JamahaW/VART-Project/Изображения/Меню_Подготовки.jpg

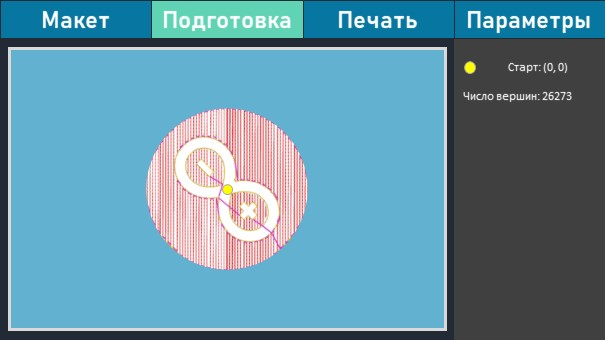
Изображения/Меню_Подготовки.jpg
