JamahaW/VART-Project/Изображения/РисунокПлоттера.jpg

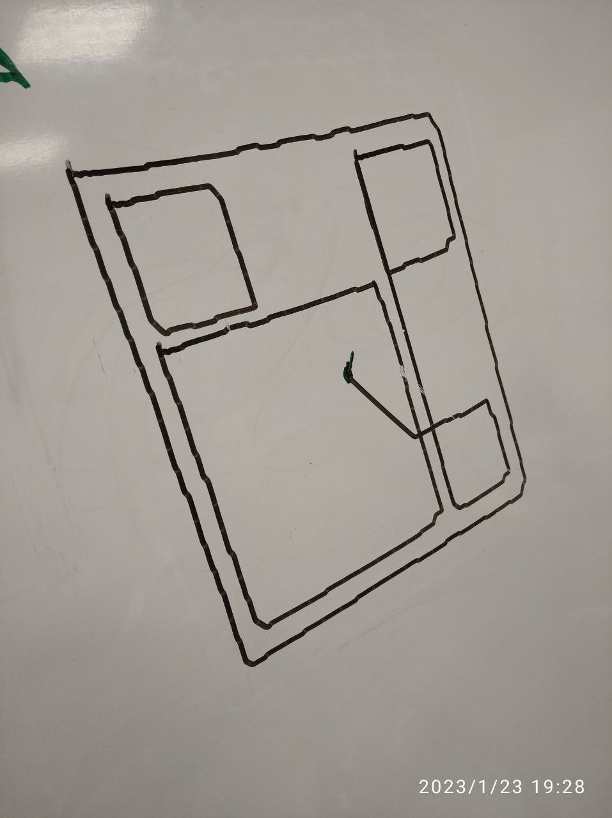
Изображения/РисунокПлоттера.jpg
