JamahaW/VART-Project/Документация/Презентации/Презентация3.pptx

Подготовка изображения для печати

1. Загрузка
изображения
2. Применение
фильтров
3. Расчёт
маршрута

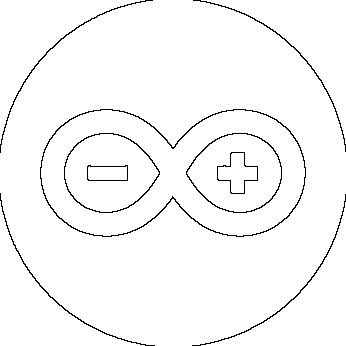
[picture p3: figure]

Алгоритм программы

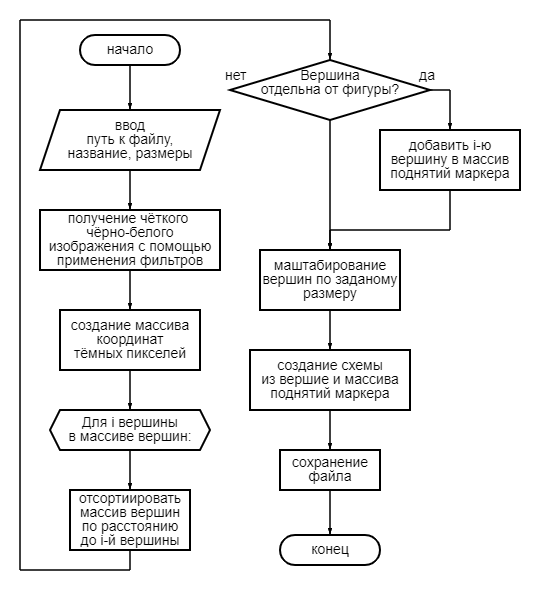
[picture p4: figure]
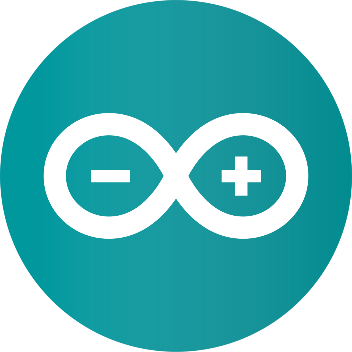
[picture p5: figure]
Arduino Logo PNG Transparent (1) – Brands Logos
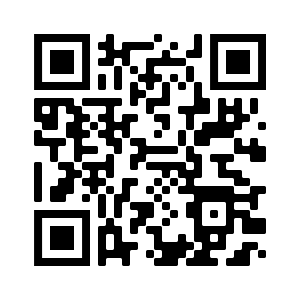
[picture p6: figure]
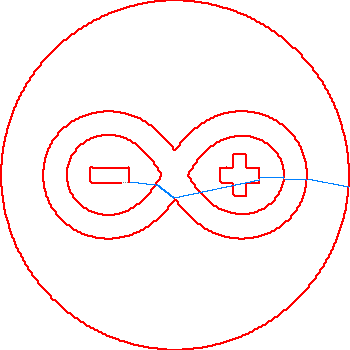
[picture p7: figure]

Исходный код конвертера изображений

Ссылка: https://github.com/JustPret/png2schem
