JamahaW/VART-Project/Документация/Презентации/Презентацияплоттер(2).pptx

## Вертикальный Маркерный плоттер

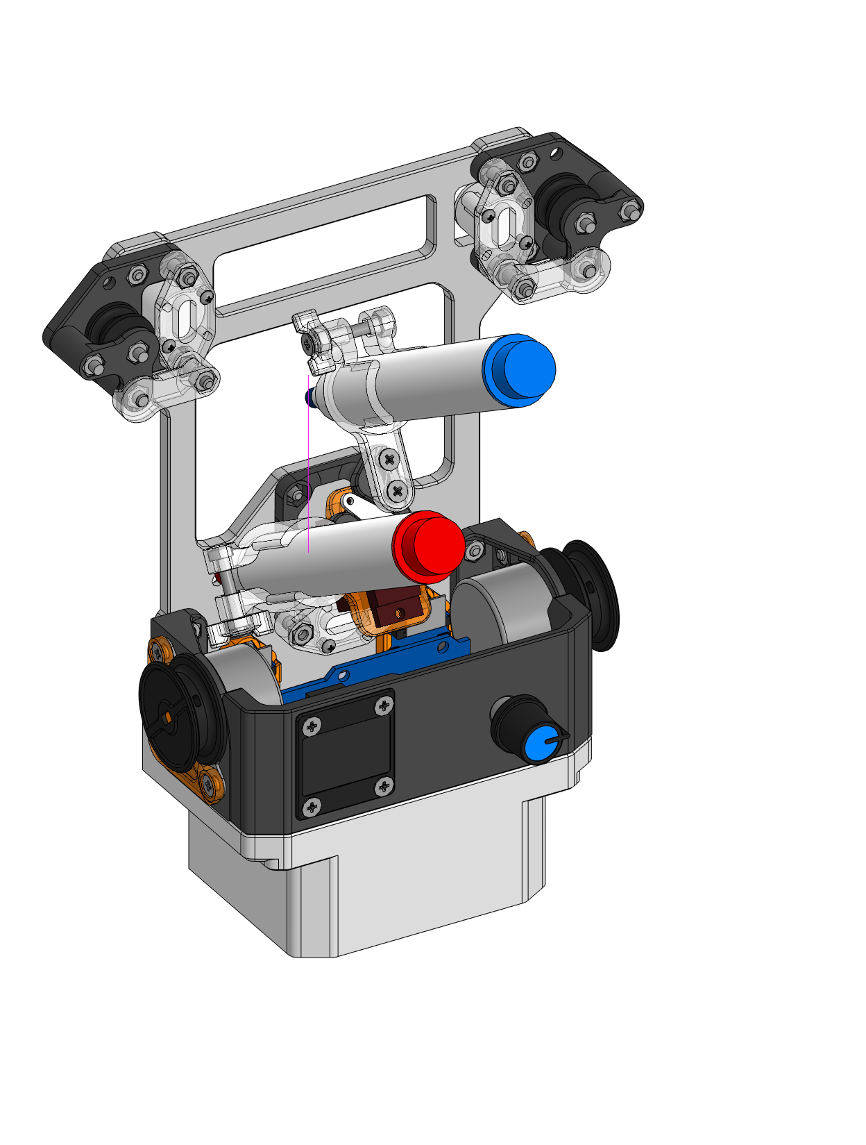
[picture p8: figure]

Выполнил: Наумов Максим Геннадьевич
Ученик ГАОУ школы №548

## Проблема и актуальность

- Для улучшения запоминания материала учителя могут рисовать памятки по теме, этот процесс занимает некоторое время, его можно автоматизировать, таким образом повысить качество материала и производительность рисования.
- Графическое оформление стен помещений широко применяется в дизайне.

## Пример оформления класса информатики к новому году

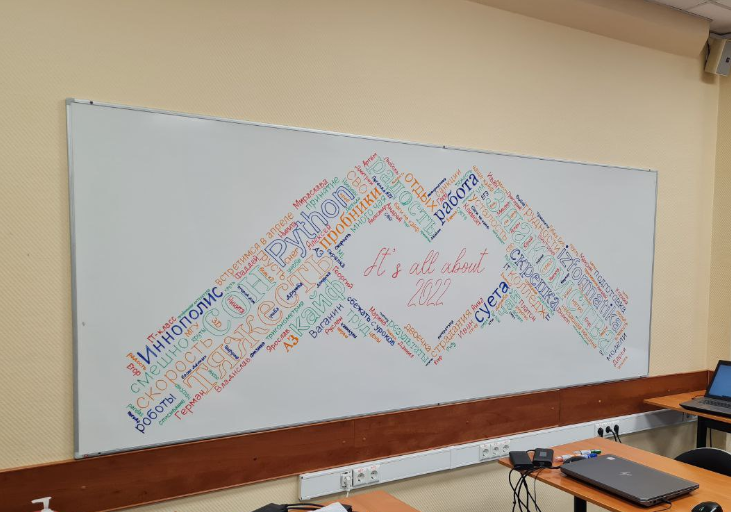
[picture p9: figure]

## Цель проекта

Создать устройство, автоматизирующее процесс рисования на маркерных досках

## Задачи проекта

- Изучить затраты времени на подготовку графических материалов по теме урока.
- Рассмотреть способы автоматизации рисования
- Разработка и сборка прототипа устройства
- Тестирование
- Анализ недостатков и улучшение изделия

## Slide 6

Ход разработки

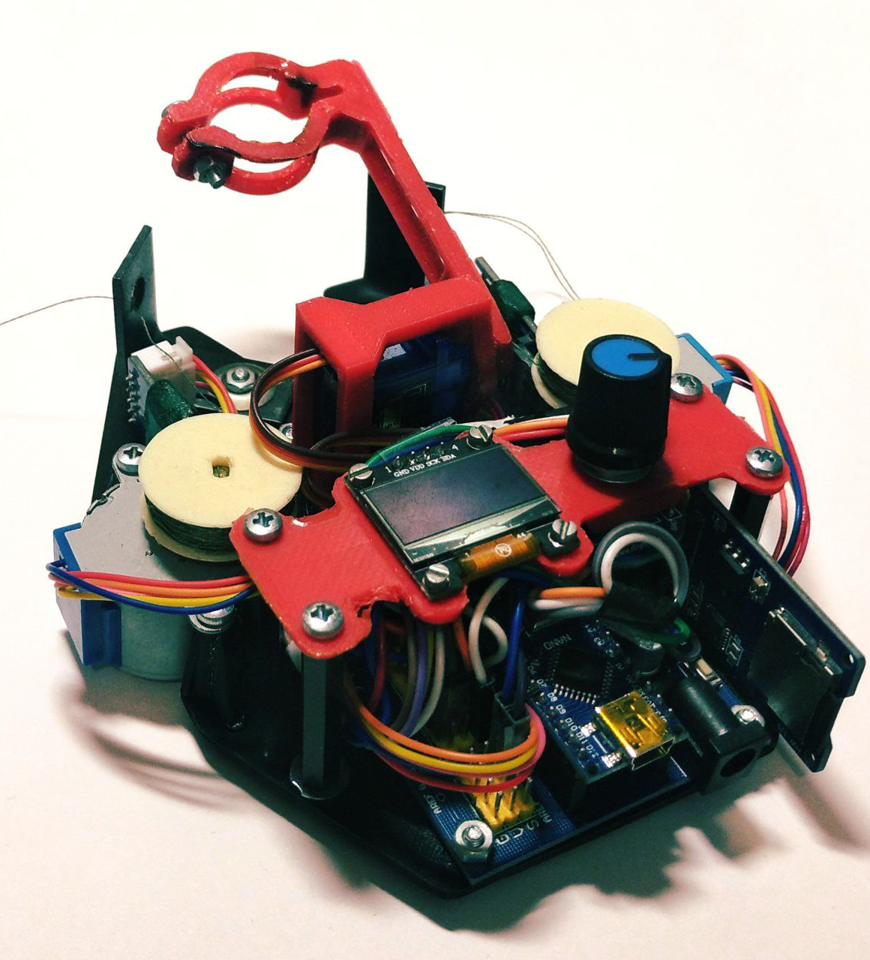
[picture p10: figure]

Прототип

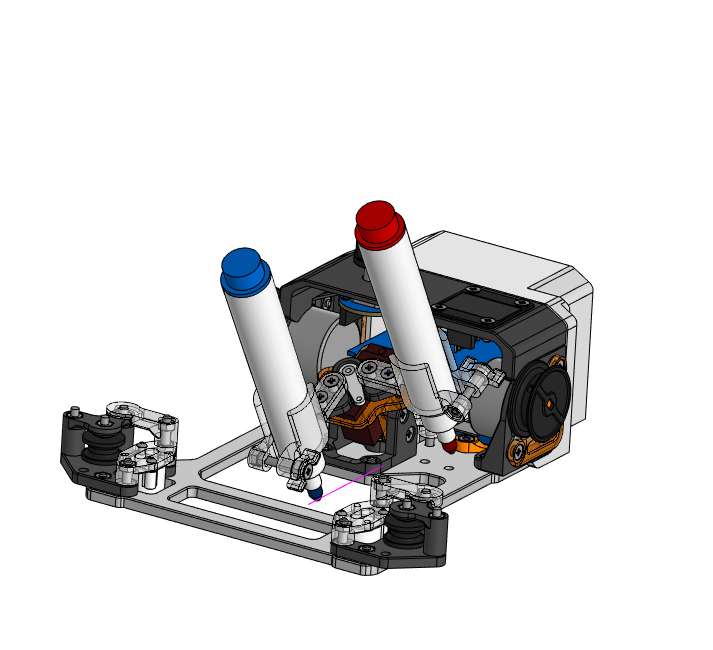
[picture p11: figure]

Текущая Модель изделия

## Работа плоттера

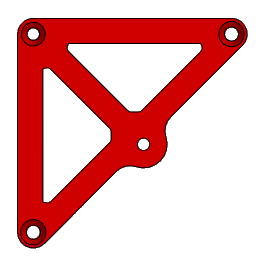
[picture p12: figure]
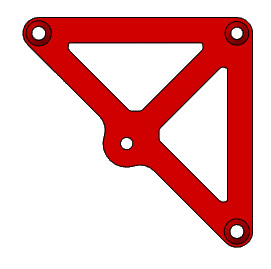
[picture p13: figure]
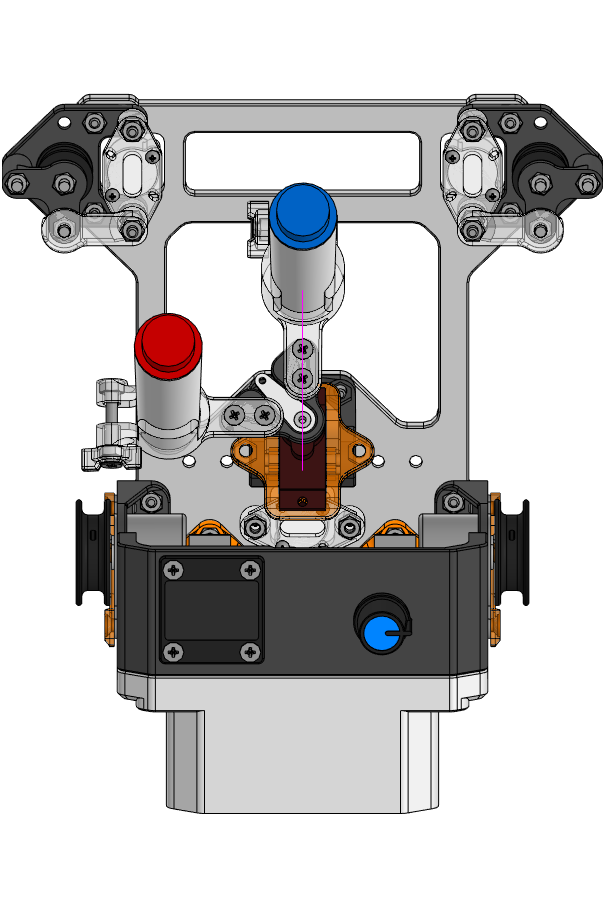
[picture p14: figure]

## Уголок-крепёж

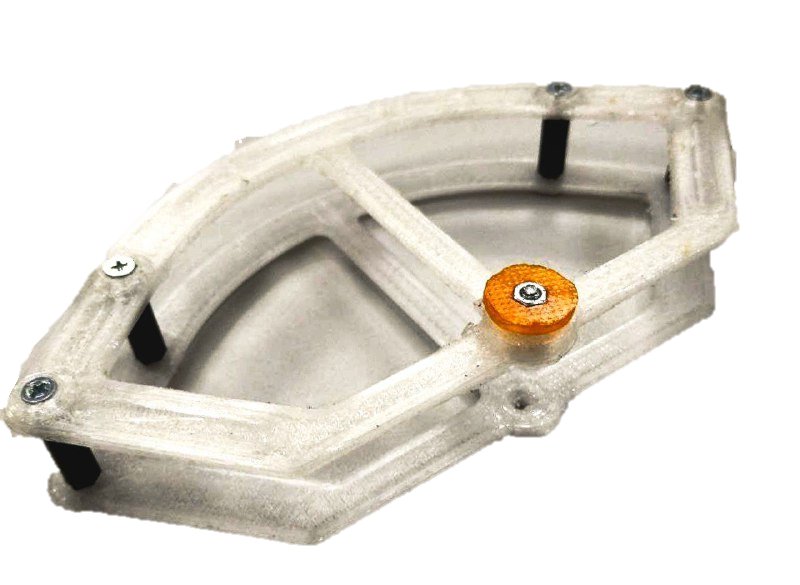
[picture p15: figure]

- Опора на маркерную доску

- Место крепления троса

## Привод намотки

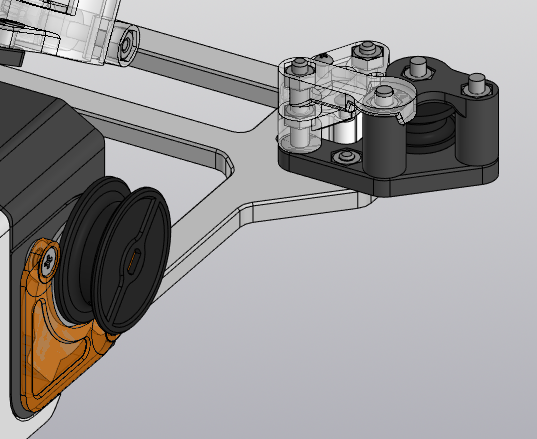
[picture p16: figure]

- Перенаправляющий ролик

- Шкив намотки

## Механизм смены цвета

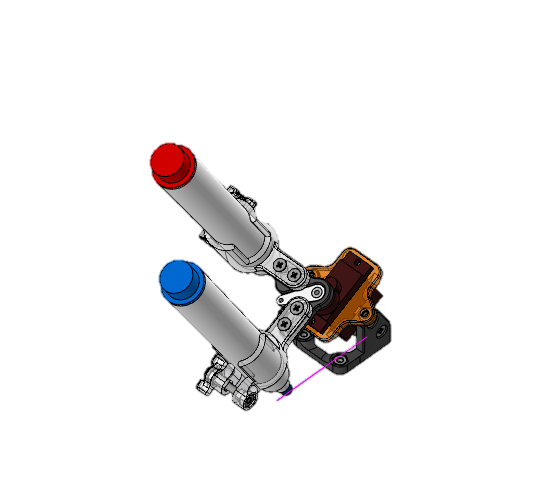
[picture p17: figure]
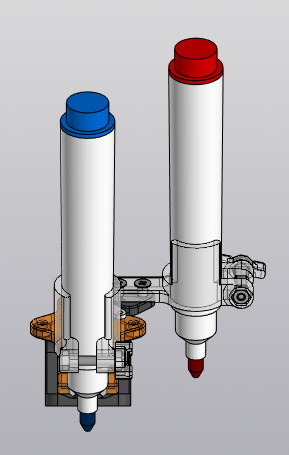
[picture p18: figure]
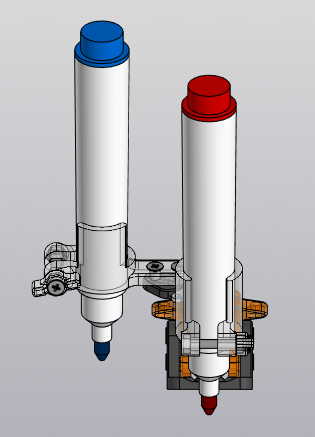
[picture p19: figure]
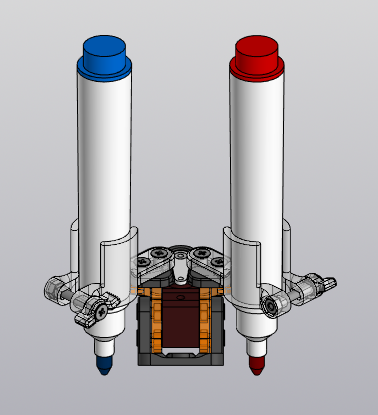
[picture p20: figure]

Угол поворота сервопривода меняет ведущий маркер.

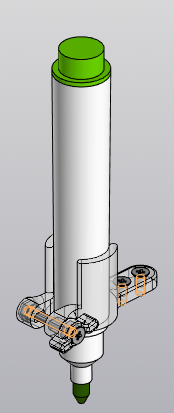
[picture p21: figure]

сервопривод

- Маркер

- Зажим с вариативным выбором нажатия

- Регулировка зажима

## Подготовка изображения к печати

Arduino Logo PNG Transparent (1) – Brands Logos

Исходное изображение

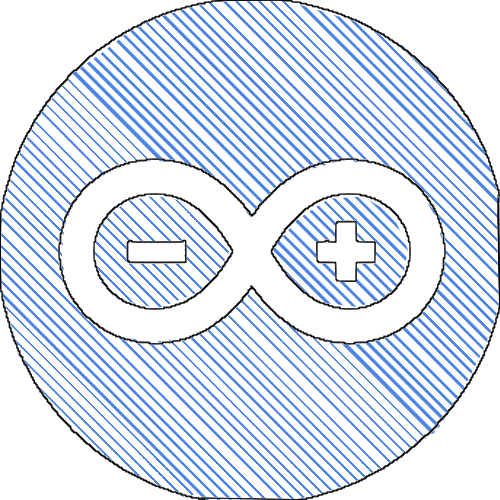
[picture p22: figure]

Задание параметров
рисования

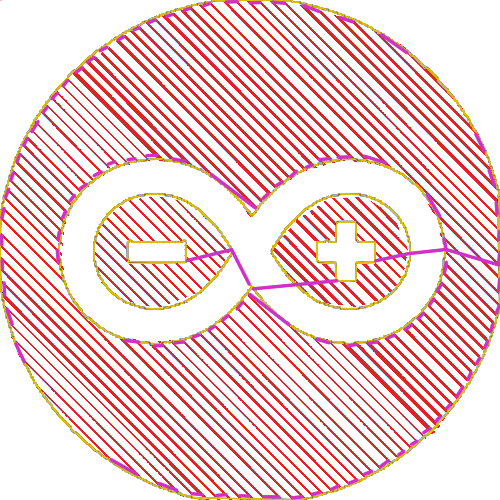
[picture p23: figure]

Расчёт
маршрута

## Функциональная схема

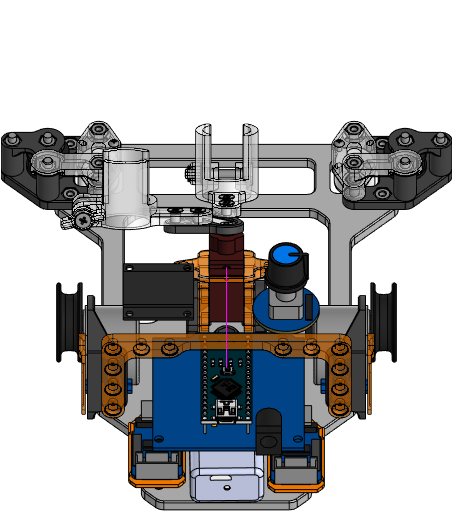
[picture p24: figure]

Маркерный плоттер без корпуса

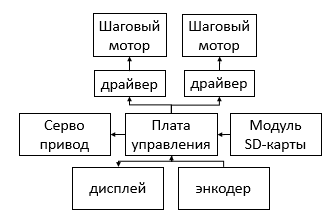
[picture p25: figure]

## Slide 13

Выбор электронных компонентов

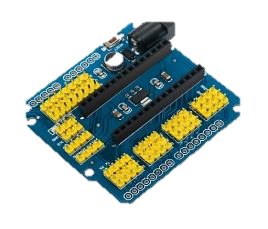
[picture p26: figure]
Плата расширения для Arduino Nano (Arduino Nano Shield V3.0) купить в Алматы

Плата расширения Nano

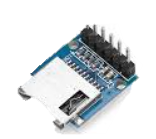
[picture p27: figure]

Mini Micro SD
Card Reader Module

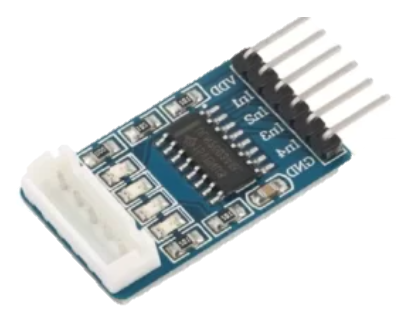
[picture p28: figure]
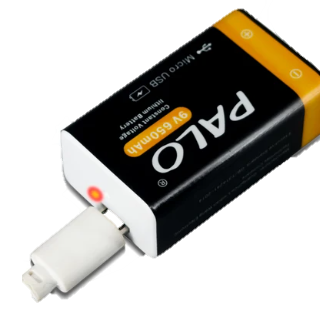
[picture p29: figure]

Аккумулятор 9B

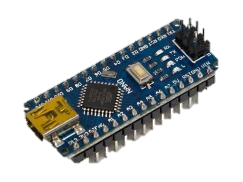
[picture p30: figure]
Купить Arduino NANO V 3.0 CH340G Arduino/ESP/Raspberry Pi (Доставка РФ,СНГ)

Arduino Nano

Драйвер ULN2003

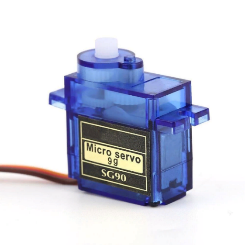
[picture p31: figure]

Сервопривод SG90

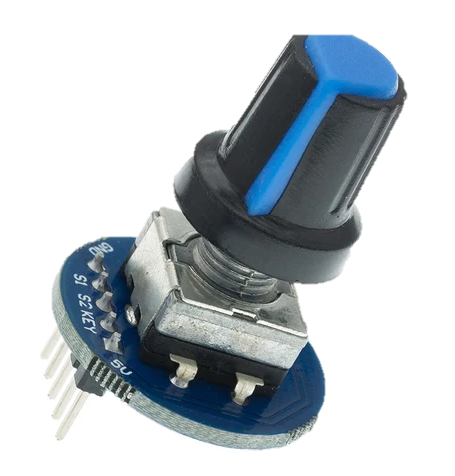
[picture p32: figure]

Энкодер

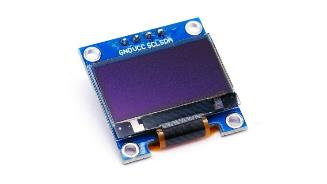
[picture p33: figure]
Nettigo: OLED Display 0.96" I2C 128x64 SSD1306 white [Yā nǔ shén]

OLED дисплей

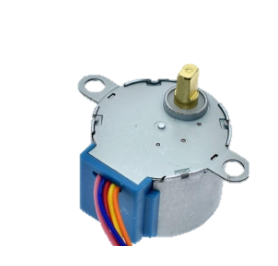
[picture p34: figure]

Шаговый двигатель 28BYJ-48

## Оценка стоимости изделия

1676 рублей

- 1230р – электронные компоненты
- 350р – 3D-печать пластиковых деталей
- 96р – крепёжные изделия

## Электрическая схема изделия

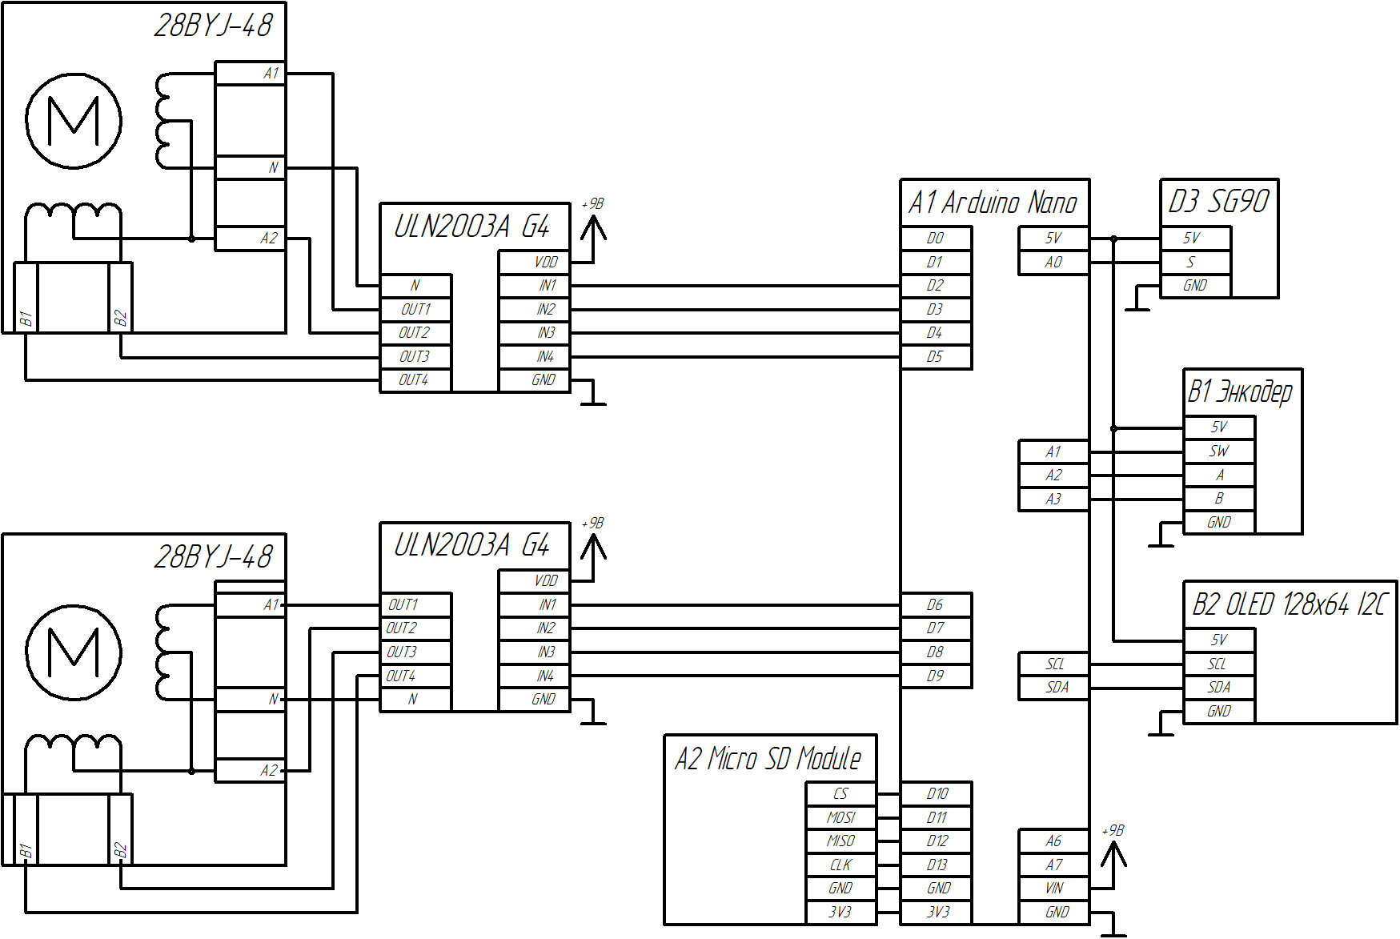
[picture p35: figure]

## Slide 16

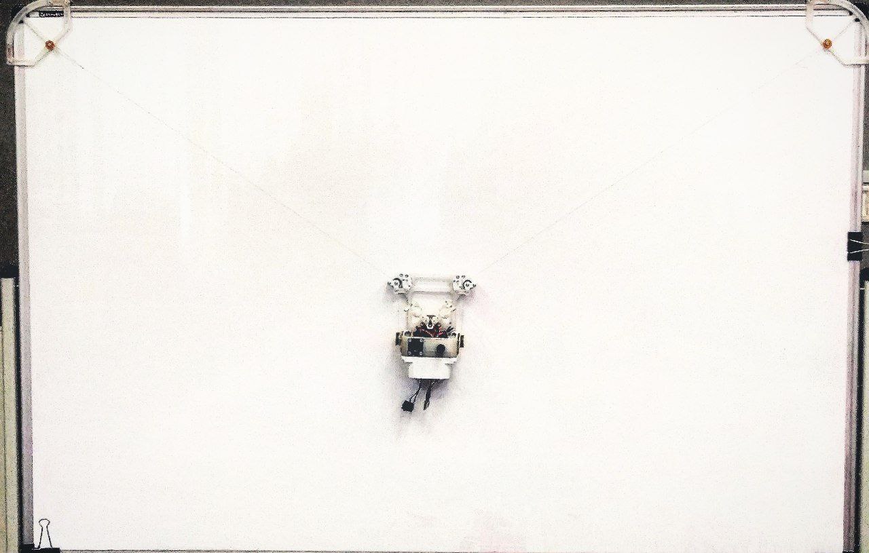
[picture p36: figure]
