JamahaW/VART-Project/Документация/Презентации/Презентацияплоттер_старая!!!!.pptx

## Вертикальный Маркерный плоттер


Выполнил: Наумов Максим Геннадьевич
Ученик ГАОУ школы №548

## Проблема и актуальность

- Для улучшения запоминания материала учителя могут рисовать памятки по теме, этот процесс занимает некоторое время, его можно автоматизировать, таким образом повысить качество материала и производительность рисования.
- Графическое оформление стен помещений широко применяется в дизайне.
*большие площади
*автоматизация дизайна

## Пример оформления класса информатики к новому году


## Цель проекта

Создать устройство, автоматизирующее процесс рисования на маркерных досках

## Задачи проекта

- Изучить затраты времени на подготовку графических материалов по теме урока.
- Рассмотреть способы автоматизации рисования
- Разработка и сборка прототипа устройства
- Тестирование
- Анализ недостатков и улучшение изделия
- Тестирование
- Выводы

## Slide 6

Ход разработки


Прототип


Текущая Модель изделия

## Работа плоттера


## Уголок-крепёж

- Опора на маркерную доску

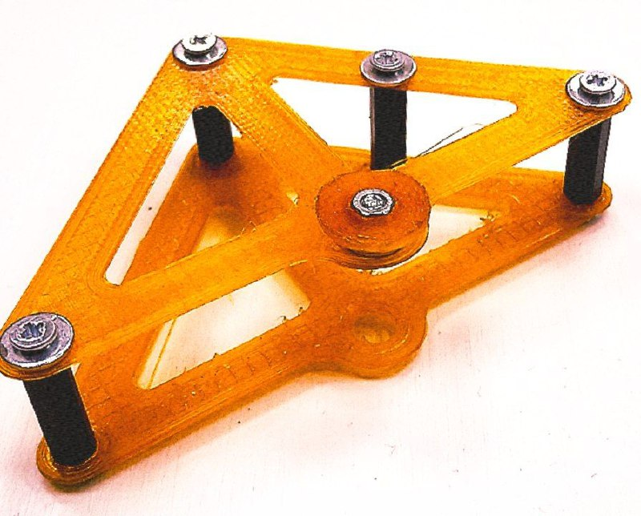
[picture p37: figure]

- Место крепления троса

## Привод намотки


- Перенаправляющий ролик

- Шкив намотки

## Механизм смены цвета


Угол поворота сервопривода меняет ведущий маркер.


сервопривод

- Маркер

- Зажим с вариативным выбором нажатия

- Регулировка зажима

## Подготовка изображения к печати

Arduino Logo PNG Transparent (1) – Brands Logos

Исходное изображение


Задание параметров
рисования


Расчёт
маршрута

## Функциональная схема


Маркерный плоттер без корпуса


## Slide 13

Выбор электронных компонентов

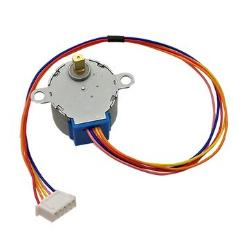
[picture p38: figure]
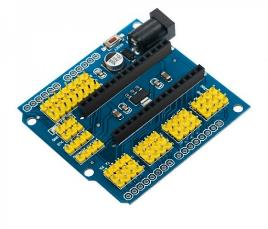
[picture p39: figure]
Плата расширения для Arduino Nano (Arduino Nano Shield V3.0) купить в Алматы
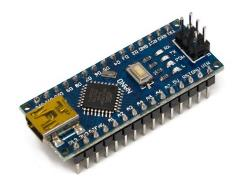
[picture p40: figure]
Купить Arduino NANO V 3.0 CH340G Arduino/ESP/Raspberry Pi (Доставка РФ,СНГ)
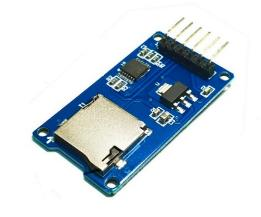
[picture p41: figure]
SD Card модуль

Плата расширения Nano
200р

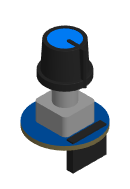
[picture p42: figure]

Энкодер
60р

Arduino Nano
250р

Nettigo: OLED Display 0.96" I2C 128x64 SSD1306 white [Yā nǔ shén]

OLED дисплей
140р

Mini TF Card Module
40р


Сервопривод SG90
300р

(2шт.) Шаговый мотор 28BYJ-48
180р

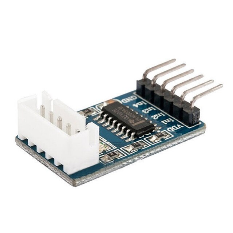
[picture p43: figure]

(2шт.) Драйвер ULN2003
50р

## Оценка стоимости изделия

1660 рублей

- 1220р – электронные компоненты
- 350р – 3D-печать пластиковых деталей
- 90р – крепёжные изделия

## Электрическая схема изделия
