JamahaW/VART-Project/Документация/Компоненты.pdf

# Выбор электронных компонентов

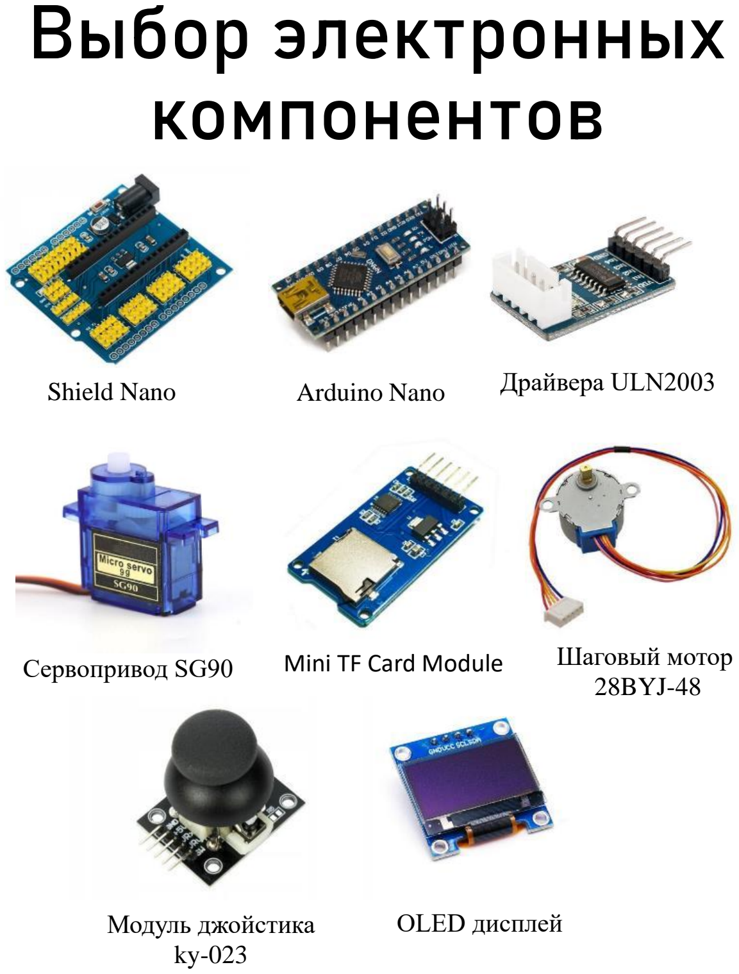
[picture p44: page 1]

Shield Nano | Arduino Nano
Cервопривод SG90 | Mini TF Card Module

Драйвера ULN2003

Шаговый мотор
28BYJ-48

Модуль джойстика
ky-023

OLED дисплей
