JamahaW/VART-Project/Документация/Выступлениечерновик2план.docx

Выступление новый черновик

План

Введение

- об учителях, которые рисуют схемы

- о китайской поделке

- о том, что я решил это сделать

- об актуальности графического оформления

Цель

- о том, что решил создать. Т.к. это актуально.

- сформулировал ряд задач

Разработка

- об изучении технологии печати

- о разновидностях манипуляторов + упоминание китайской поделки

- о тросовых роботах

Шаги разработки

-шаг 1

-шаг 2

-шаг 3

-шаг финал

- о конструкции

Конвертер схемы

-процесс конвертации

-о формате файла

- о меню плоттера

Вывод

- о проведённых испытаниях + о стоимости

- о том, что устройство уже использовалось + хорошо

- об улучшении отрисовке текста и это вина нарезчика

-о других применениях конструкции (зондирование)
