JamahaW/VART-Project/Документация/Алгоритм_плоттера.pdf

# Алгоритм плоттера

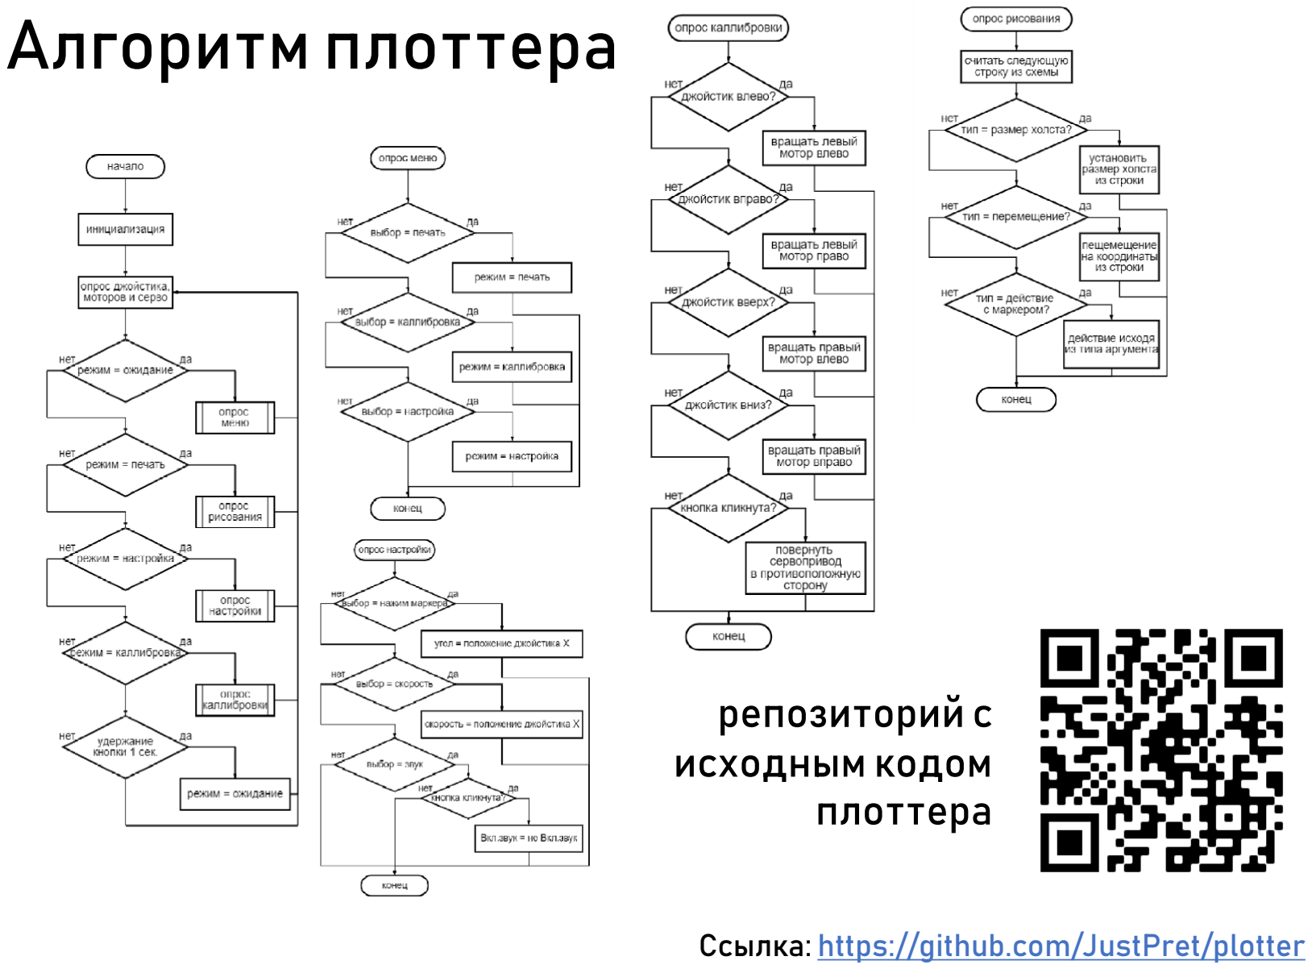
[picture p80: page 1]

Ссылка: https://github.com/JustPret/plotter

## репозиторий с исходным кодом плоттера
