JamahaW/VART-Project/Документация/Алгоритмы.pdf

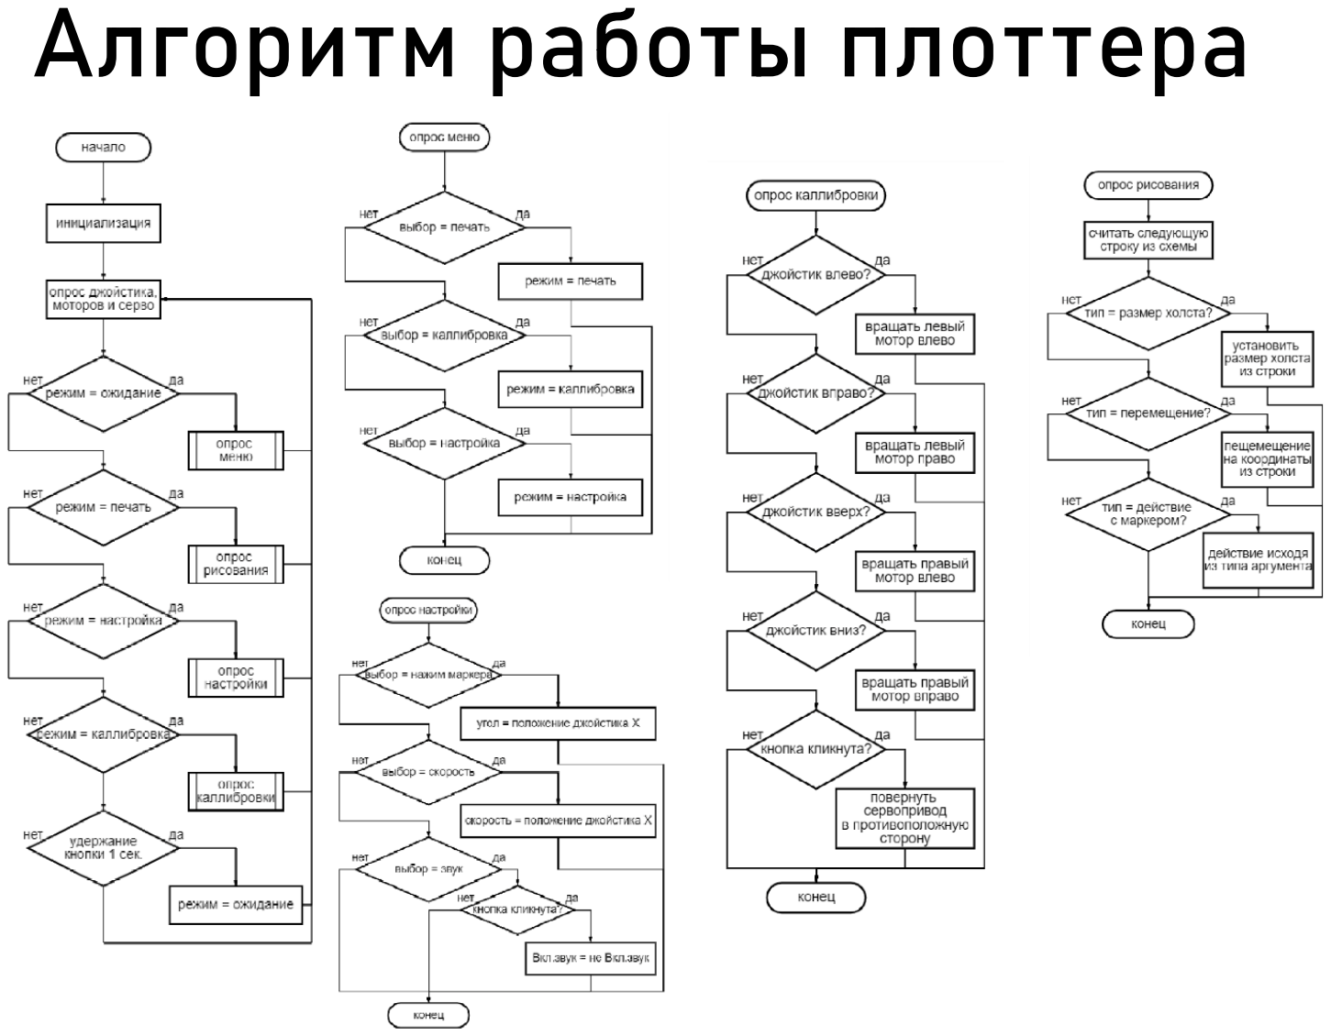
[picture p81: page 1]

Алгоритм работы плоттера
