JamahaW/VART-Project/Документация/Вид_плоттера.pdf

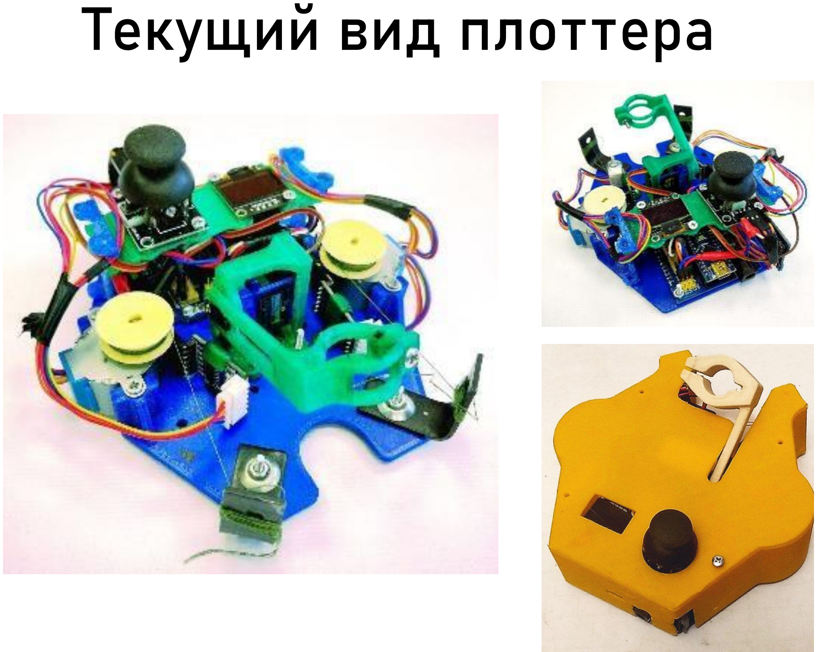
[picture p82: page 1]

Текущий вид плоттера
