JamahaW/VART-Project/Документация/Изображение.pdf

## Подготовка изображения для печати

## 1. Загрузка

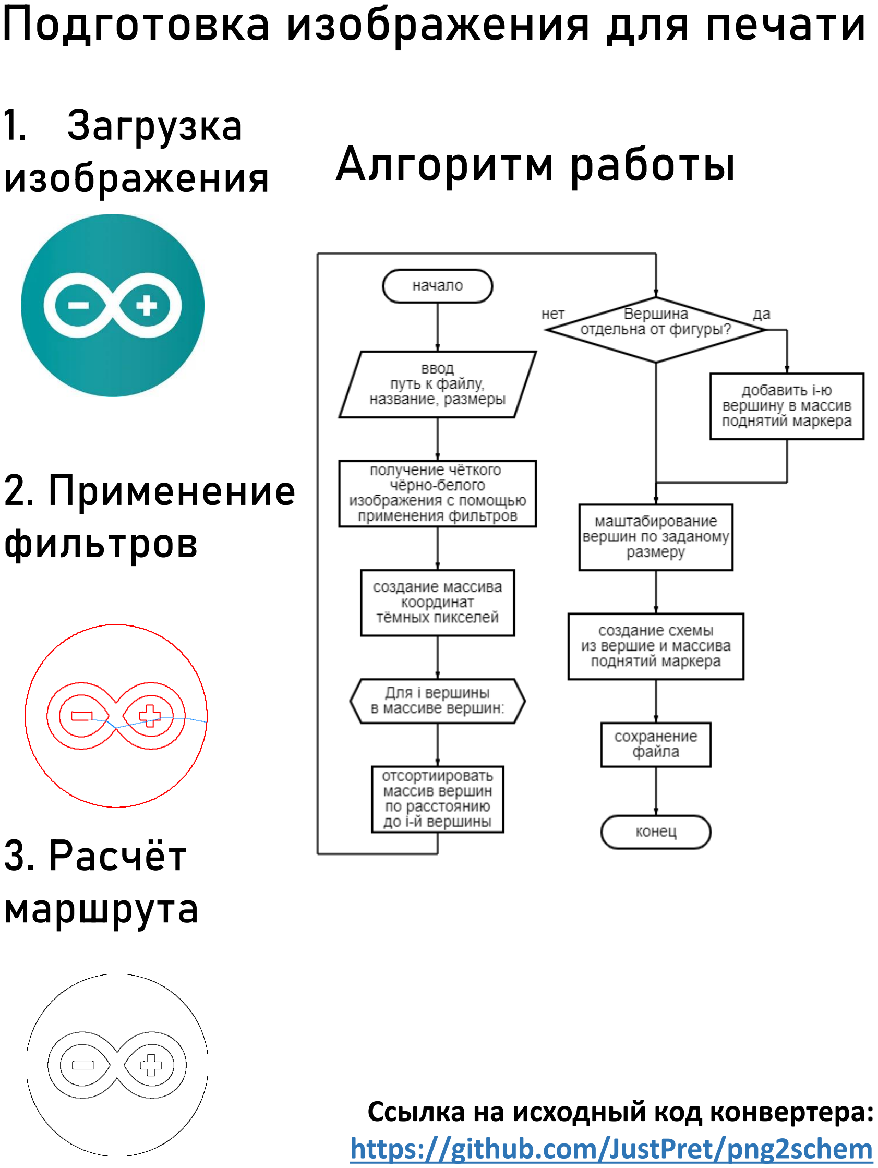
[picture p83: page 1]

Ссылка на исходный код конвертера: https://github.com/JustPret/png2schem

## изображения

## 2. Применение фильтров

## 3. Расчёт маршрута

## Алгоритм работы
