JamahaW/VART-Project/Документация/Отзыв-наумовмаксим.pdf

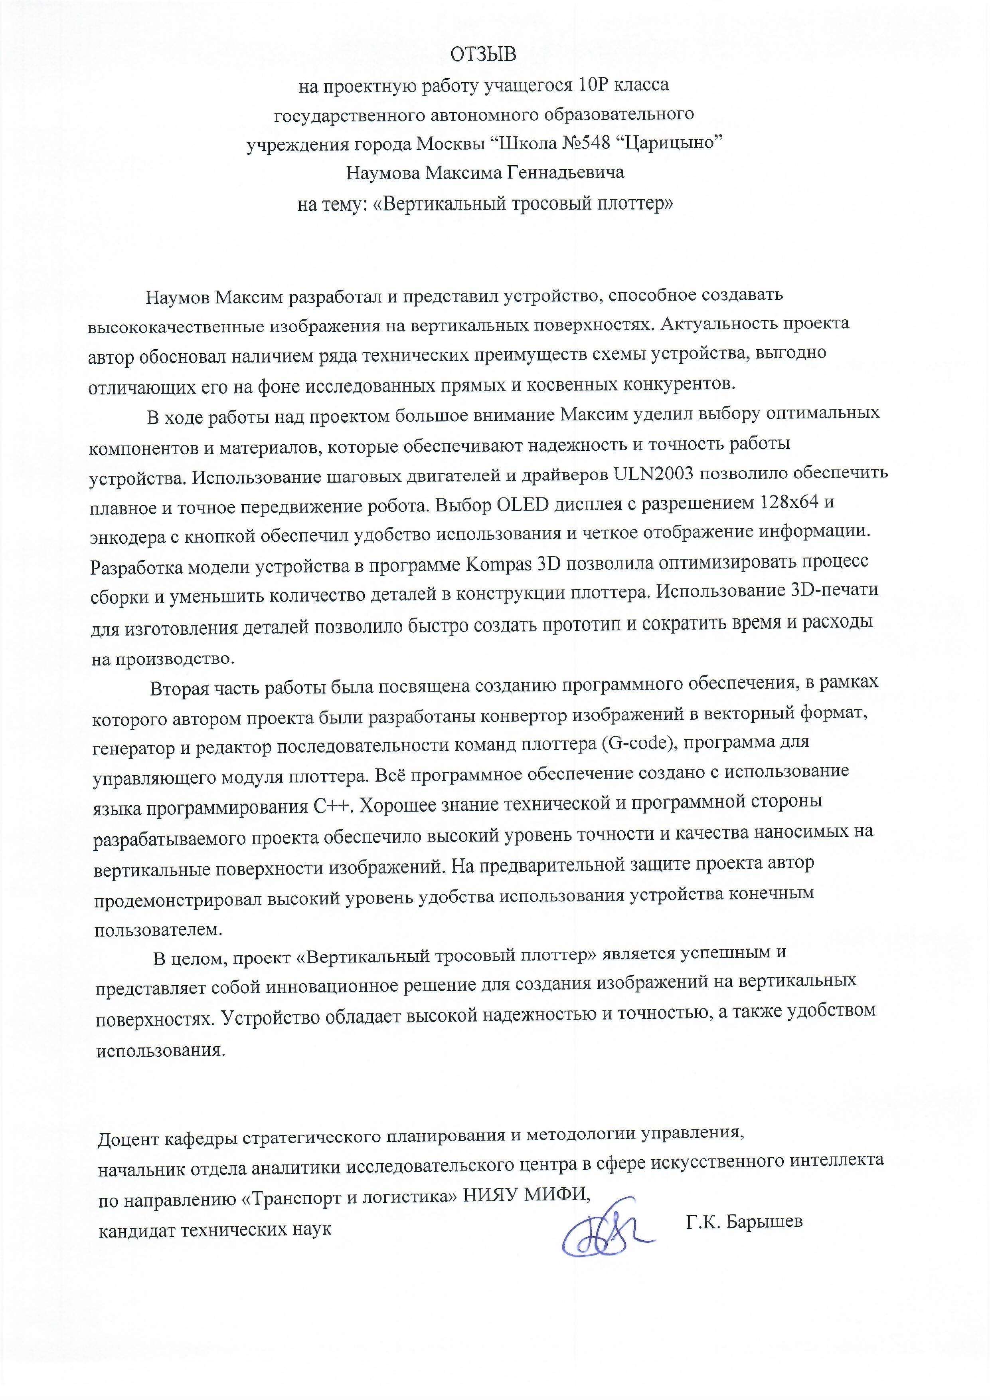
[picture p84: page 1]
