JamahaW/VART-Project/Документация/Плоттерфиналсракурсов.pdf

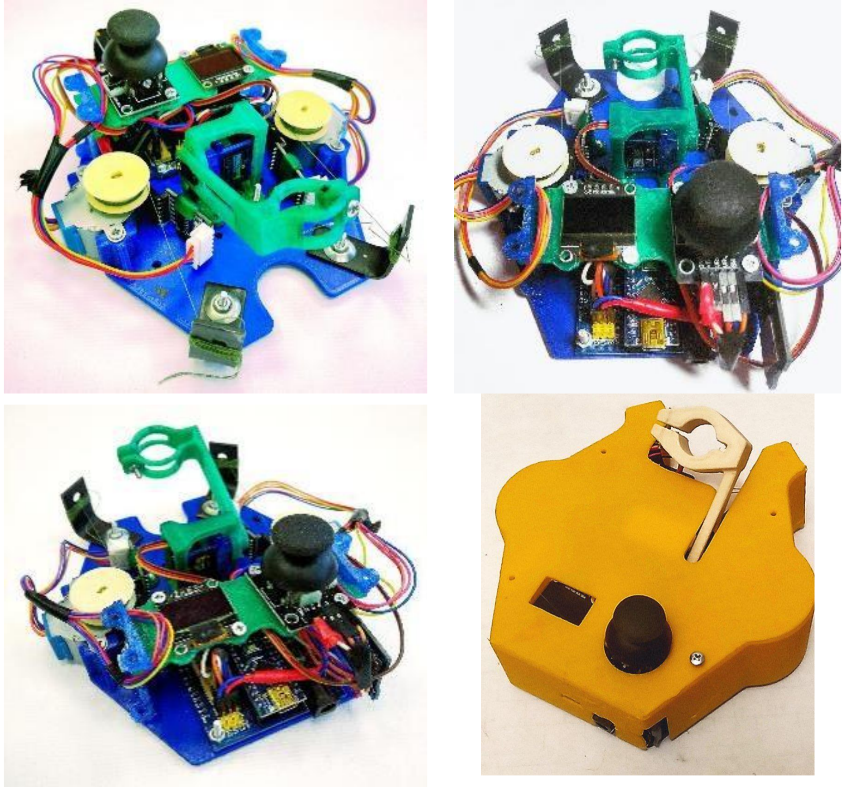
[picture p154: page 1]
