JamahaW/VART-Project/Документация/Презентация_210224.pdf

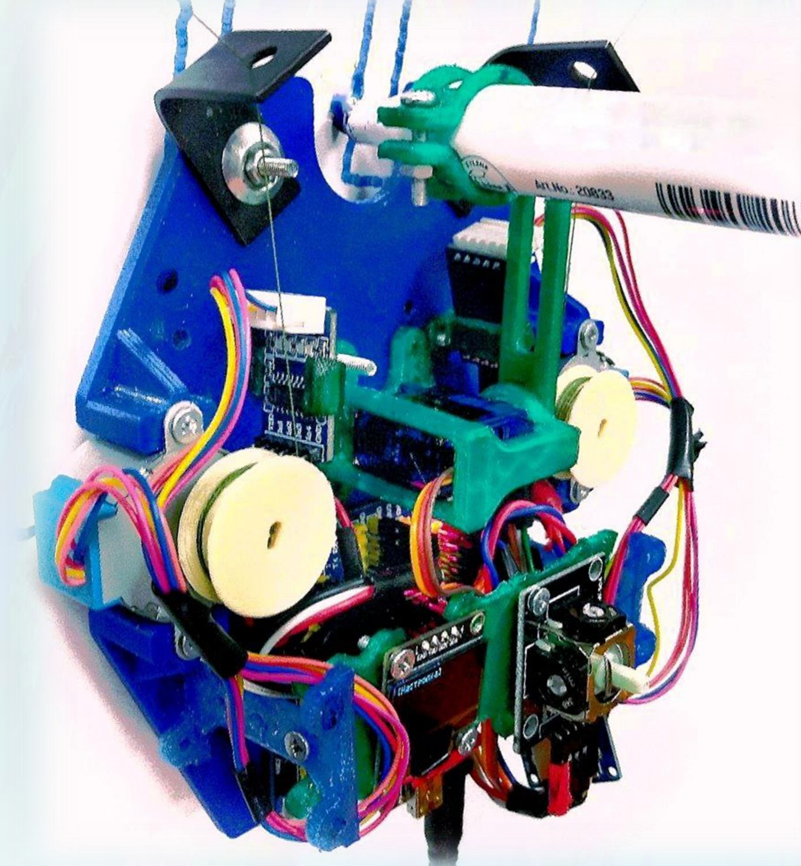
[picture p155: figure]

# Проект «Маркерный настенный плоттер»

Выполнил:
Наумов Максим Геннадьевич
Руководитель проекта:
Мазуров Максим Олегович

# Актуальность работы

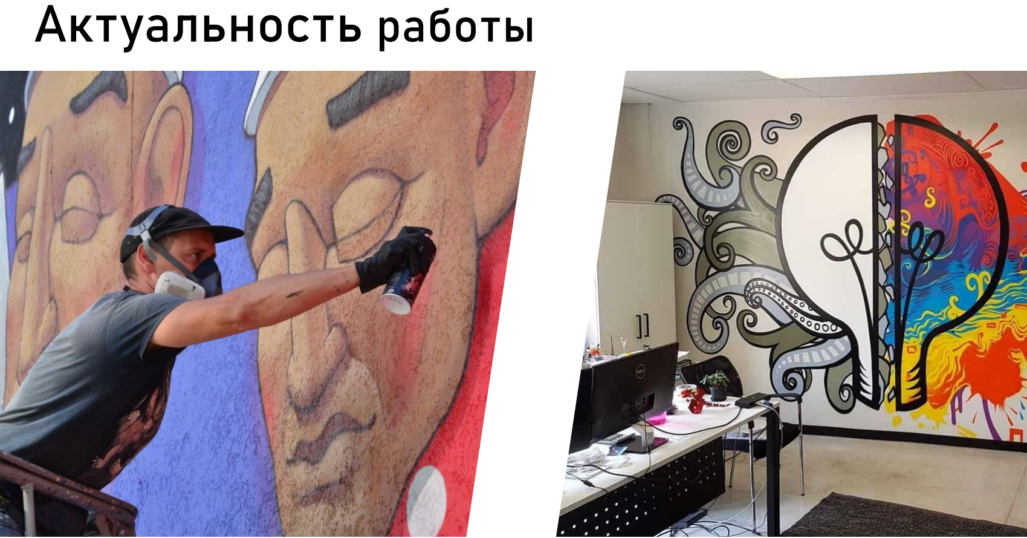
[picture p156: page 2]

## Цель проекта

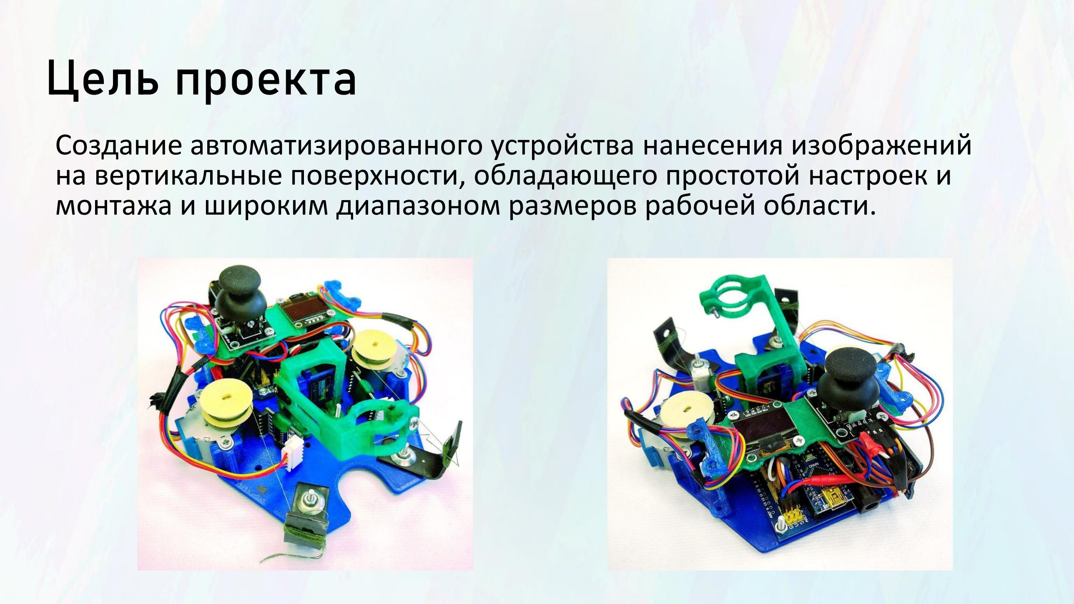
[picture p157: page 3]

Создание автоматизированного устройства нанесения изображений на вертикальные поверхности, обладающего простотой настроек и монтажа и широким диапазоном размеров рабочей области.

## Анализ существующих подходов и решений

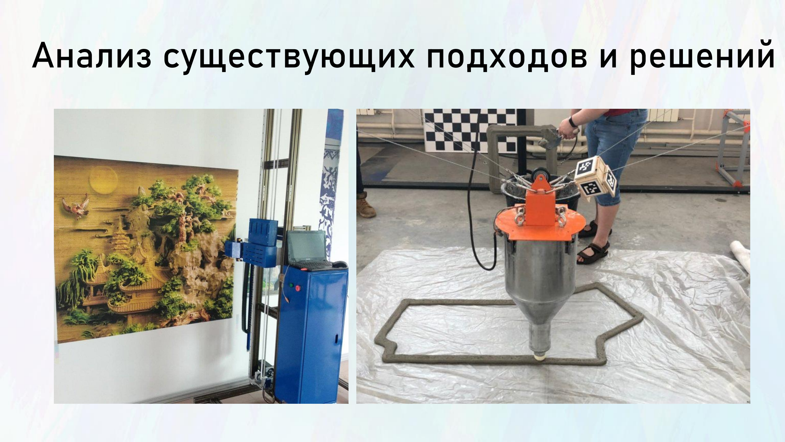
[picture p158: page 4]

## Ход работ

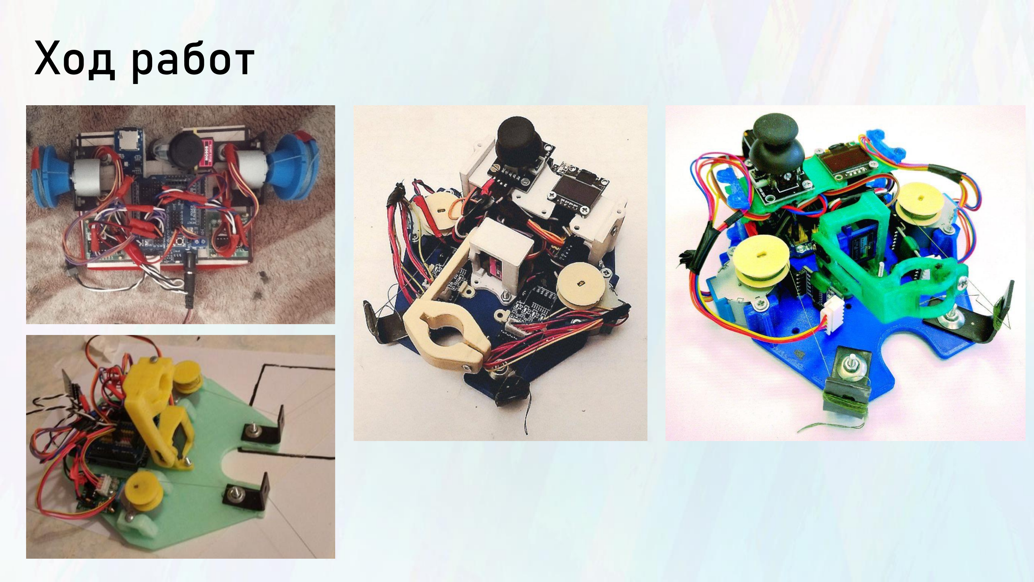
[picture p159: page 5]

## Прототип в действии

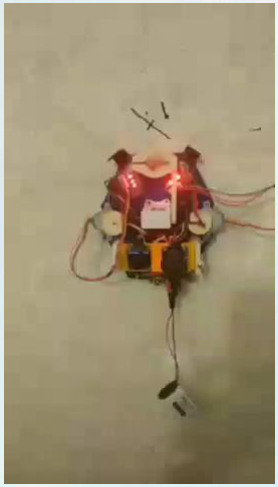
[picture p160: figure]
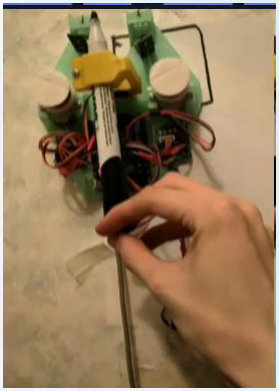
[picture p161: figure]

# Конвертирование изображений

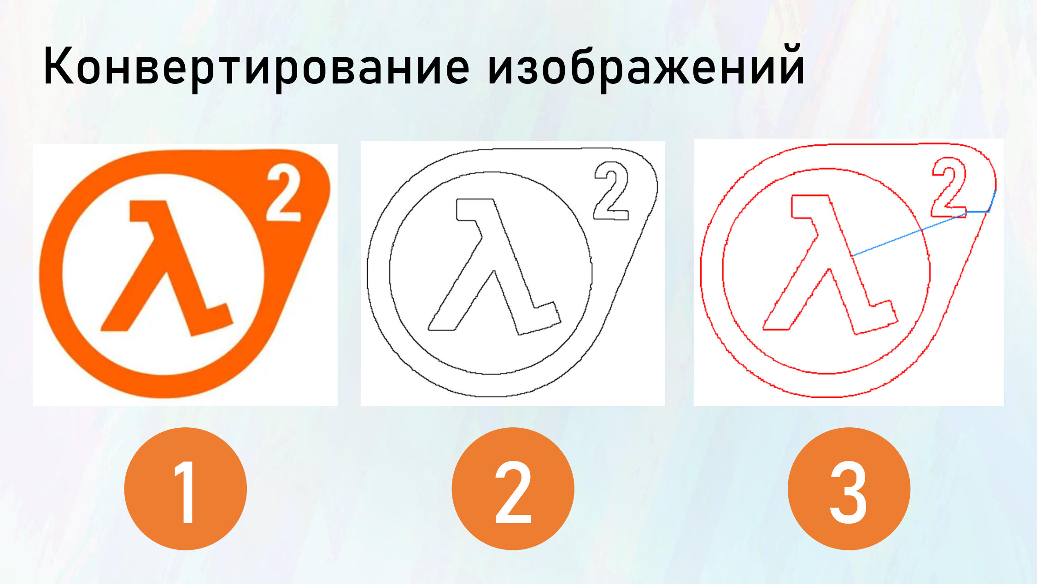
[picture p162: page 7]

1 | 2 | 3

# Обзор аналогов

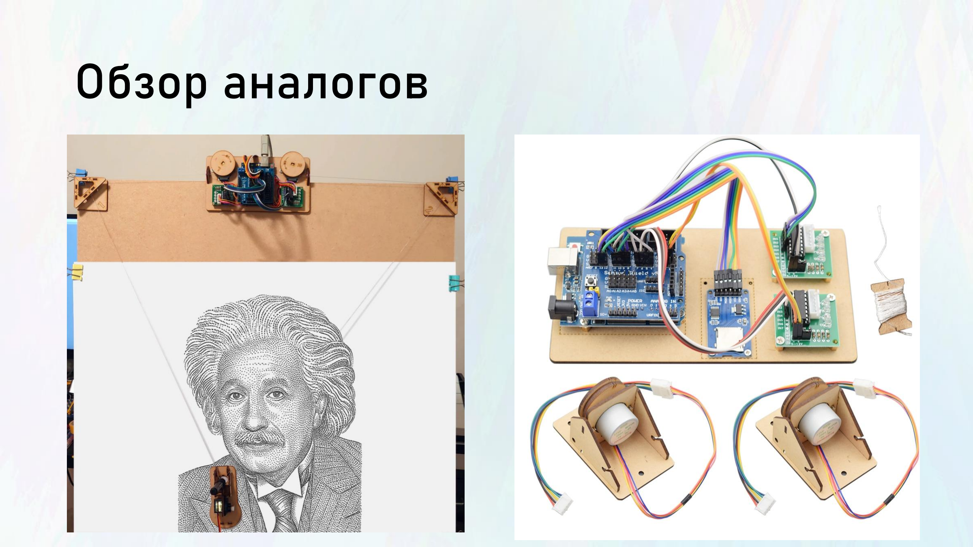
[picture p163: page 8]

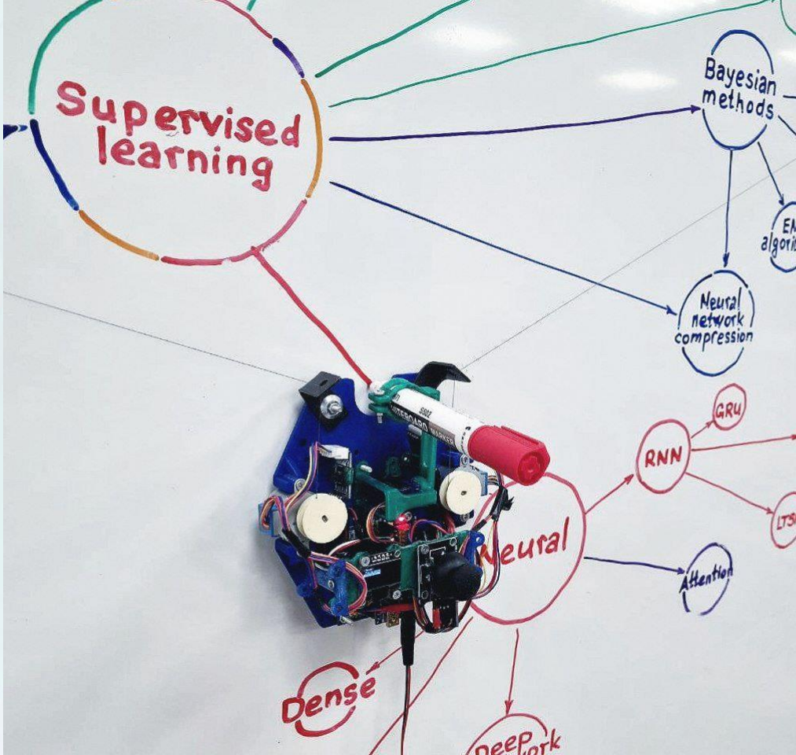
[picture p164: figure]

# Заключение

### Создан работоспособный прототип

Ссылка на репозиторий
с исходным кодом:
https://github.com/JustPret/plotter.git
