JamahaW/VART-Project/Документация/Программаподготовкиизбражений.pdf

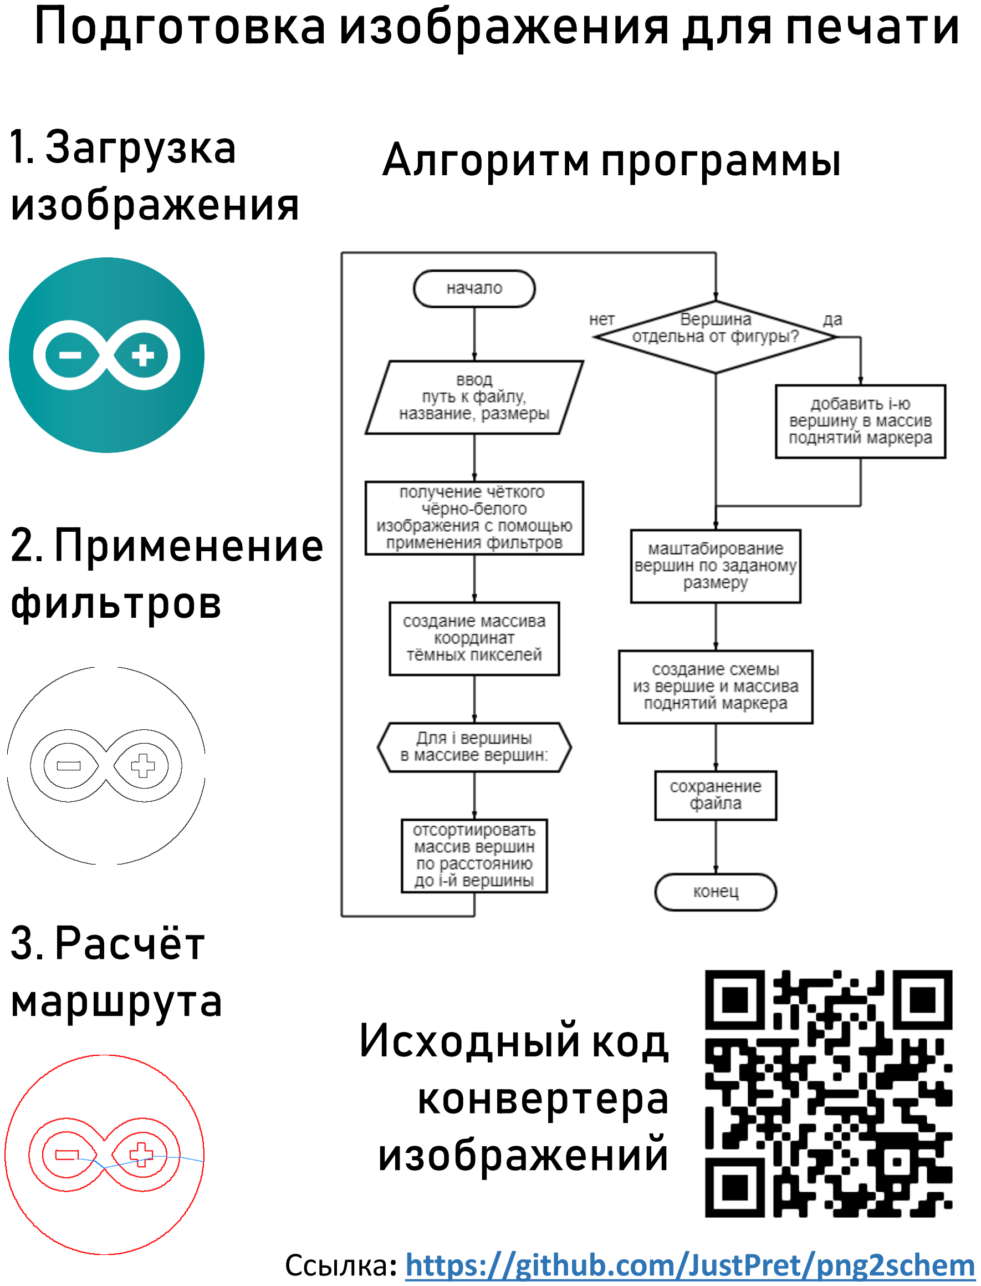
[picture p165: page 1]

1. Загрузка
изображения
2. Применение
фильтров
3. Расчёт
маршрута

Подготовка изображения для печати

Ссылка: https://github.com/JustPret/png2schem

Алгоритм программы

Исходный код
конвертера
изображений
