JamahaW/VART-Project/Документация/Устройствоплоттера.pdf

# Устройство плоттера

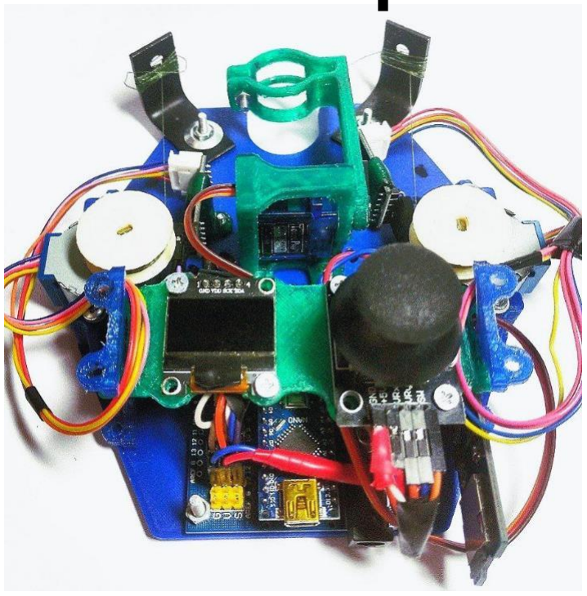
[picture p166: figure]
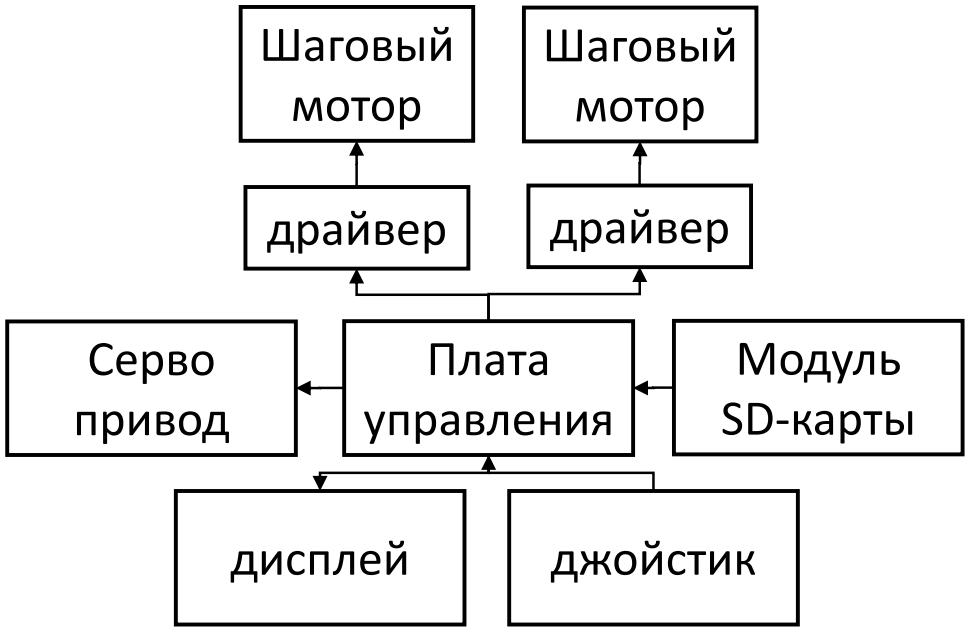
[picture p167: figure]
Плата управления; дисплей; джойстик; Серво привод; Шаговый мотор; драйвер; Модуль SD-карты
