JamahaW/VART-Project/Документация/Ходразработки.pdf

# Ход разработки

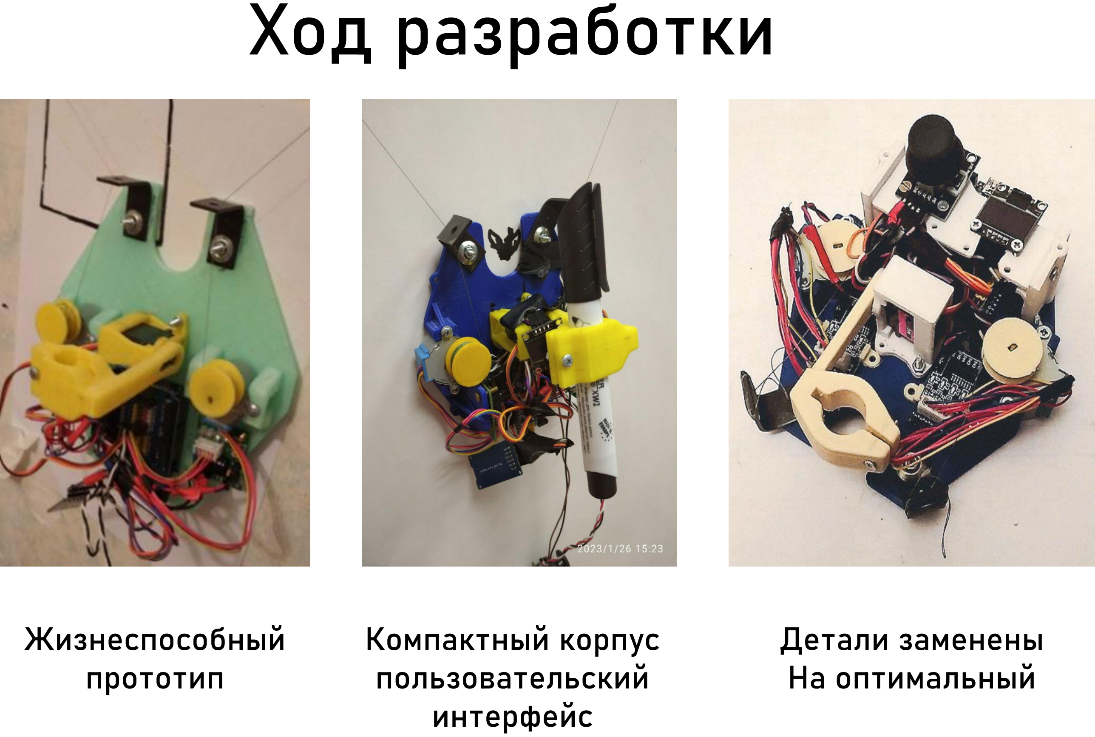
[picture p168: page 1]

Жизнеспособный
прототип

Компактный корпус
пользовательский
интерфейс

Детали заменены
На оптимальный
