JamahaW/VART-Project/Изображения/Bear_Polygon.png

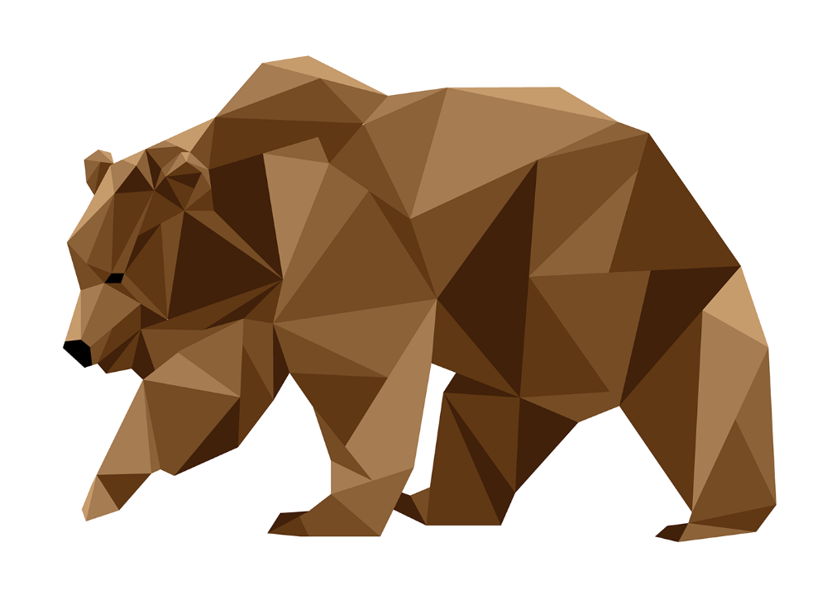
Изображения/Bear_Polygon.png
