JamahaW/VART-Project/Изображения/Cat_Photo.png

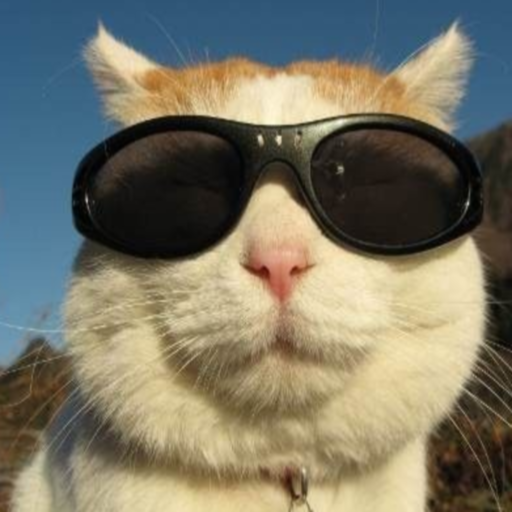
Изображения/Cat_Photo.png
