JamahaW/VART-Project/Изображения/Com_1-2.jpg

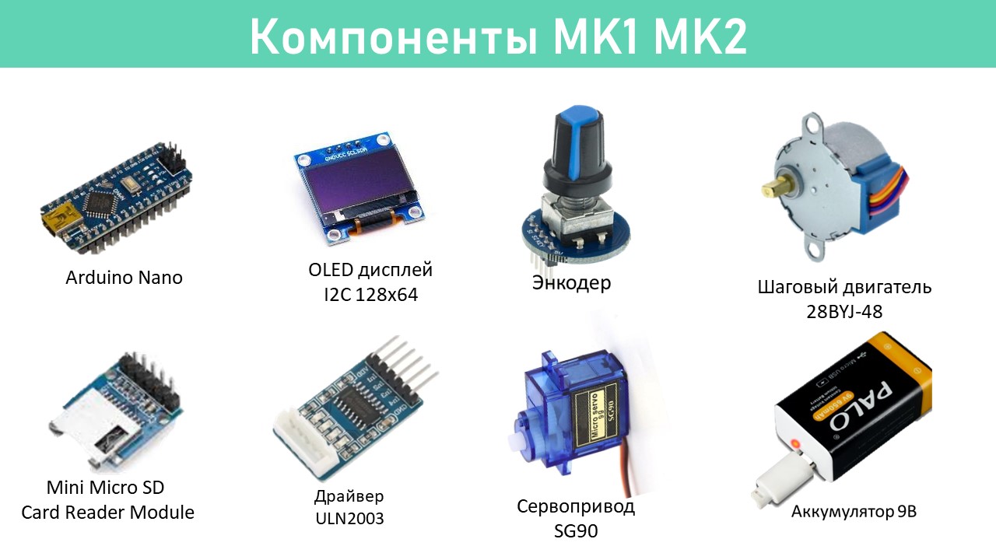
Изображения/Com_1-2.jpg
