JamahaW/VART-Project/Изображения/Com_3jpg.jpg

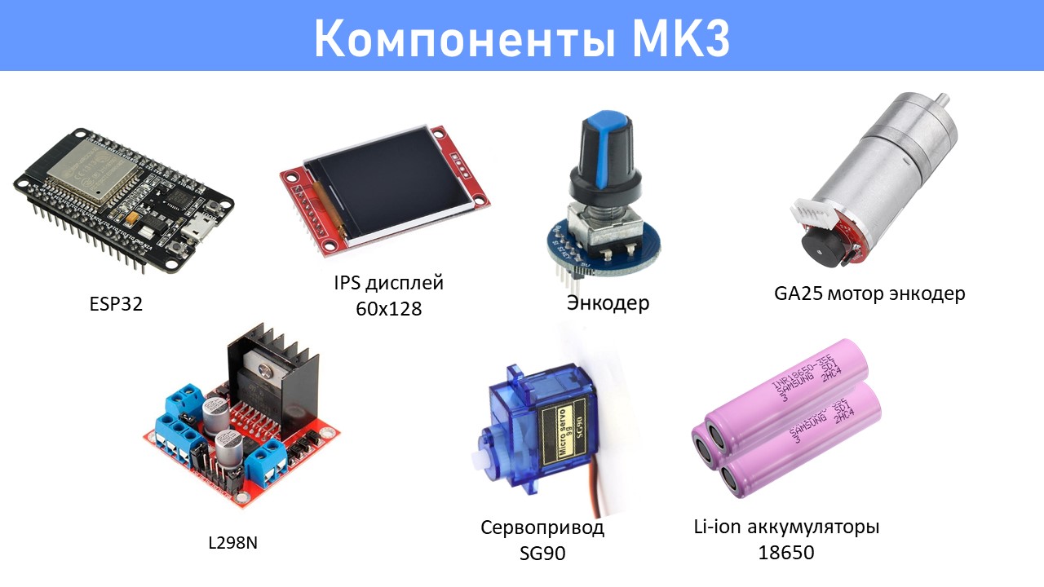
Изображения/Com_3jpg.jpg
