JamahaW/VART-Project/Изображения/А1.png

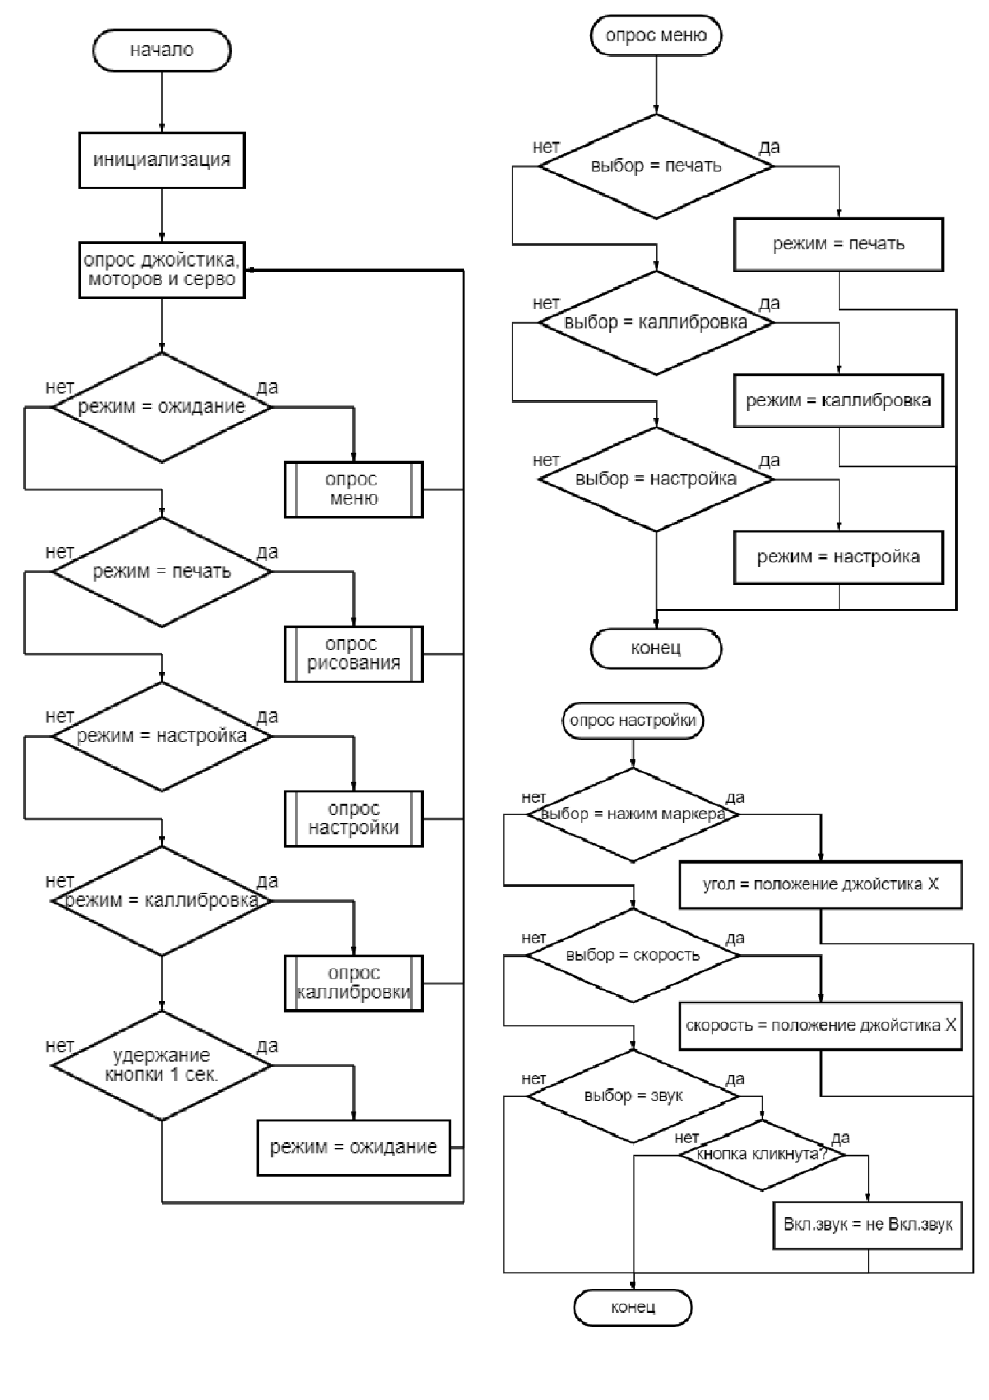
Изображения/А1.png
