JamahaW/VART-Project/Изображения/Аккумуляторная_Сборка_3s.png

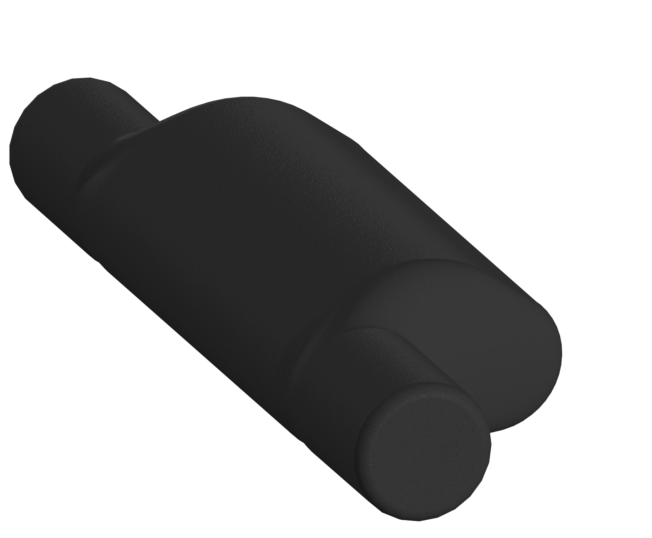
Изображения/Аккумуляторная_Сборка_3s.png
