JamahaW/VART-Project/Изображения/Вертикальный тросовый плоттер MK3.jpg

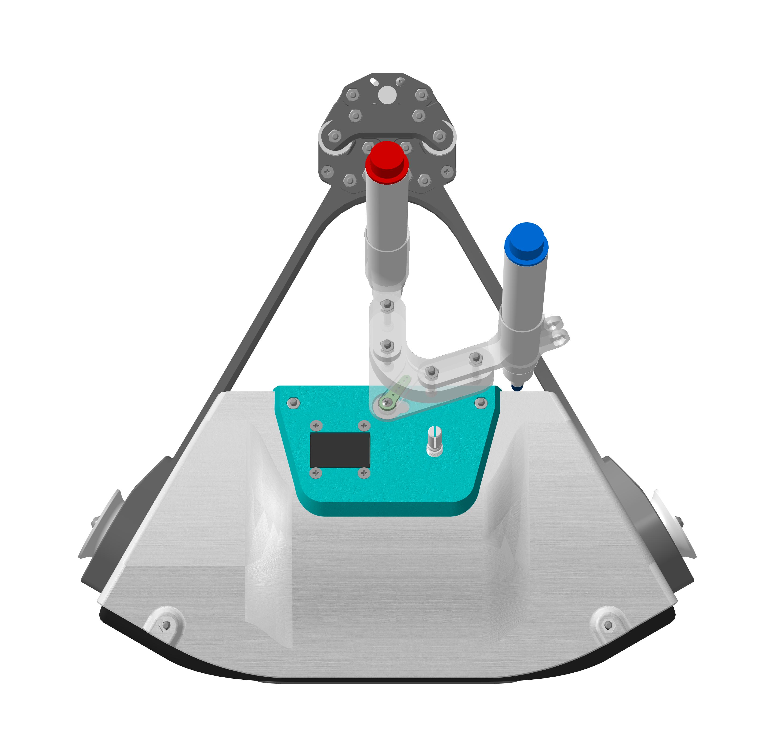
Изображения/Вертикальный тросовый плоттер MK3.jpg
