JamahaW/VART-Project/Изображения/Вертикальный тросовый плоттер MK3.png

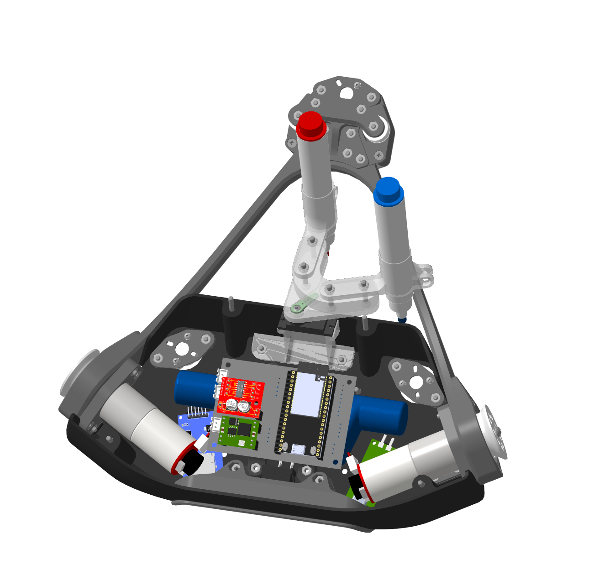
Изображения/Вертикальный тросовый плоттер MK3.png
