JamahaW/VART-Project/Изображения/Вертикальный тросовый плоттер MK3_бок.png

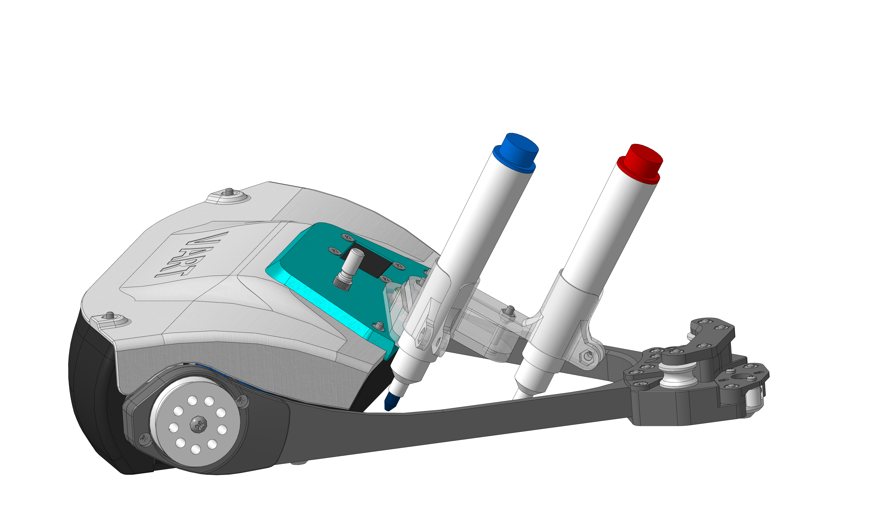
Изображения/Вертикальный тросовый плоттер MK3_бок.png
