JamahaW/VART-Project/Изображения/Вертикальный тросовый плоттер MK3_дно.png

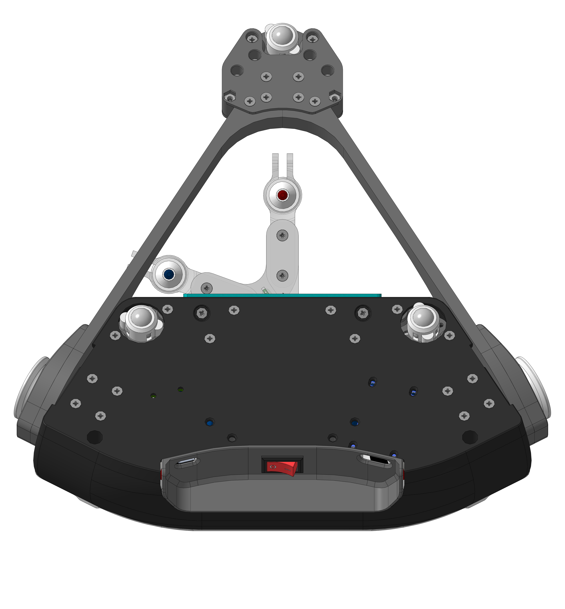
Изображения/Вертикальный тросовый плоттер MK3_дно.png
