JamahaW/VART-Project/Изображения/Вертикальный тросовый плоттер MK3_зад.png

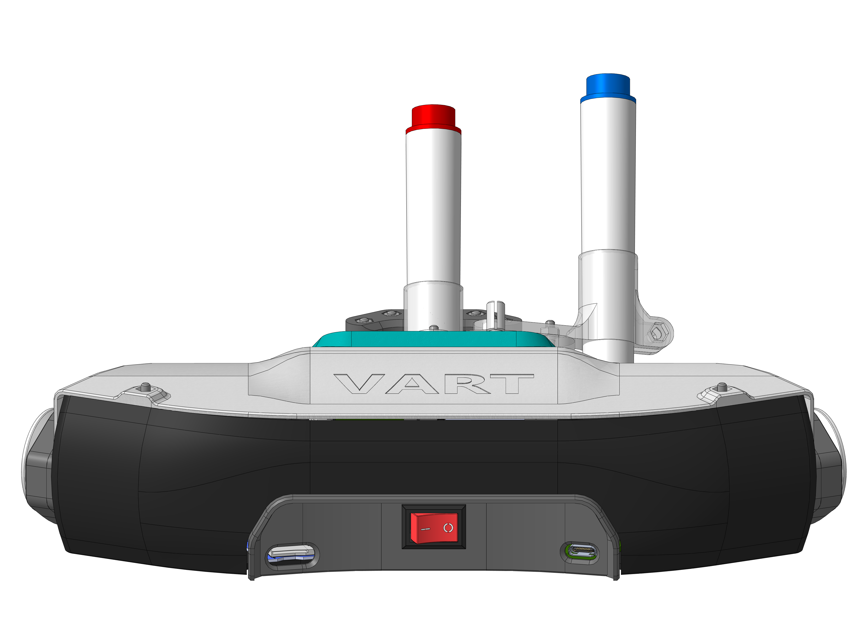
Изображения/Вертикальный тросовый плоттер MK3_зад.png
