JamahaW/VART-Project/Изображения/Вертикальный тросовый плоттер MK3_компоненты.png

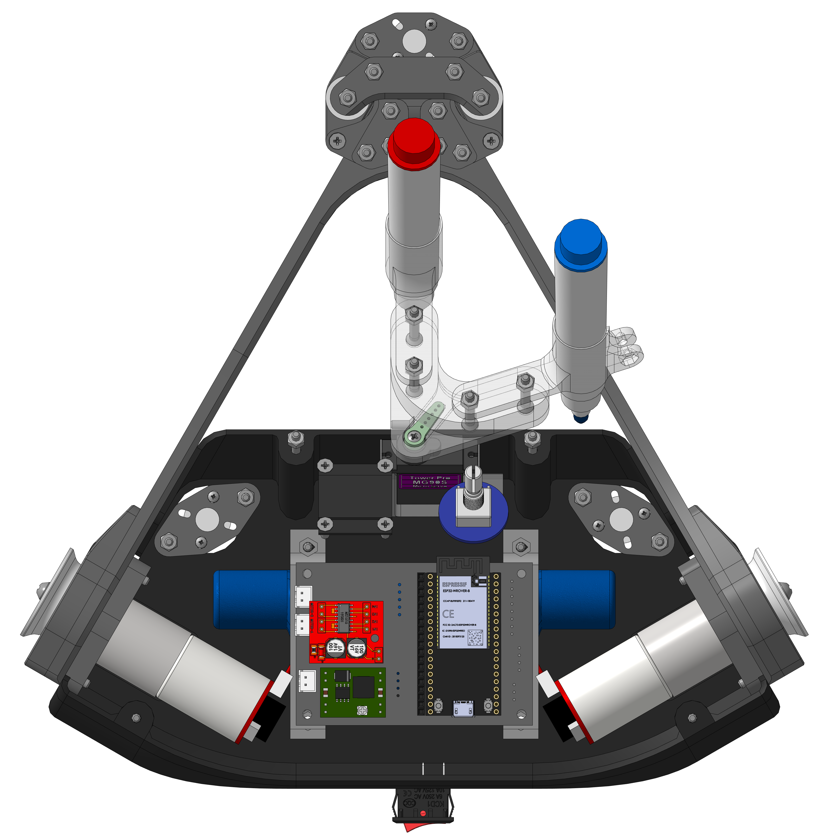
Изображения/Вертикальный тросовый плоттер MK3_компоненты.png
