JamahaW/VART-Project/Изображения/Вертикальный тросовый плоттер MK3_перед.png

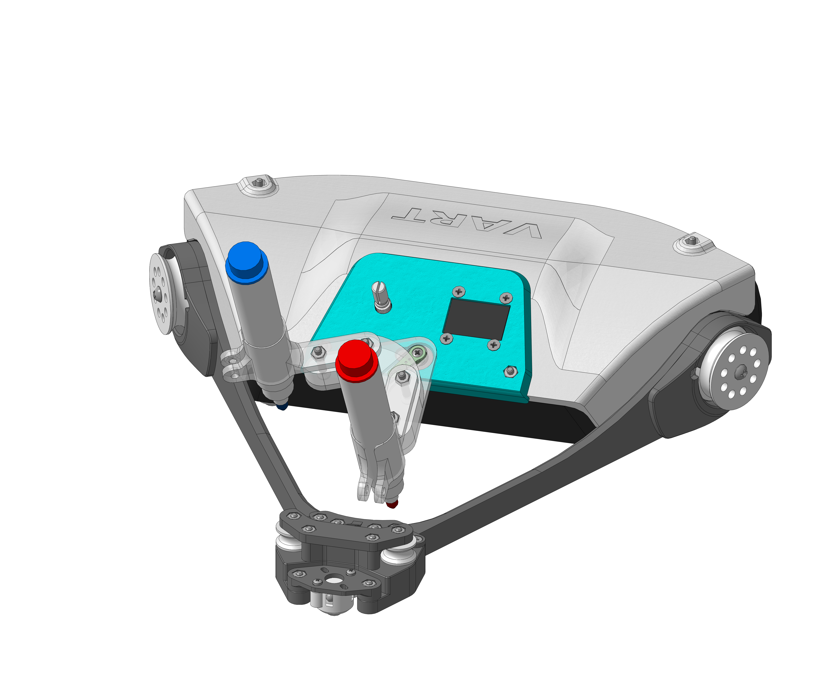
Изображения/Вертикальный тросовый плоттер MK3_перед.png
