JamahaW/VART-Project/Изображения/Вертикальный тросовый плоттер MK3_плата_крышка.png

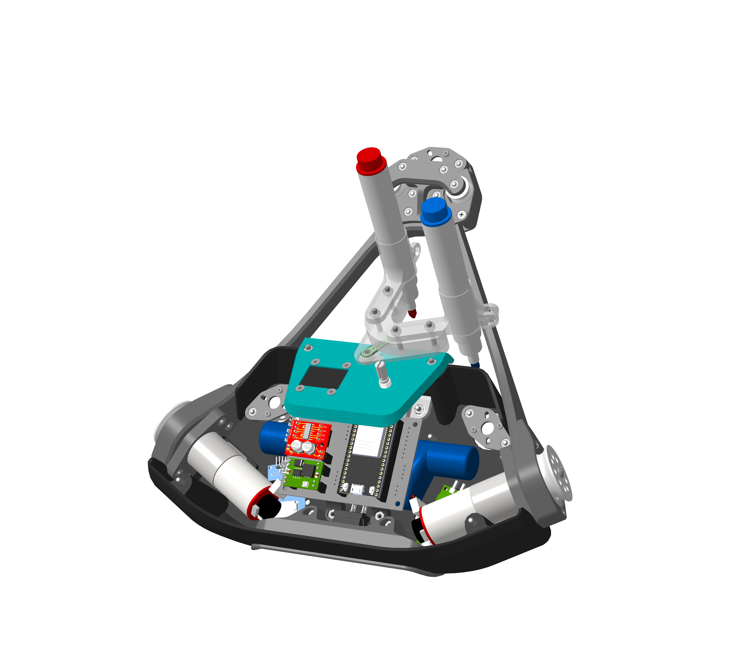
Изображения/Вертикальный тросовый плоттер MK3_плата_крышка.png
