JamahaW/VART-Project/Изображения/Вертикальный тросовый плоттер MK3_срез.png

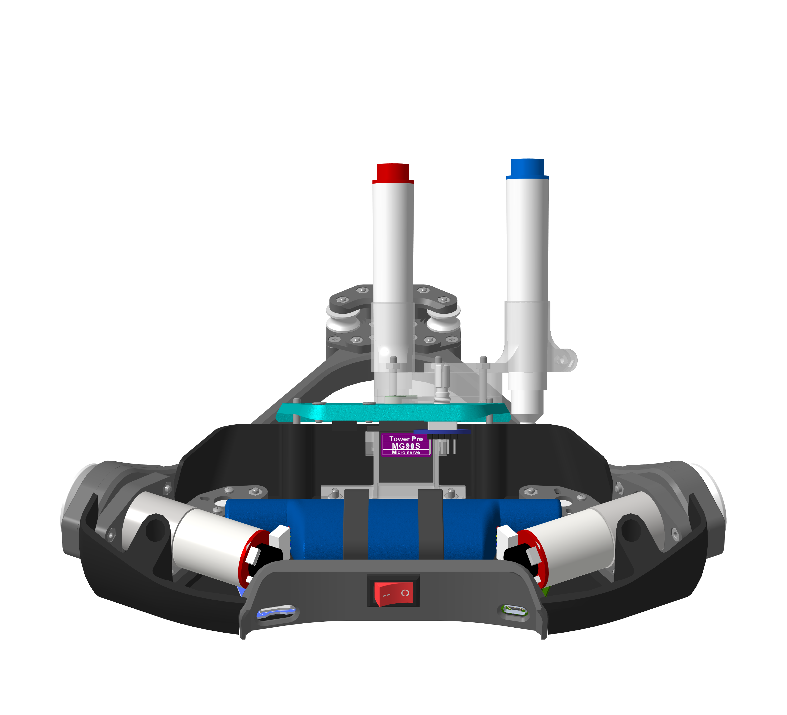
Изображения/Вертикальный тросовый плоттер MK3_срез.png
