JamahaW/VART-Project/Изображения/Вертикальный_маркерный_плоттер_в_сборе_аааа.100000.001сб.png

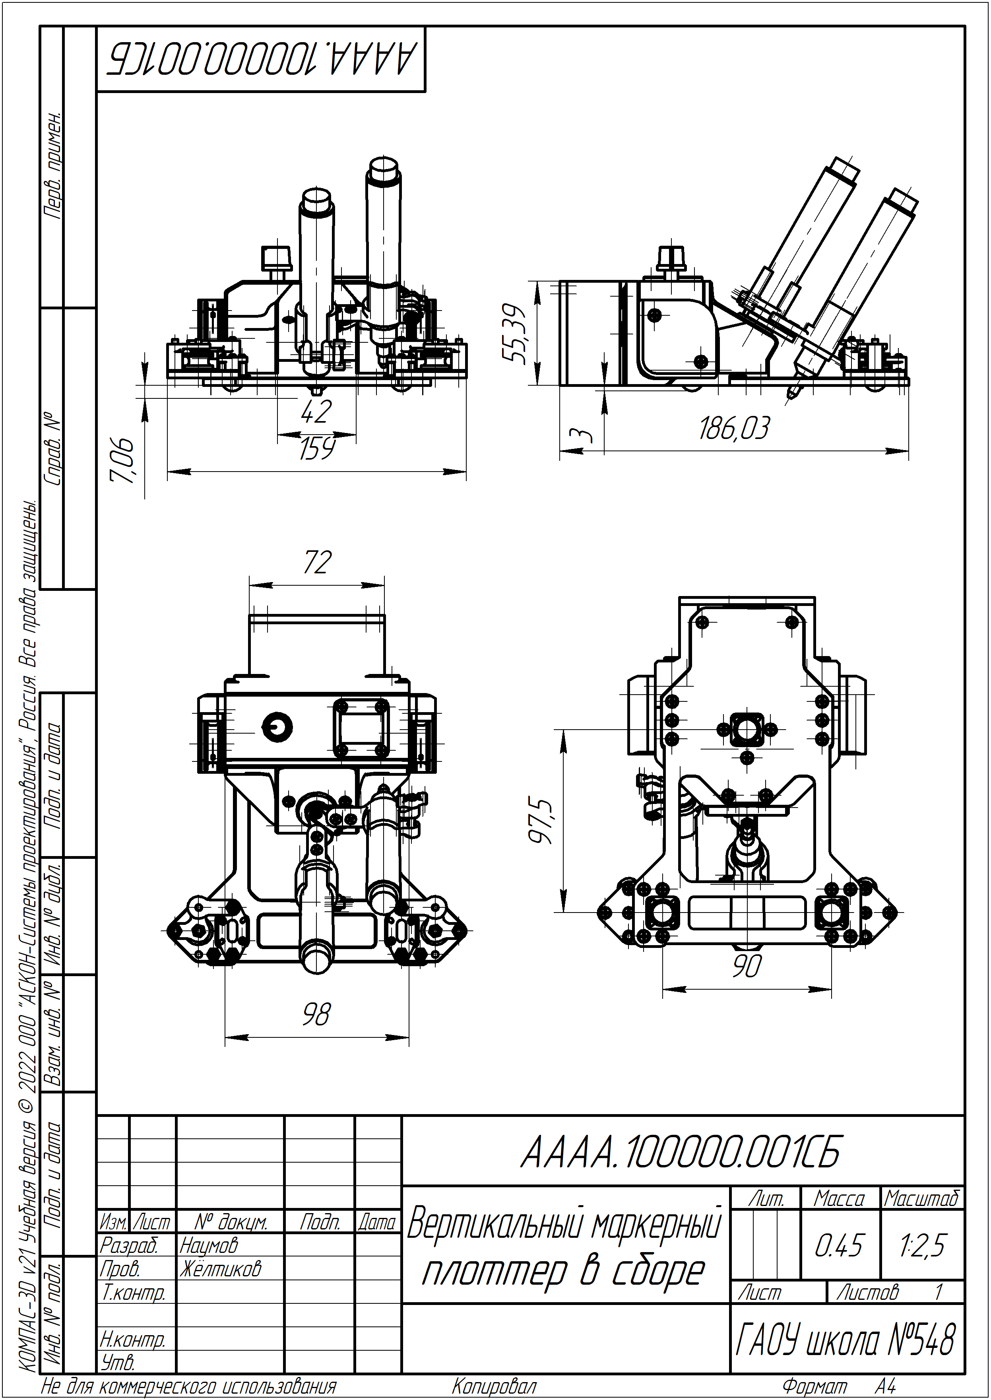
Изображения/Вертикальный_маркерный_плоттер_в_сборе_аааа.100000.001сб.png
