JamahaW/VART-Project/Изображения/Вертикальный_Тросовый_Плоттер_Mk3.png

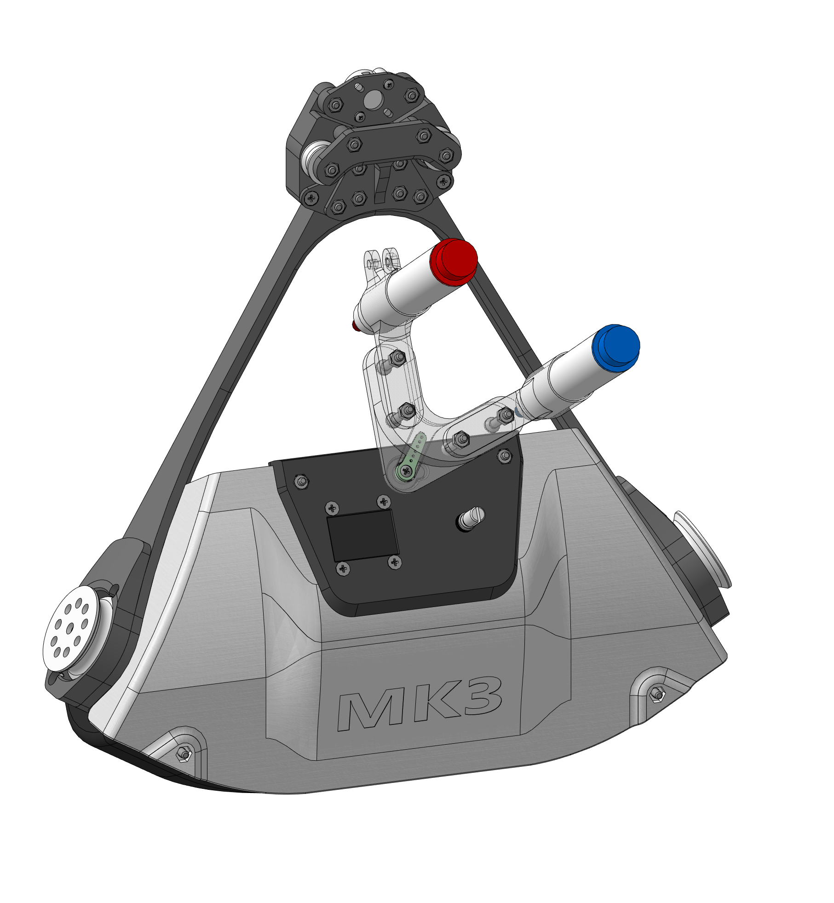
Изображения/Вертикальный_Тросовый_Плоттер_Mk3.png
