JamahaW/VART-Project/Изображения/Вертикальный_Тросовый_Плоттер_Mk3_0.png

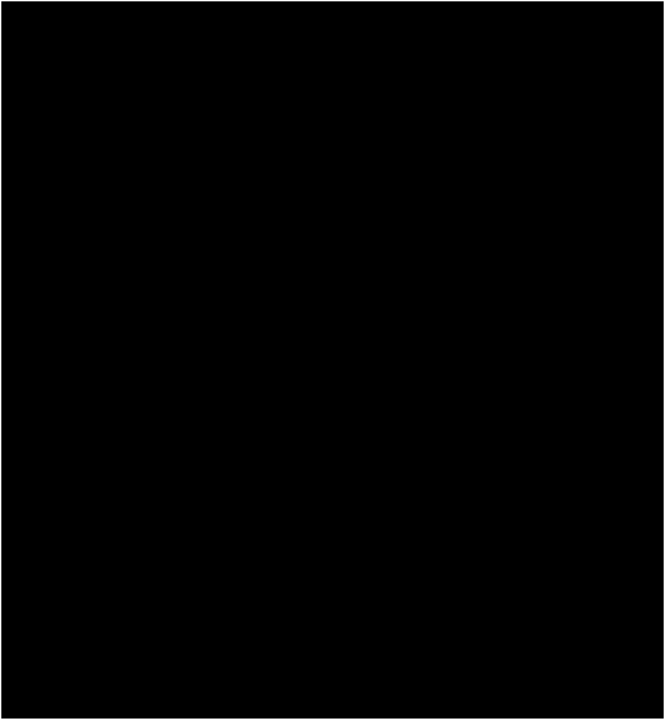
Изображения/Вертикальный_Тросовый_Плоттер_Mk3_0.png
