JamahaW/VART-Project/Изображения/Вертикальный_Тросовый_Плоттер_Mk3_1.png

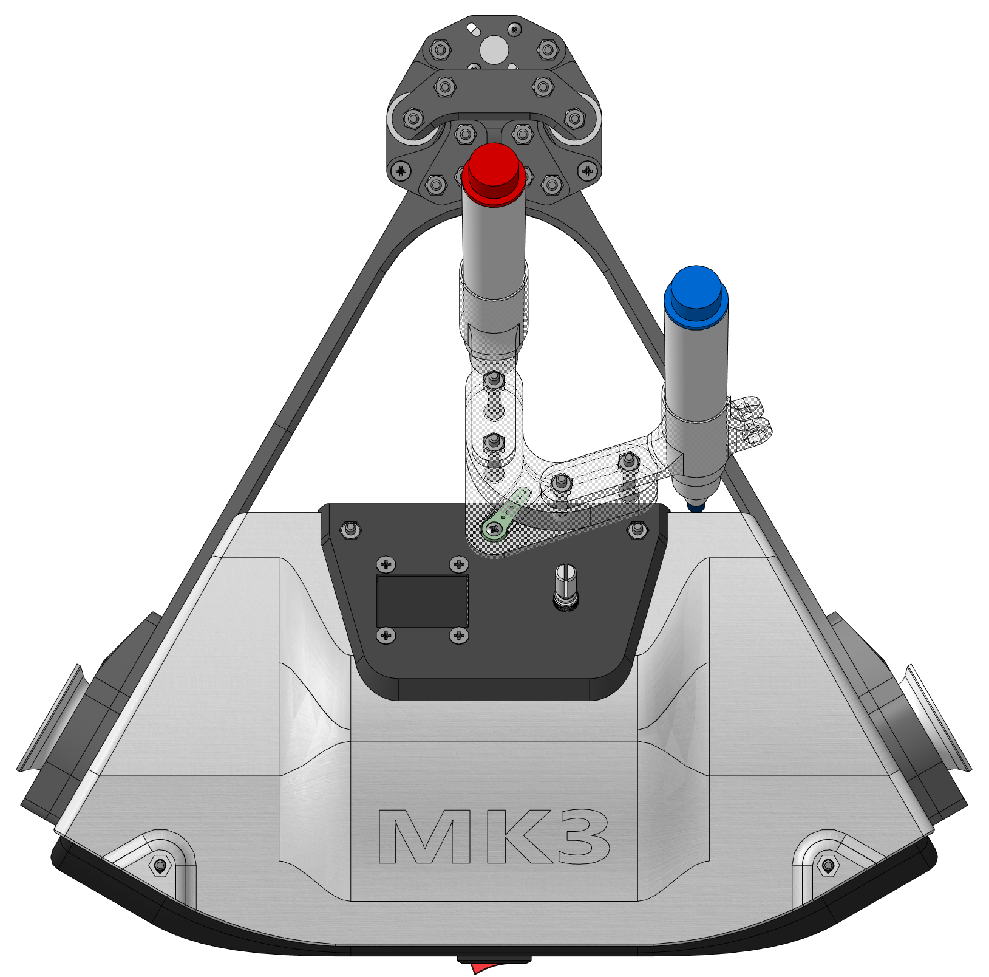
Изображения/Вертикальный_Тросовый_Плоттер_Mk3_1.png
