JamahaW/VART-Project/Изображения/Вертикальный_Тросовый_Плоттер_Mk3____.png

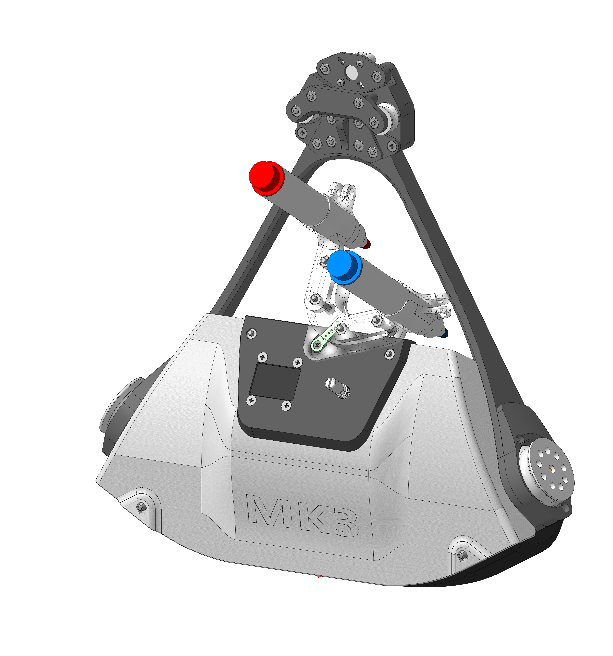
Изображения/Вертикальный_Тросовый_Плоттер_Mk3____.png
