JamahaW/VART-Project/Изображения/Зажим_Маркера_В_Сборе.png

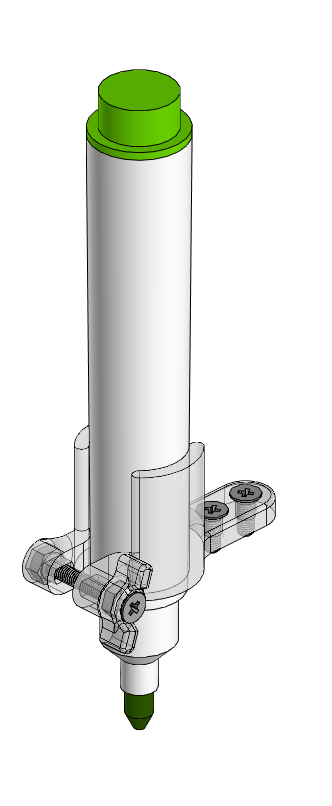
Изображения/Зажим_Маркера_В_Сборе.png
