JamahaW/VART-Project/Изображения/Кинематика.png

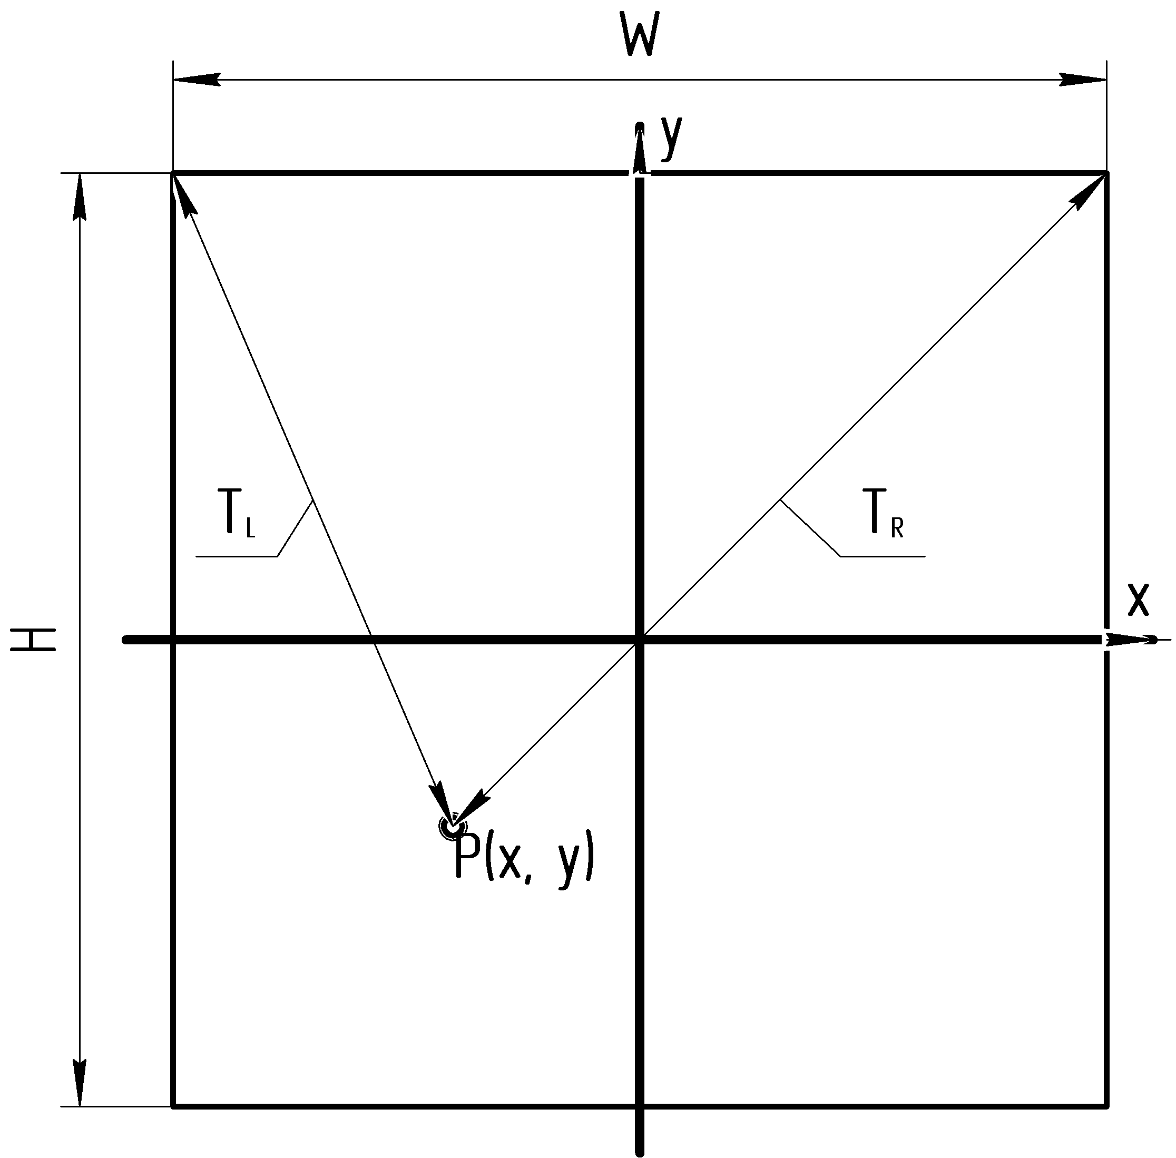
Изображения/Кинематика.png
