JamahaW/VART-Project/Изображения/Маркерный_Плоттер_M0.jpg

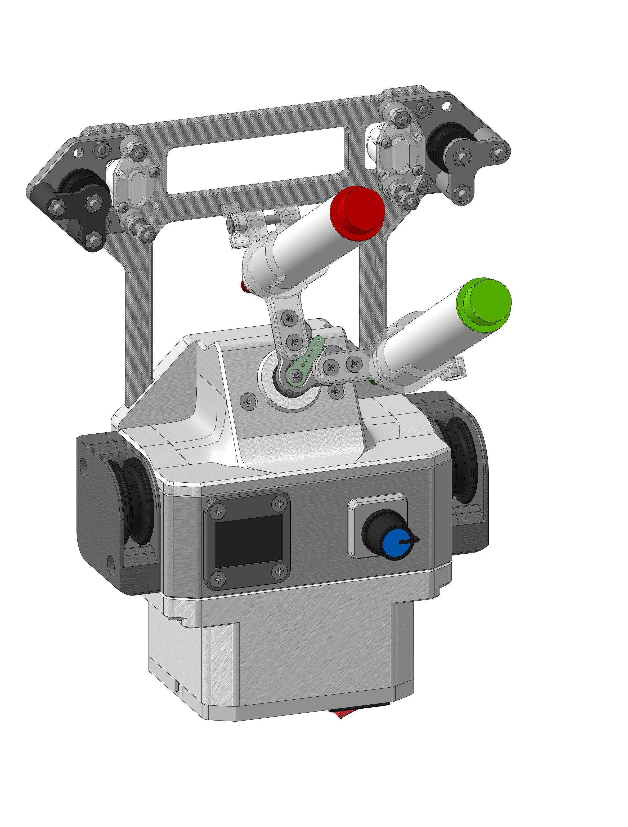
Изображения/Маркерный_Плоттер_M0.jpg
