JamahaW/VART-Project/Изображения/Маркерный_Плоттер_M0.png_сбоку.png

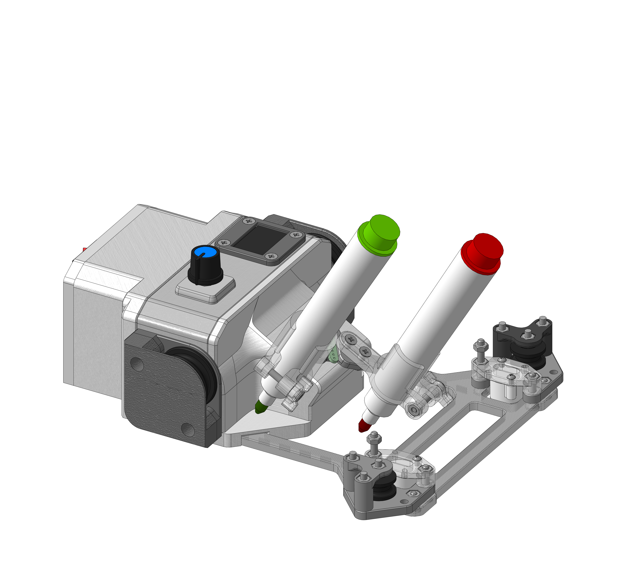
Изображения/Маркерный_Плоттер_M0.png_сбоку.png
