JamahaW/VART-Project/Изображения/Меню_Макета.jpg

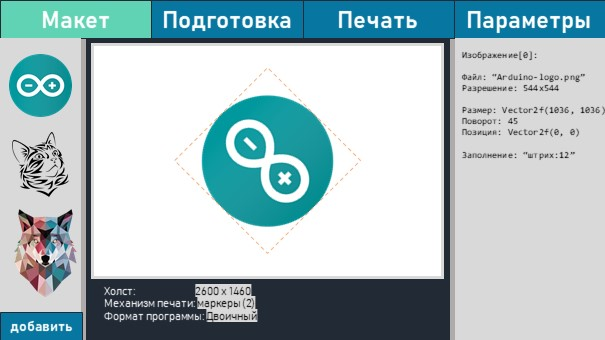
Изображения/Меню_Макета.jpg
