JamahaW/VART-Project/Изображения/Механизм печати маркерны22.png

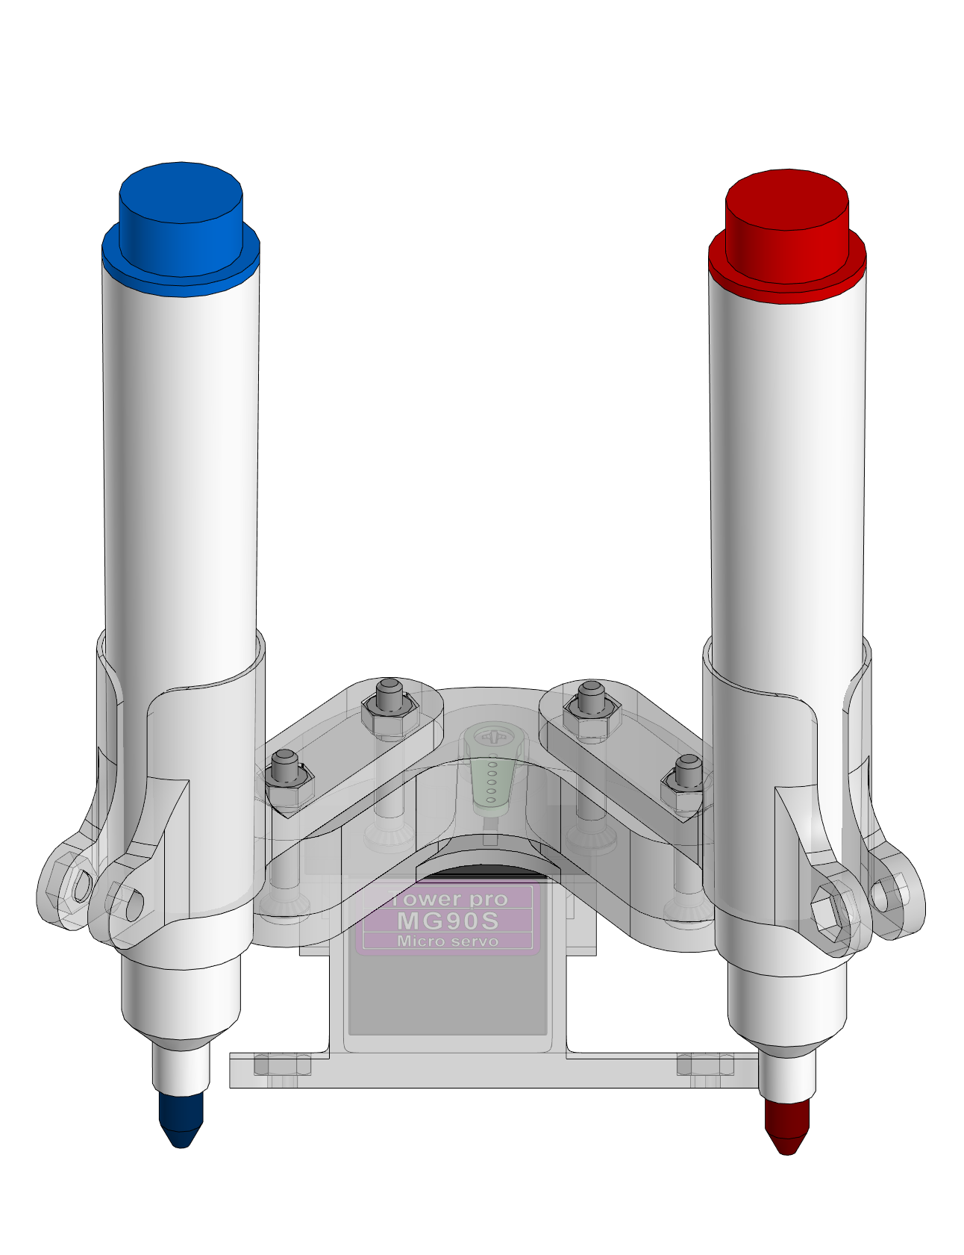
Изображения/Механизм печати маркерны22.png
