JamahaW/VART-Project/Изображения/Механизм печати маркерный3.png

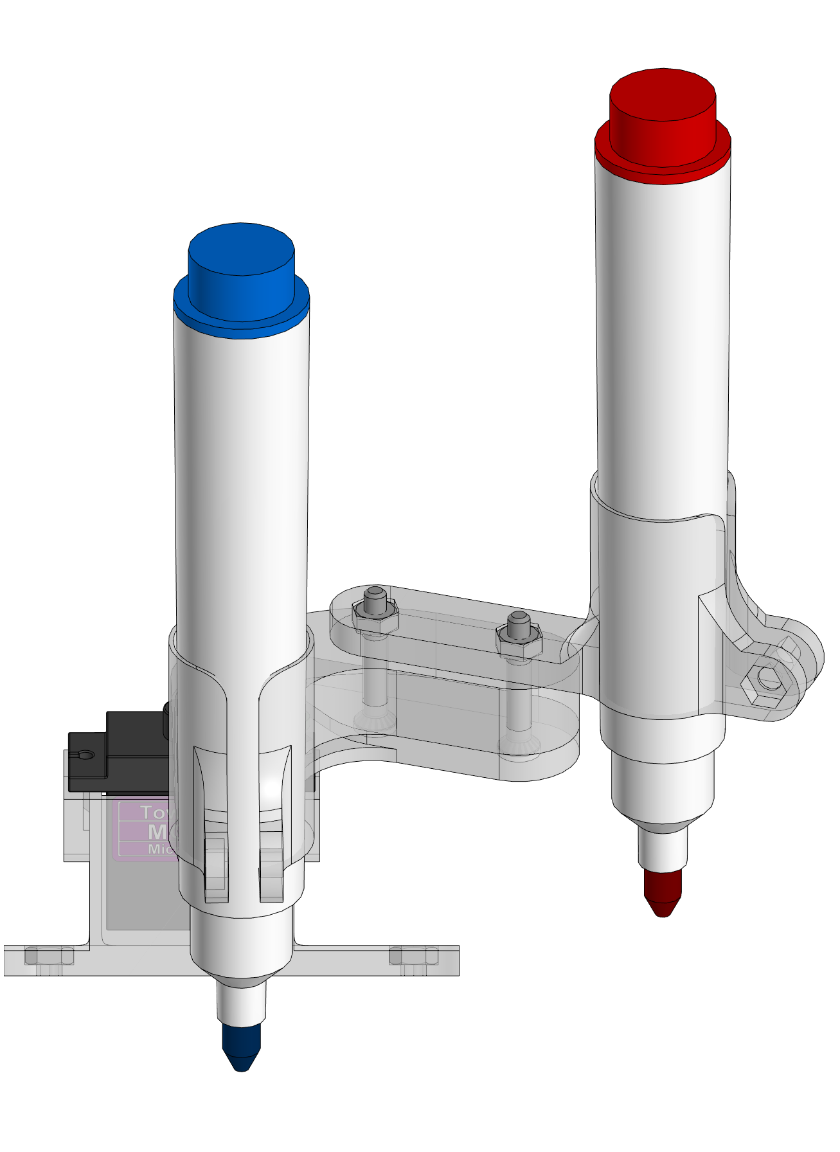
Изображения/Механизм печати маркерный3.png
