JamahaW/VART-Project/Изображения/Механизм печати маркерный4.png

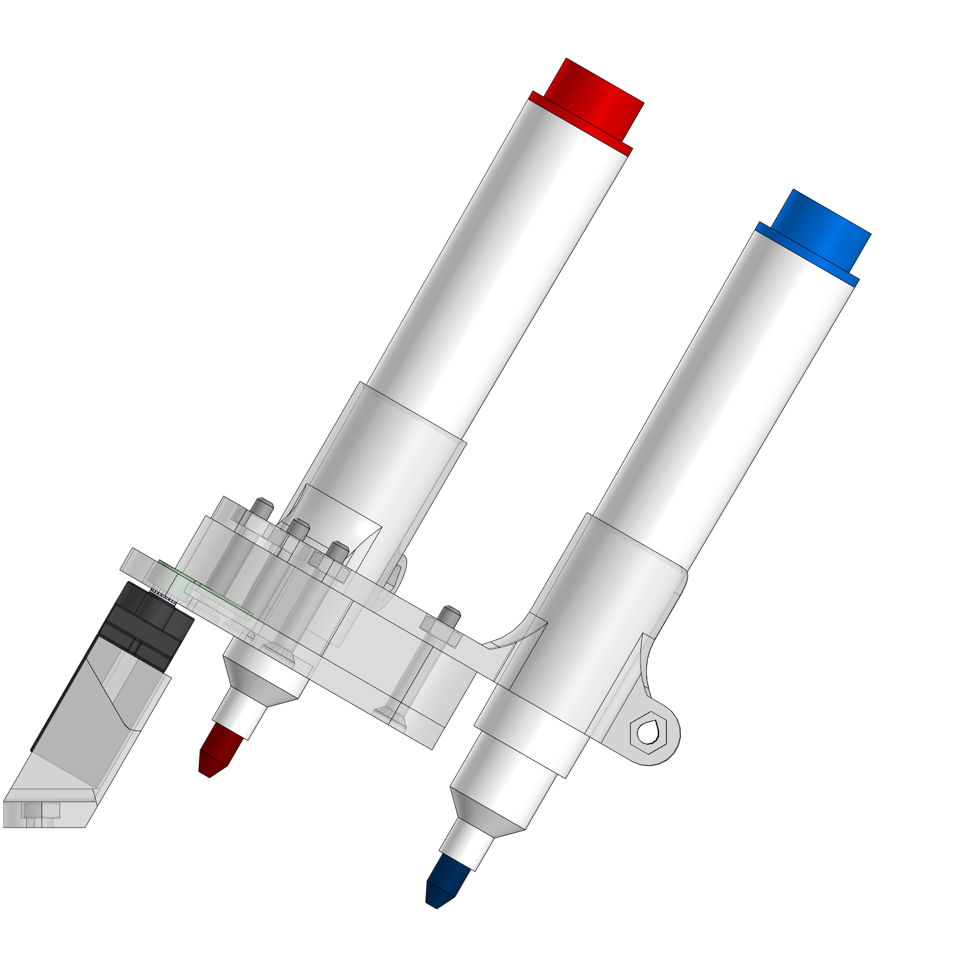
Изображения/Механизм печати маркерный4.png
