JamahaW/VART-Project/Изображения/Механизм печати маркерный.png

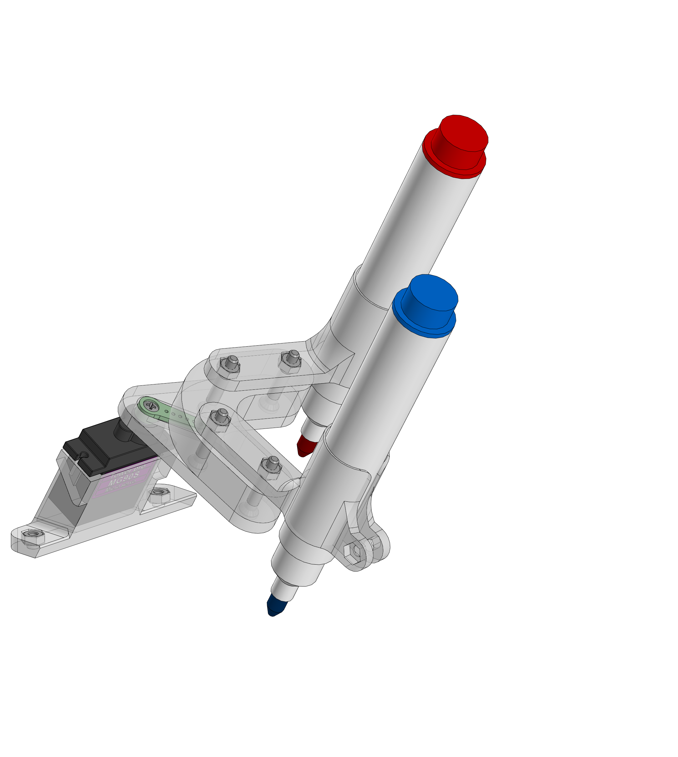
Изображения/Механизм печати маркерный.png
