JamahaW/VART-Project/Изображения/Механизм печати маркерный_1.png

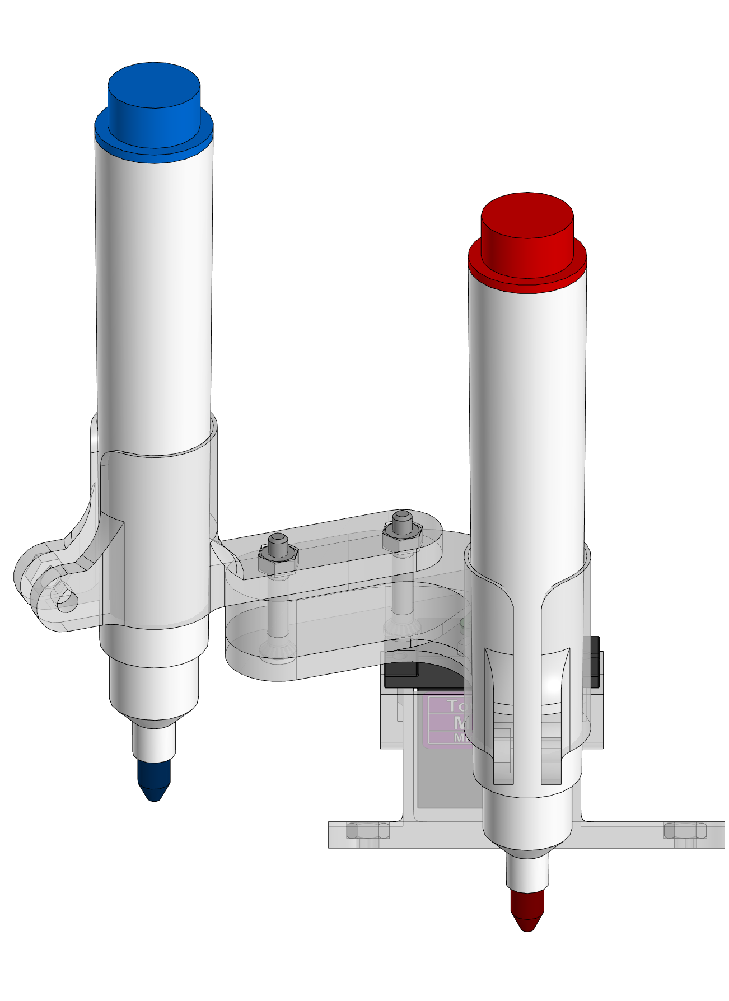
Изображения/Механизм печати маркерный_1.png
