JamahaW/VART-Project/Изображения/Механизм_Печати+80.png

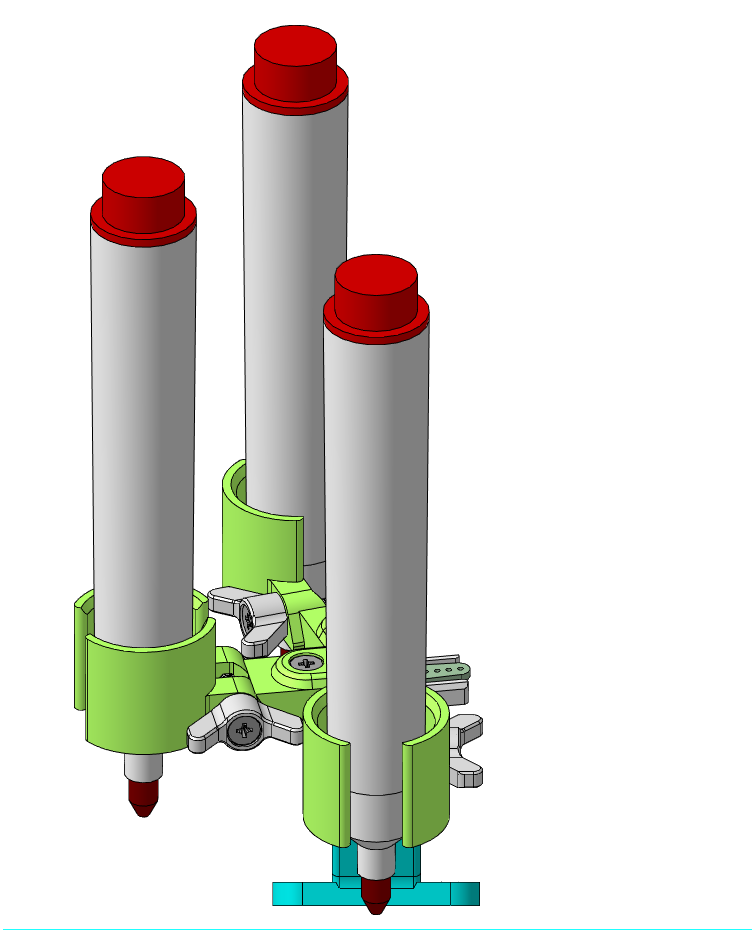
Изображения/Механизм_Печати+80.png
