JamahaW/VART-Project/Изображения/Механизм_Печати-40.png

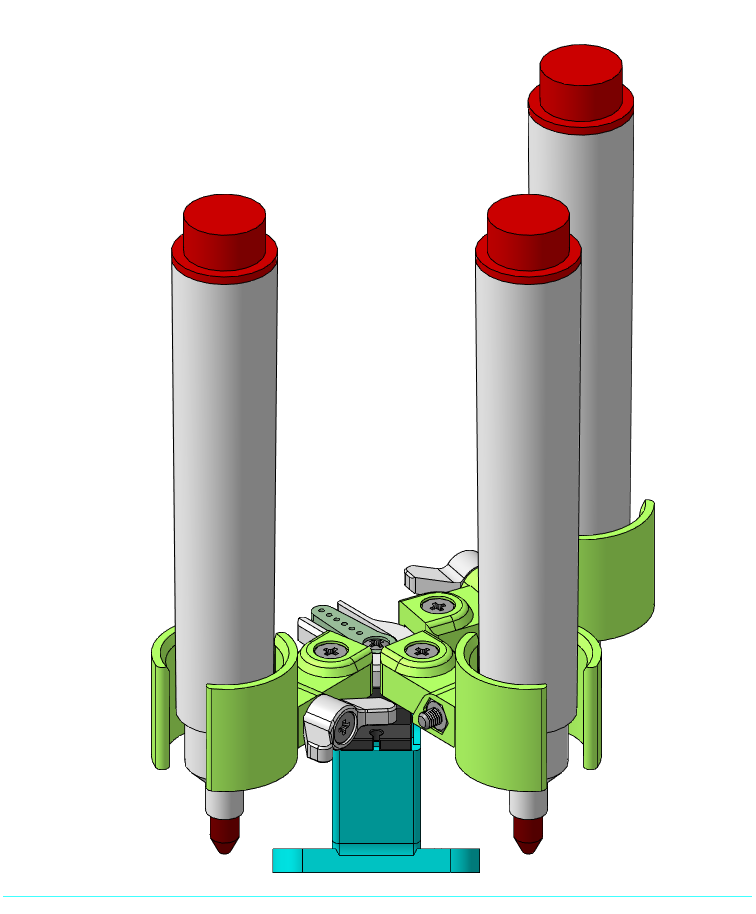
Изображения/Механизм_Печати-40.png
