JamahaW/VART-Project/Изображения/Механизм_Печати_0.png

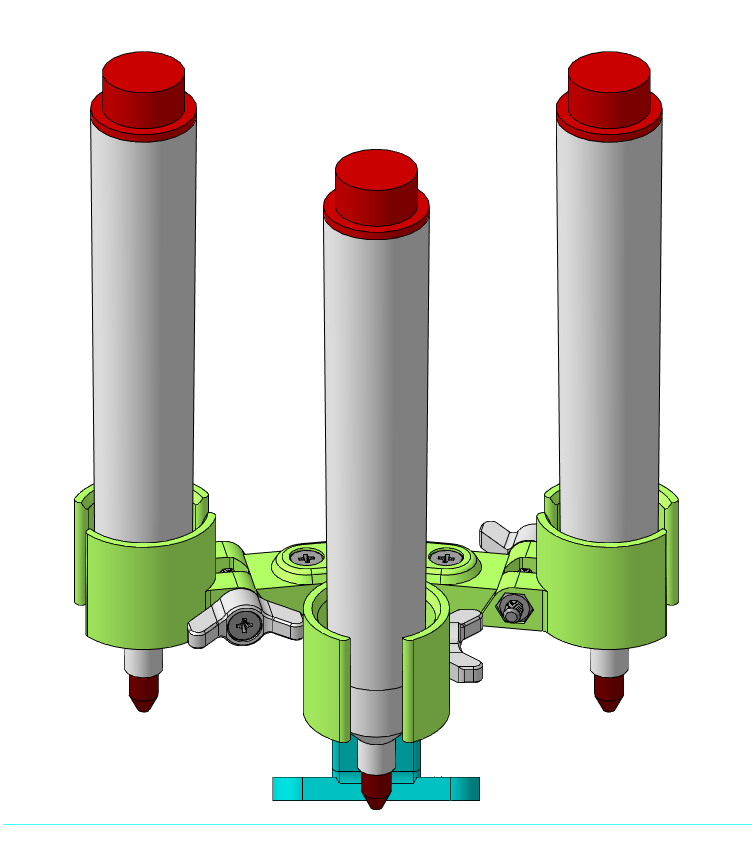
Изображения/Механизм_Печати_0.png
