JamahaW/VART-Project/Изображения/Механизм_Смены_Маркеров.png

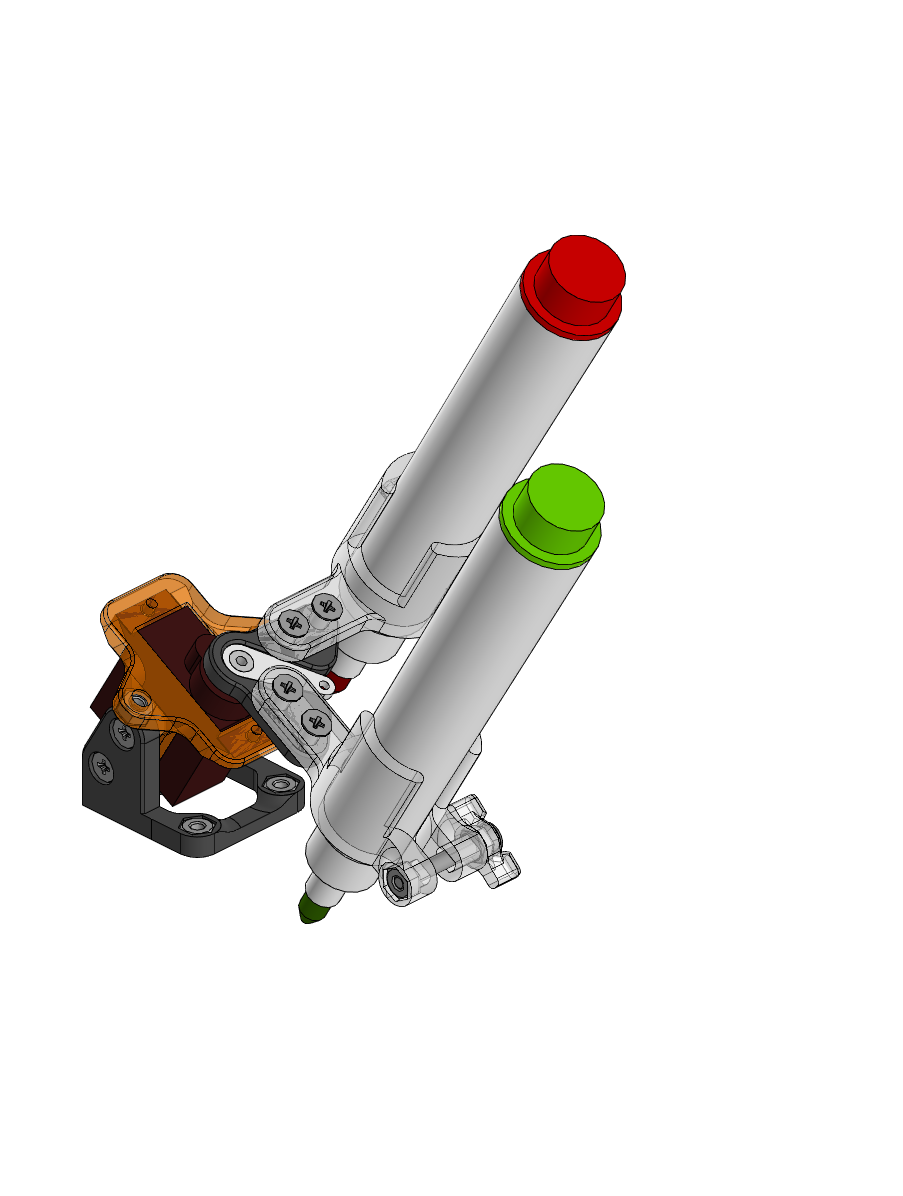
Изображения/Механизм_Смены_Маркеров.png
