JamahaW/VART-Project/Изображения/Механизм_Смены_Цвета.png

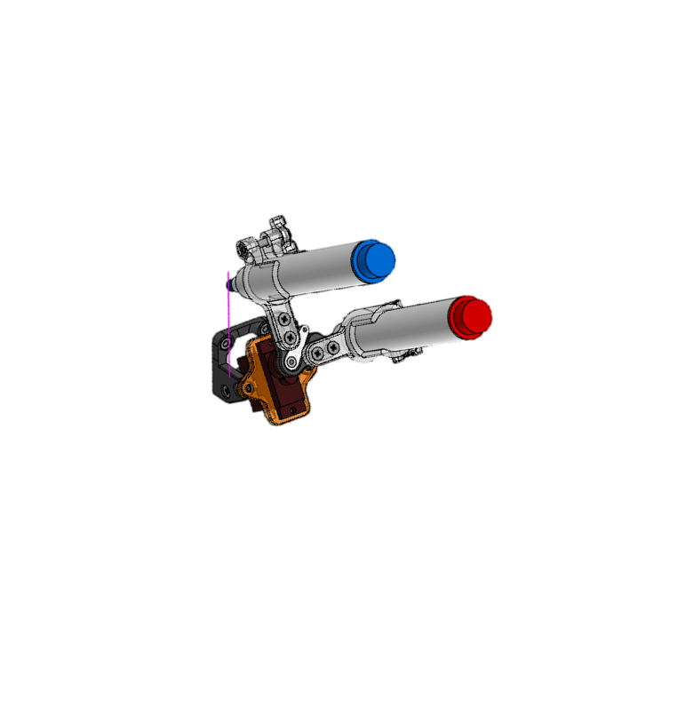
Изображения/Механизм_Смены_Цвета.png
