JamahaW/VART-Project/Изображения/Мк2_рендер.png

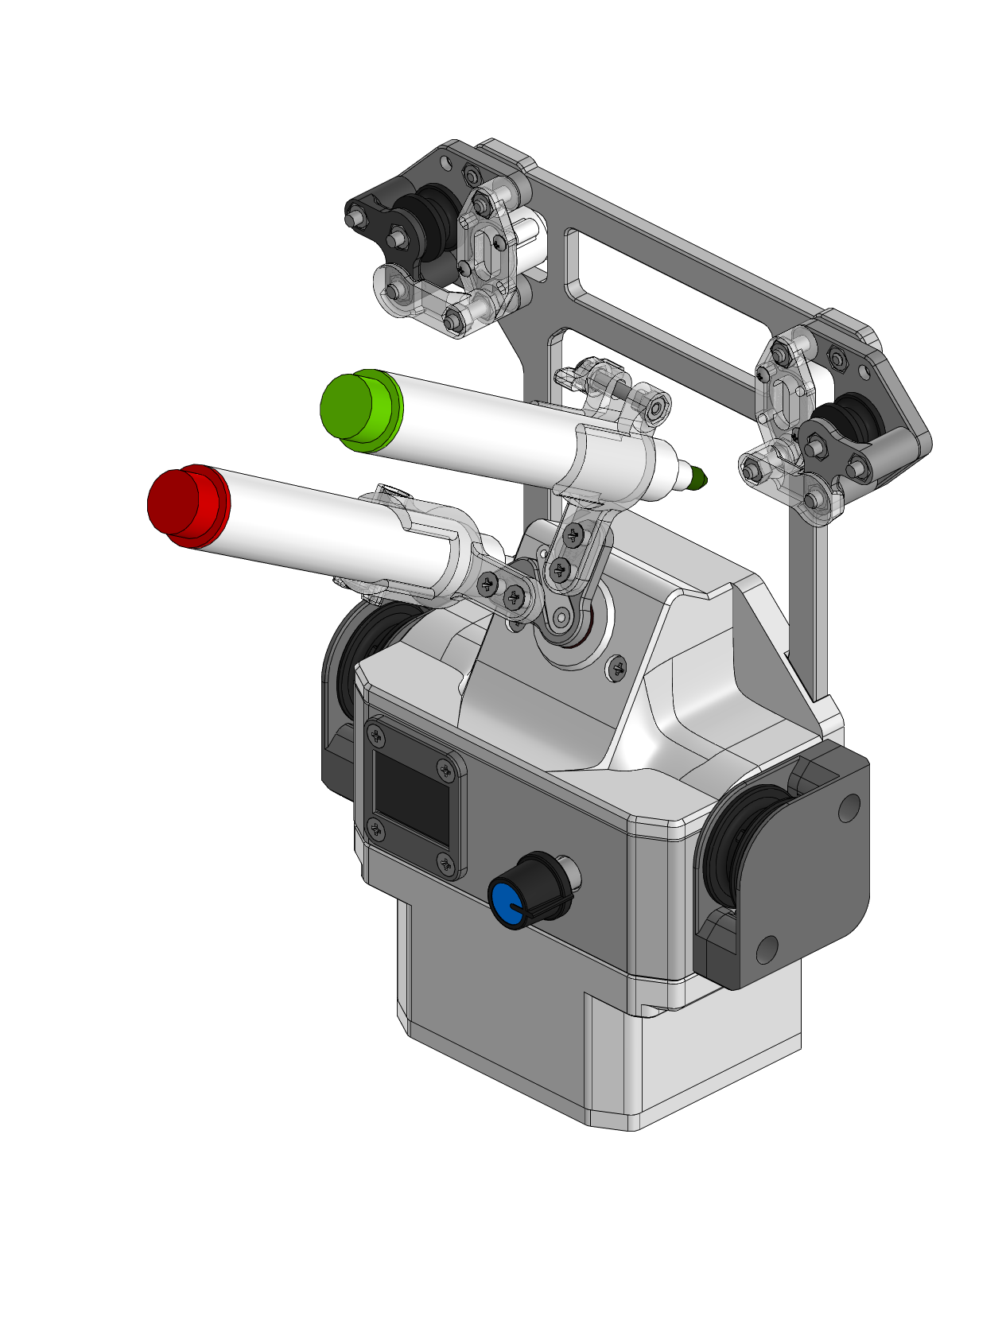
Изображения/Мк2_рендер.png
