JamahaW/VART-Project/Изображения/Мк2_рендер_1.png

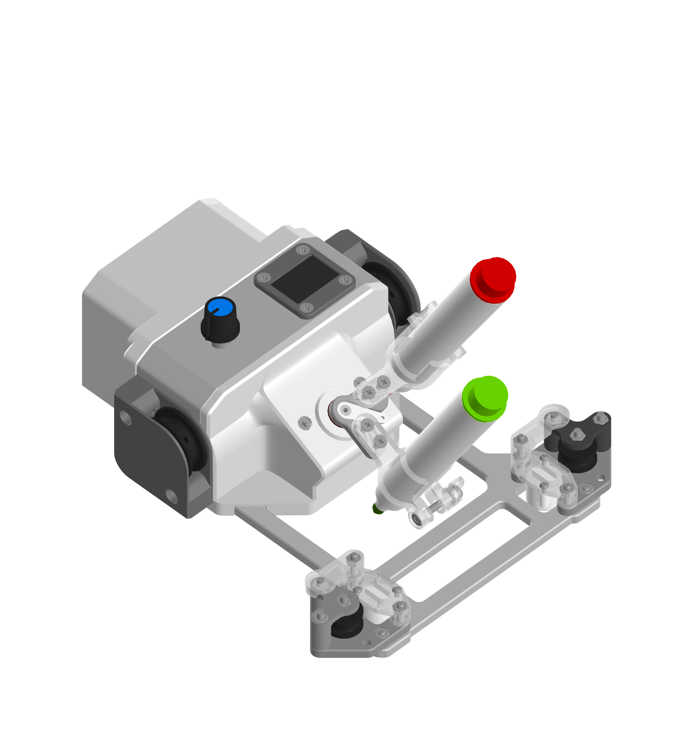
Изображения/Мк2_рендер_1.png
