JamahaW/VART-Project/Изображения/Мк2_Рендер_Контур.png

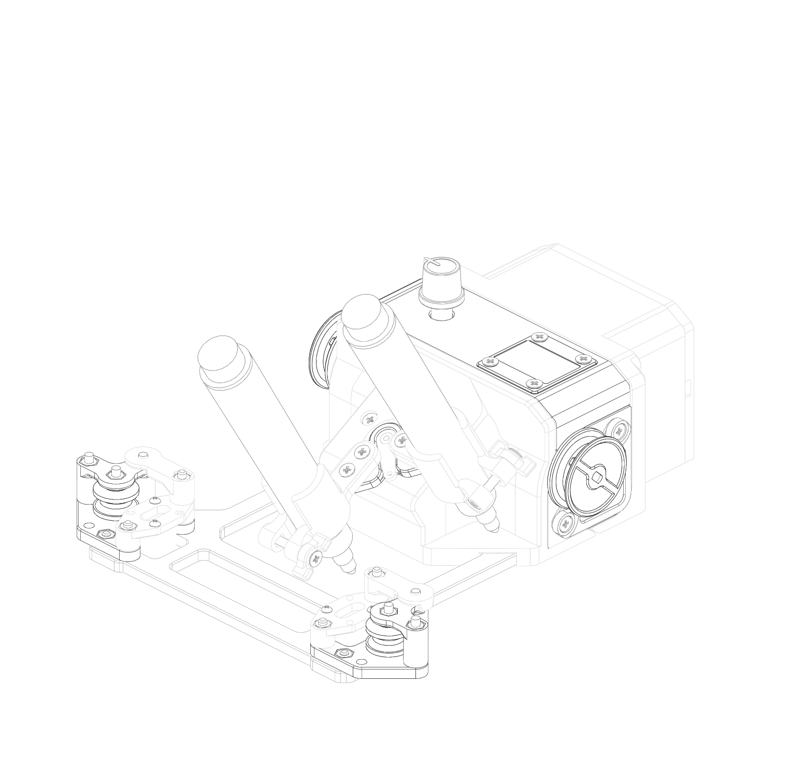
Изображения/Мк2_Рендер_Контур.png
