JamahaW/VART-Project/Изображения/П_наумов_максим_вертикальный_тросовый_плоттер.jpg

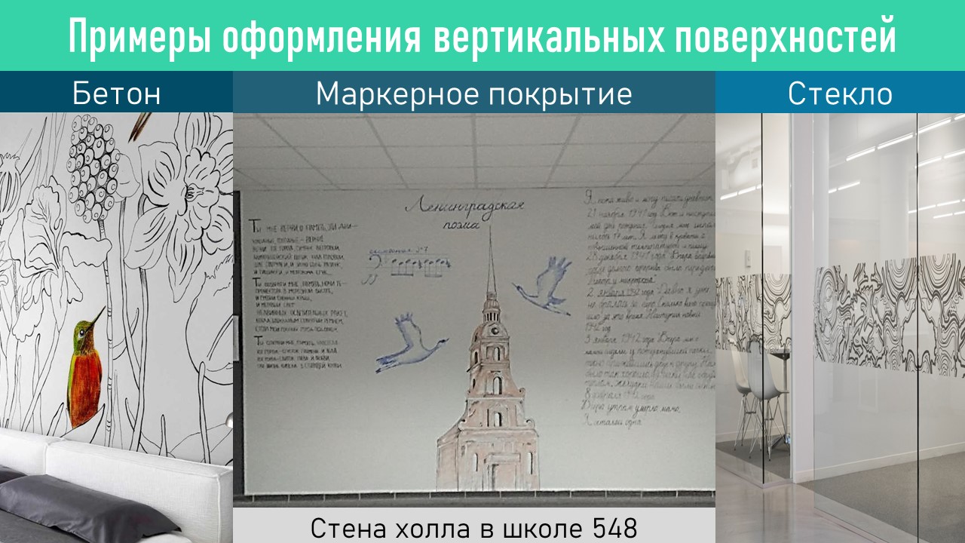
Изображения/П_наумов_максим_вертикальный_тросовый_плоттер.jpg
