JamahaW/VART-Project/Изображения/ПеремещениеПлоттера.png

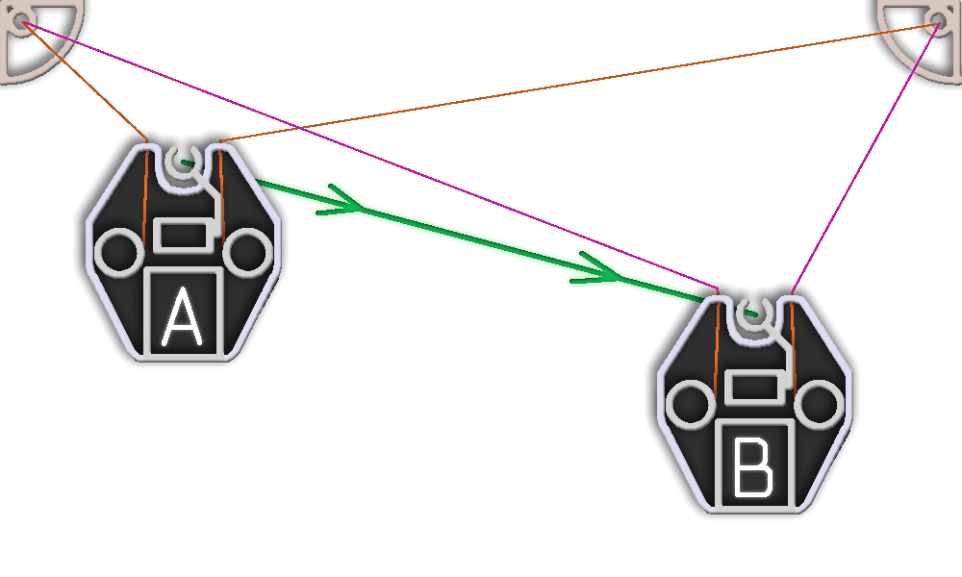
Изображения/ПеремещениеПлоттера.png
