JamahaW/VART-Project/Изображения/Плоттер на доске.png

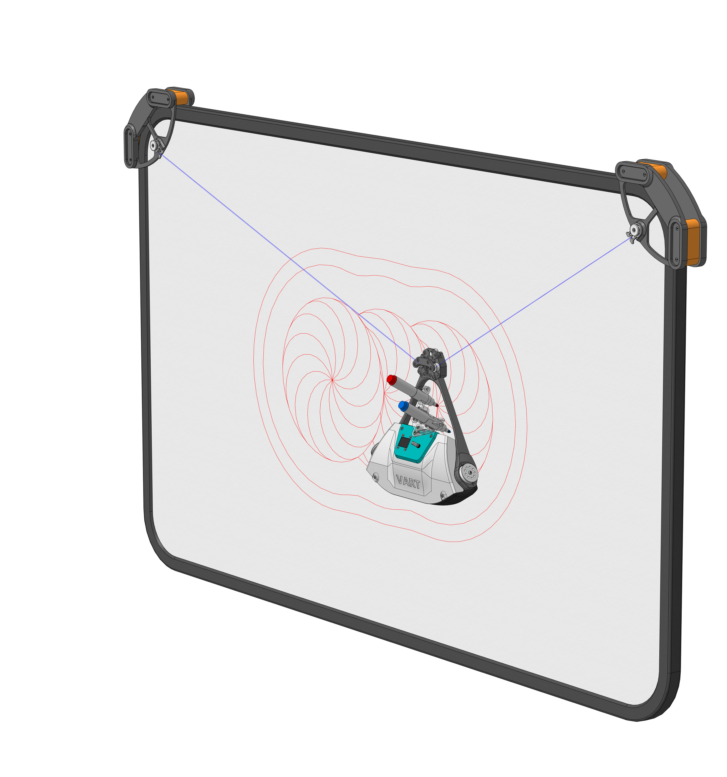
Изображения/Плоттер на доске.png
