JamahaW/VART-Project/Изображения/Плоттер на доске_плоттер.png

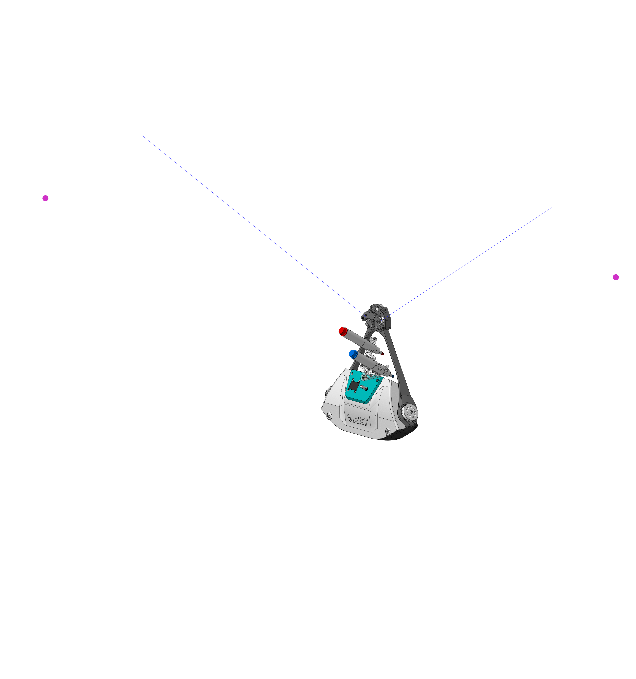
Изображения/Плоттер на доске_плоттер.png
