JamahaW/VART-Project/Изображения/Плоттер_мк2_фото.jpg

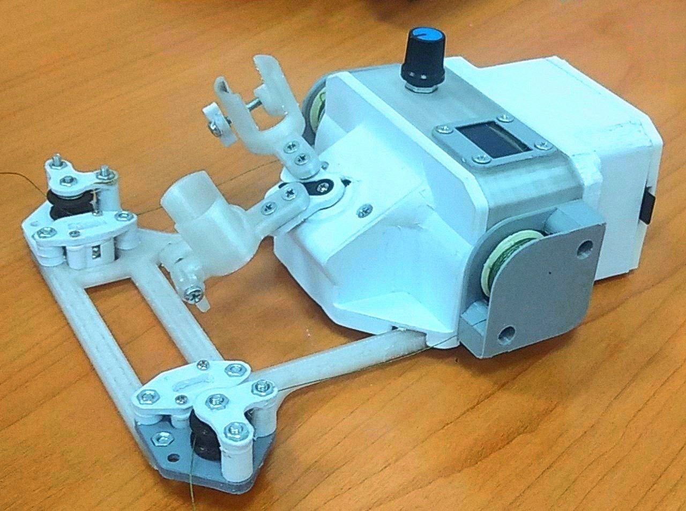
Изображения/Плоттер_мк2_фото.jpg
