JamahaW/VART-Project/Изображения/Плоттер_мк3_рендер_2.png

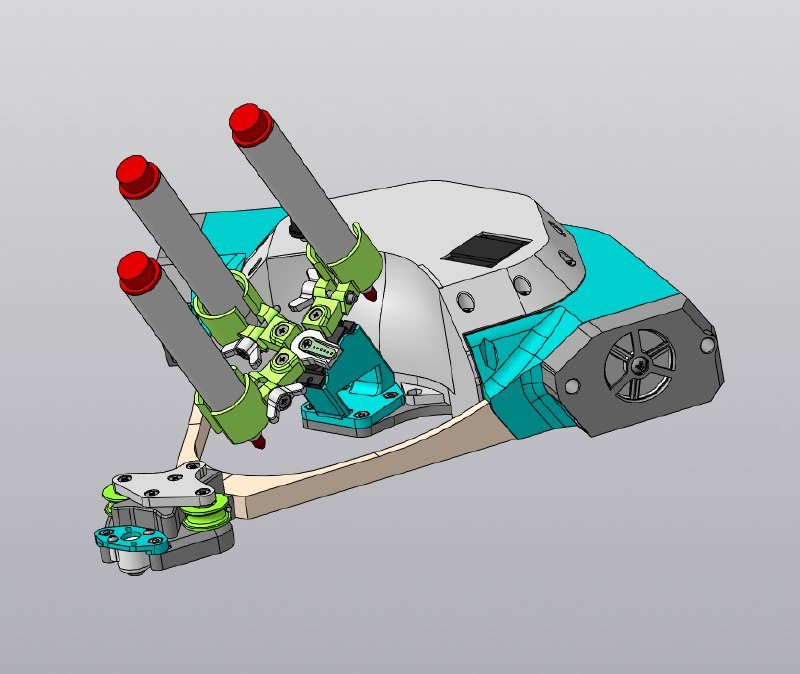
Изображения/Плоттер_мк3_рендер_2.png
