JamahaW/VART-Project/Изображения/Плоттер_мк3_сборка_рендер.jpg

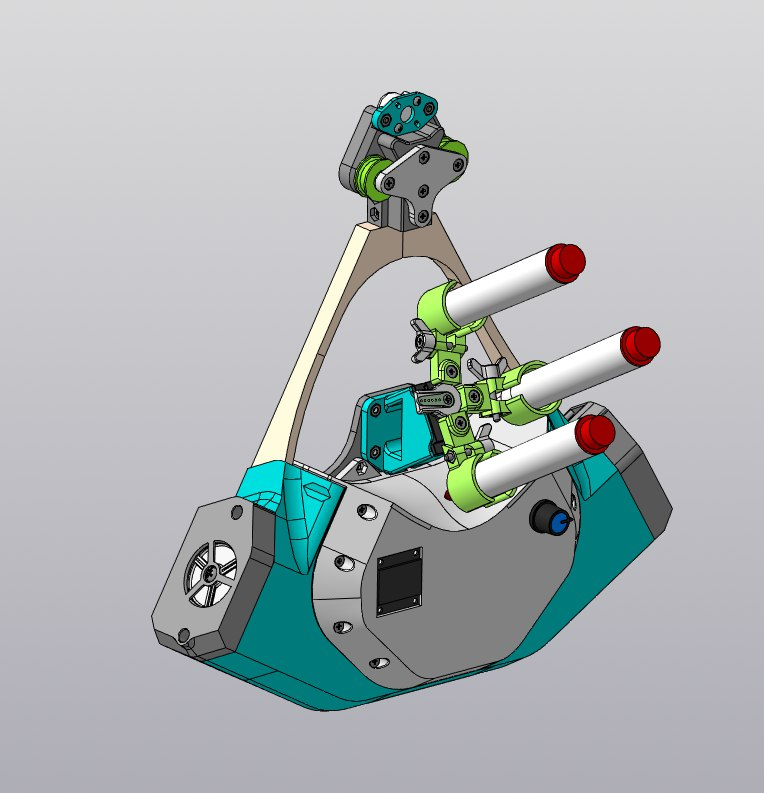
Изображения/Плоттер_мк3_сборка_рендер.jpg
