JamahaW/VART-Project/Изображения/ПлоттерMk3.png

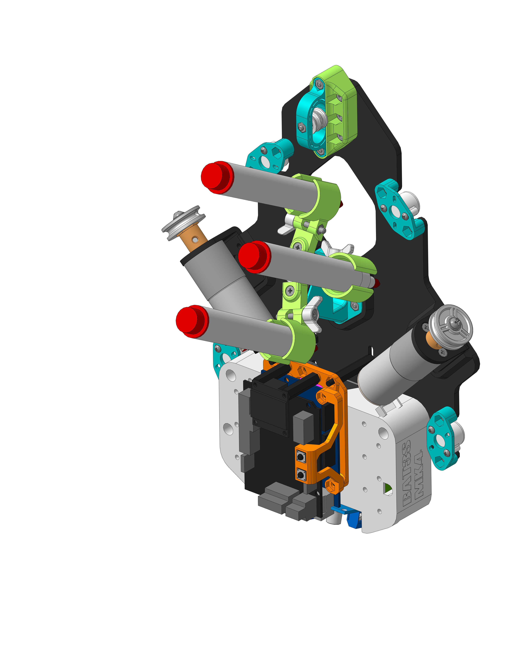
Изображения/ПлоттерMk3.png
