JamahaW/VART-Project/Изображения/ПлоттерЛогика.png

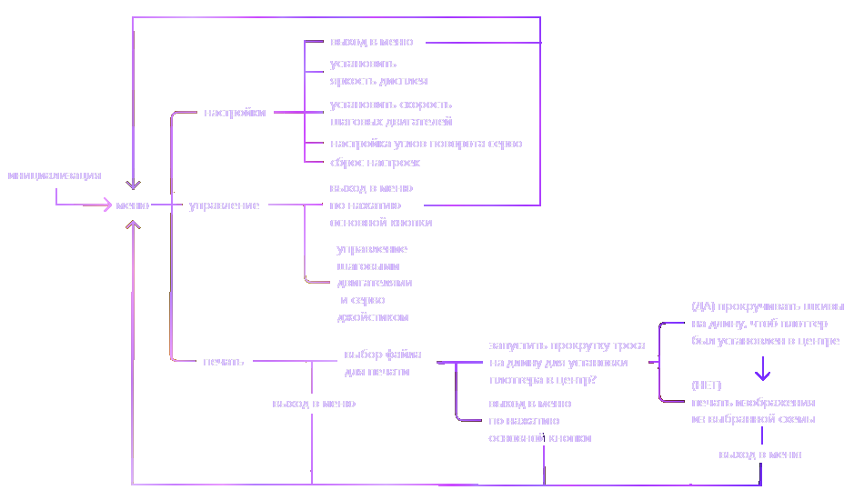
Изображения/ПлоттерЛогика.png
