JamahaW/VART-Project/Изображения/ПолностьюРучнойТруд.jpg

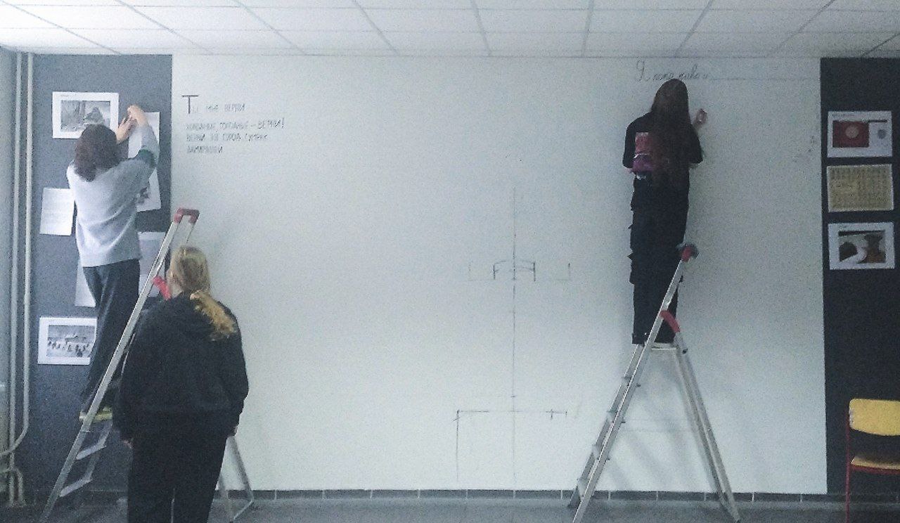
Изображения/ПолностьюРучнойТруд.jpg
