JamahaW/VART-Project/Изображения/ПриводНамотки.png

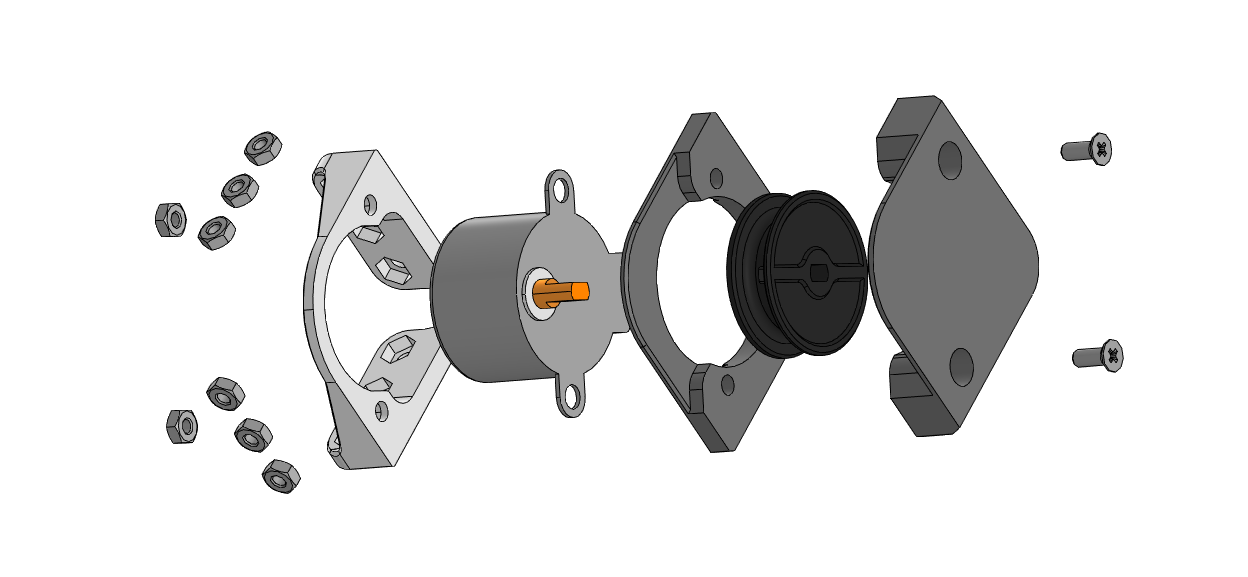
Изображения/ПриводНамотки.png
