JamahaW/VART-Project/Изображения/ПриводНамотки_сбор.png

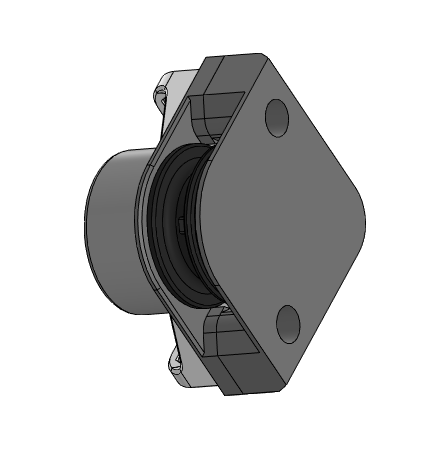
Изображения/ПриводНамотки_сбор.png
