JamahaW/VART-Project/Изображения/Прототип1202Спереди.jpg

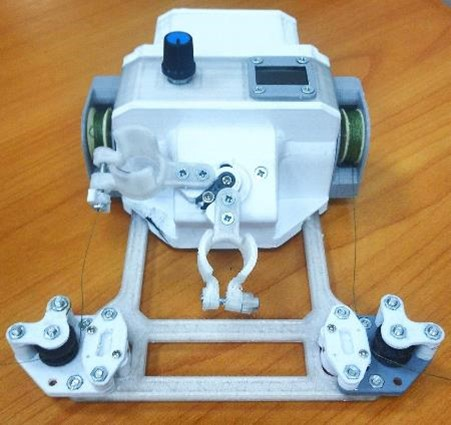
Изображения/Прототип1202Спереди.jpg
