JamahaW/VART-Project/Изображения/Прототип1310.png

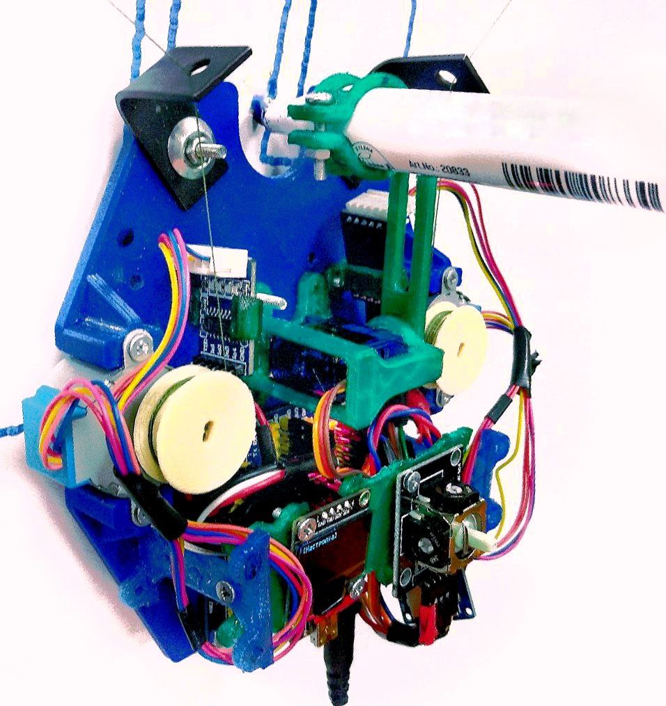
Изображения/Прототип1310.png
