JamahaW/VART-Project/Изображения/Прототип1310Сверху.jpg

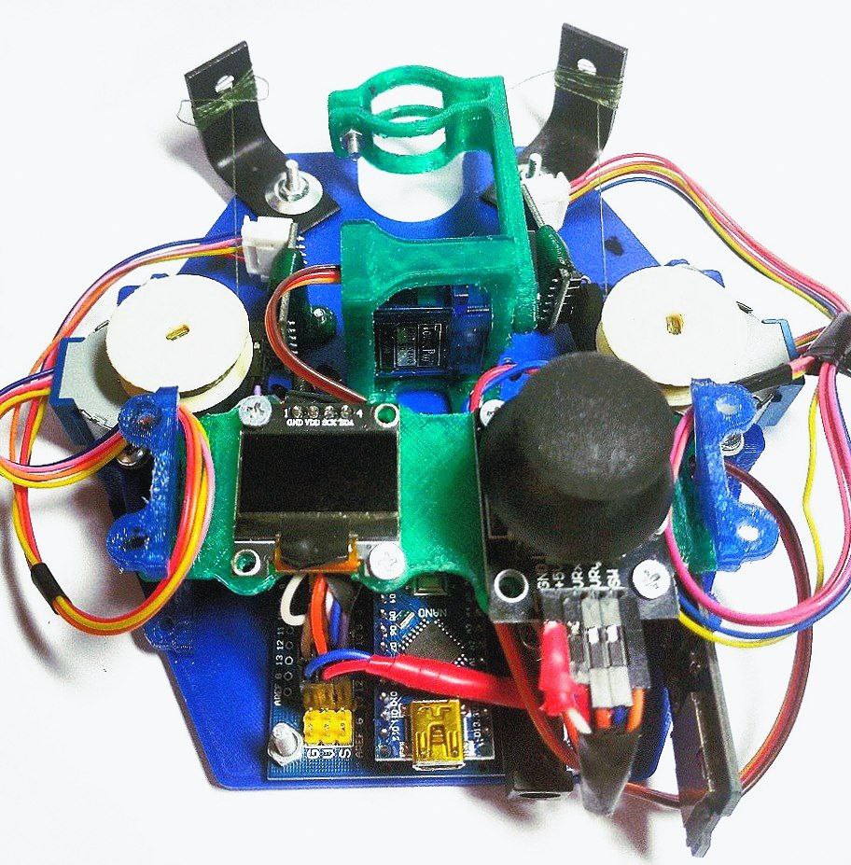
Изображения/Прототип1310Сверху.jpg
