JamahaW/VART-Project/Изображения/Прототип2601.jpg

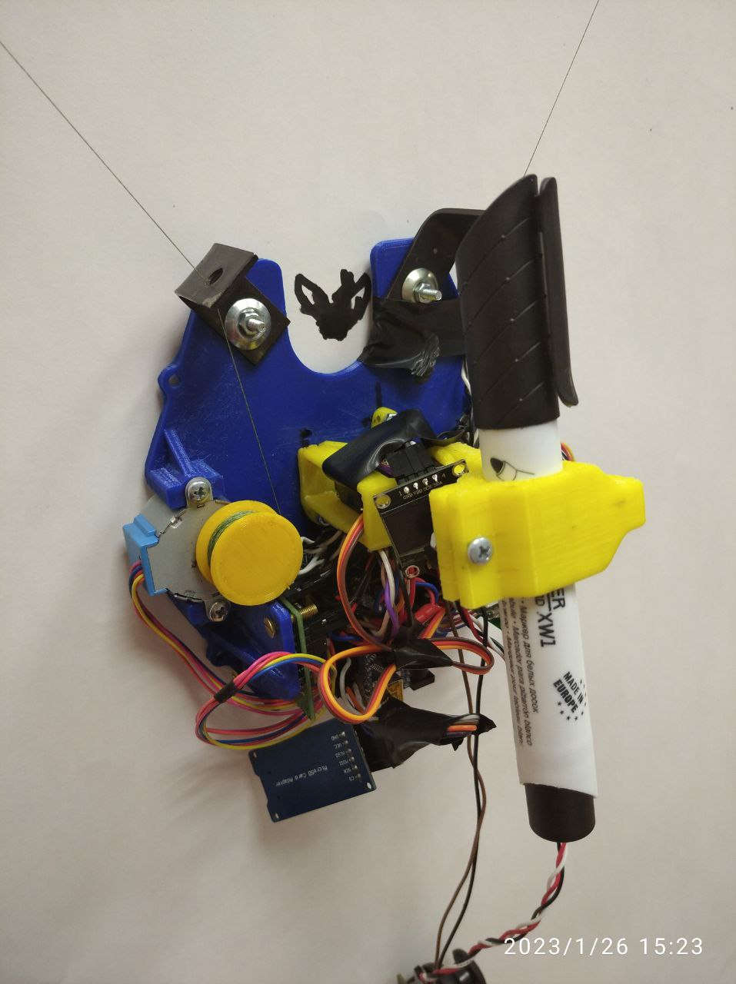
Изображения/Прототип2601.jpg
