JamahaW/VART-Project/Изображения/Прототип2602ВКорпусе.jpg

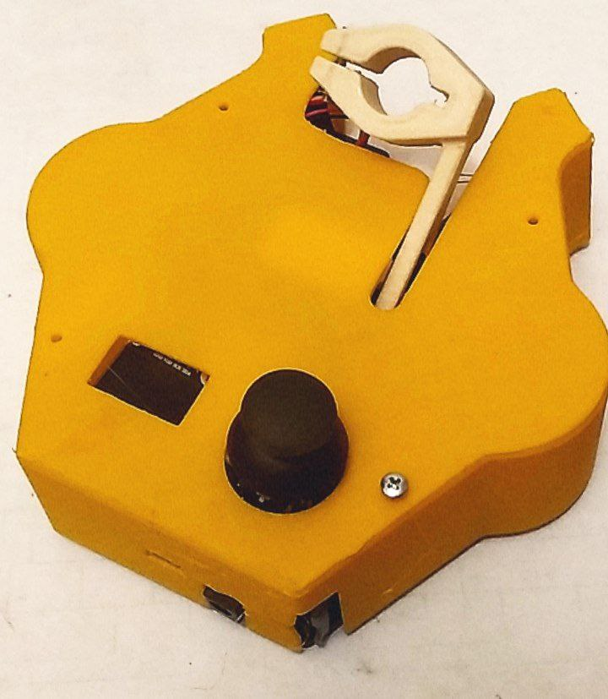
Изображения/Прототип2602ВКорпусе.jpg
