JamahaW/VART-Project/Изображения/Рендер.png

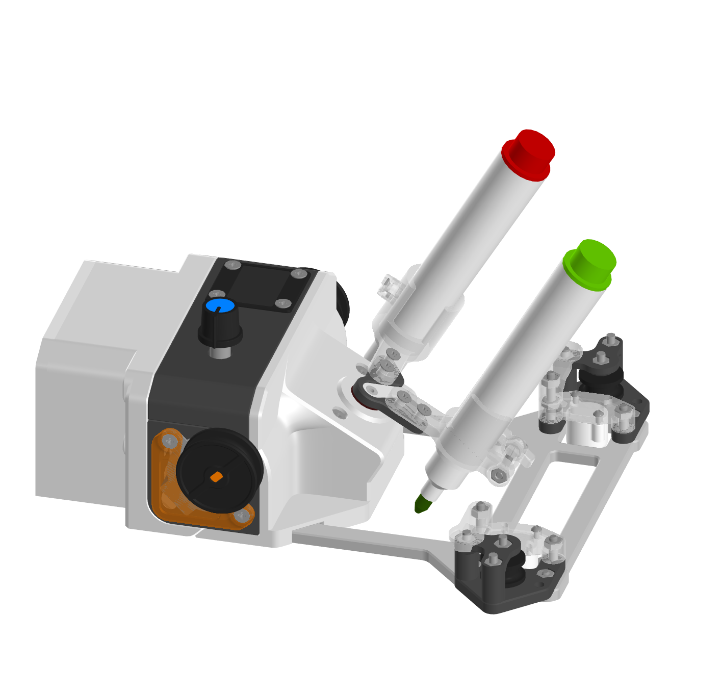
Изображения/Рендер.png
