JamahaW/VART-Project/Изображения/Рисунок4.jpg

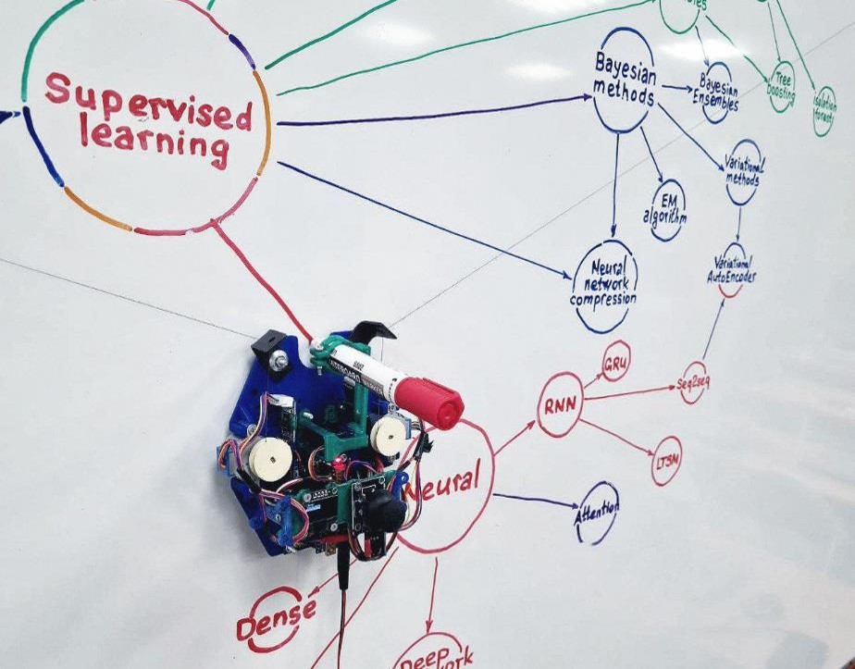
Изображения/Рисунок4.jpg
