JamahaW/VART-Project/Изображения/РучнойТрудКонец.jpg

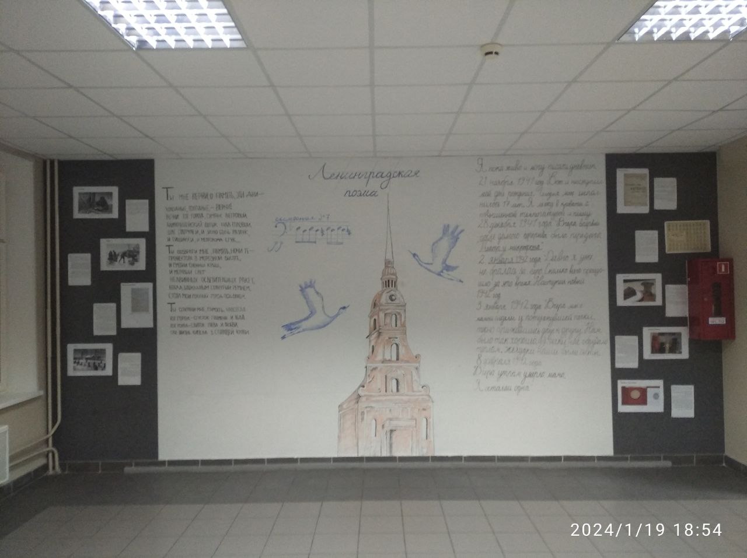
Изображения/РучнойТрудКонец.jpg
