JamahaW/VART-Project/Изображения/СостоянияМеханизмаСменыЦвета.png

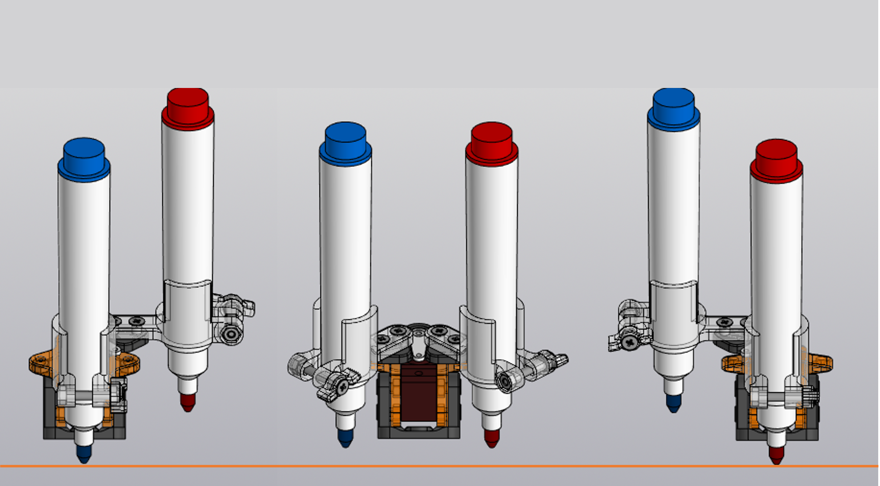
Изображения/СостоянияМеханизмаСменыЦвета.png
