JamahaW/VART-Project/Изображения/СсылкаНаКодПлоттера.png

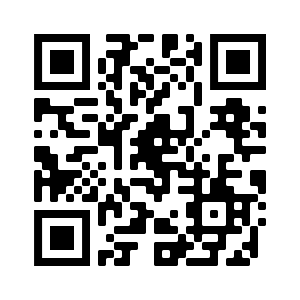
Изображения/СсылкаНаКодПлоттера.png
