JamahaW/VART-Project/Изображения/СхемаПлоттера.png

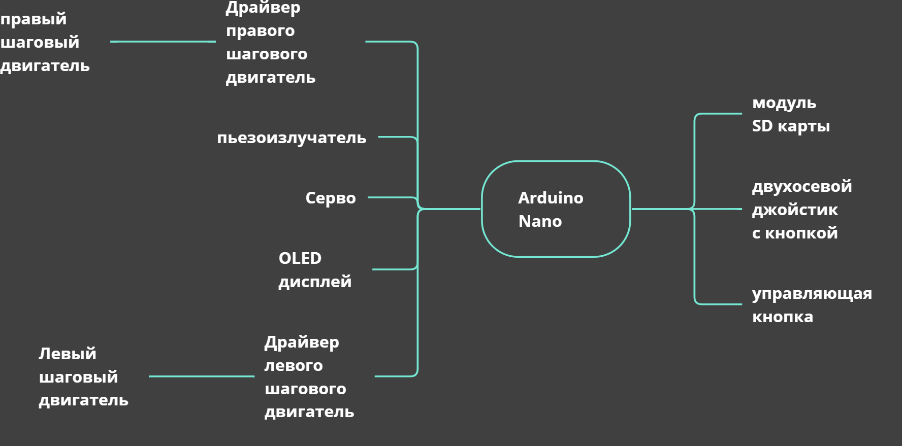
Изображения/СхемаПлоттера.png
