JamahaW/VART-Project/Изображения/Уголоквсборе.png

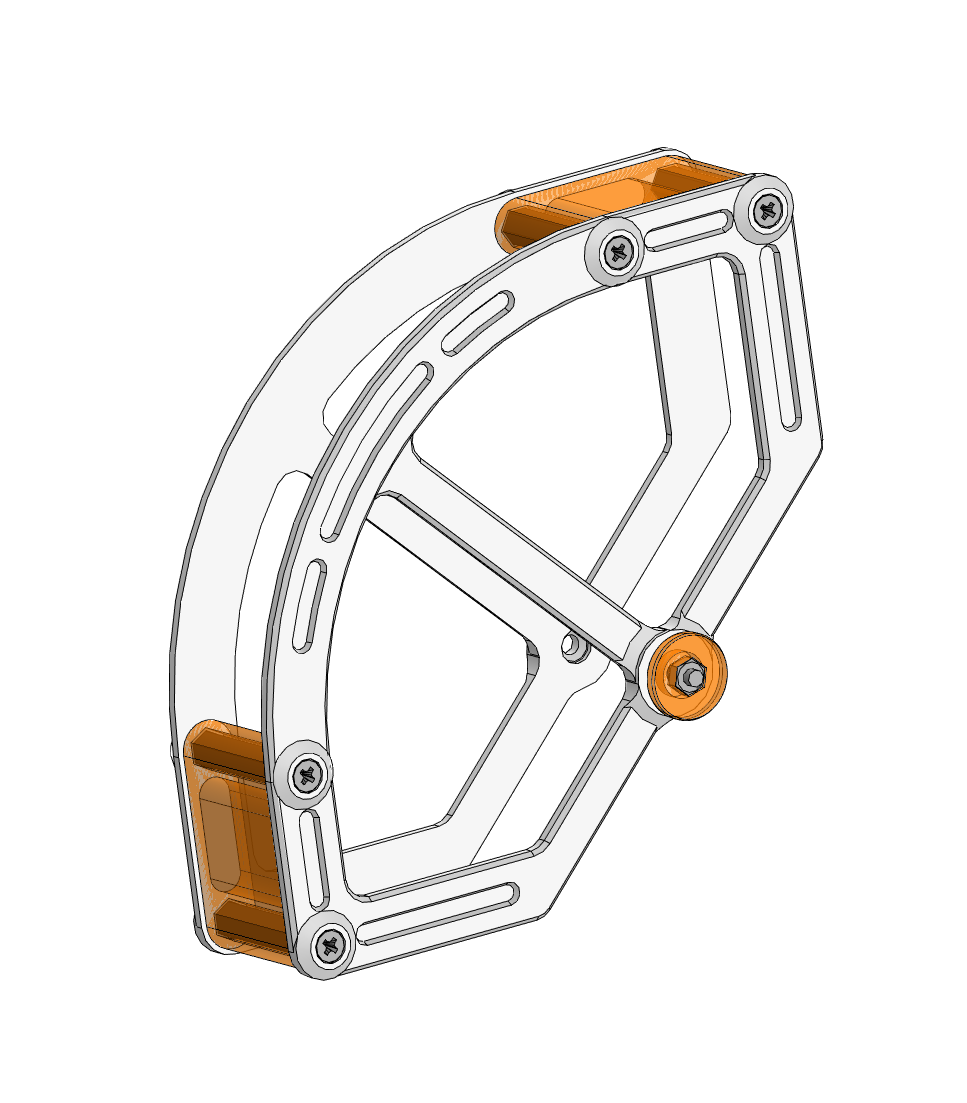
Изображения/Уголоквсборе.png
