JamahaW/VART-Project/Печать/Shassi_V_Sbore__krepyozh_Shassi.stp

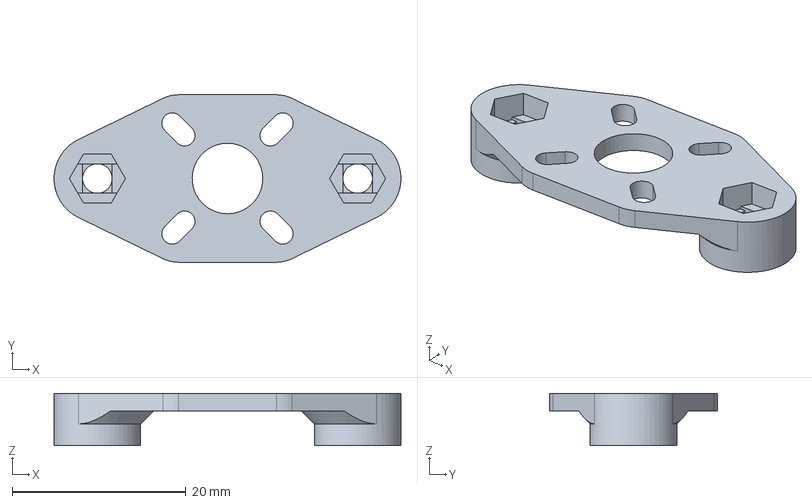
[picture p234: CAD file, 2025-01-20]
Печать/Shassi_V_Sbore__krepyozh_Shassi.stp
40.0 x 19.3 x 6.00 mm
