JamahaW/VART-Project/Печать/Osnovnoy_Blok.dno.stp

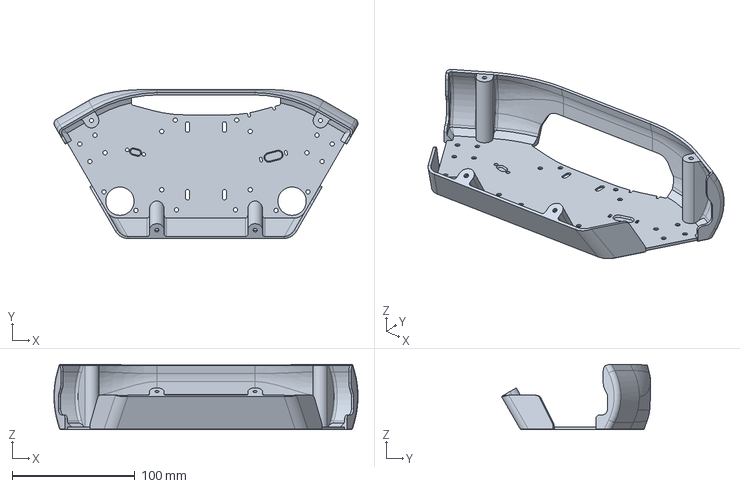
[picture p235: CAD file, 2025-01-20]
Печать/Osnovnoy_Blok.dno.stp
247.2 x 121.3 x 53.1 mm
