JamahaW/VART-Project/Печать/Raspredelitel`__zagrushka_Raspred.stp

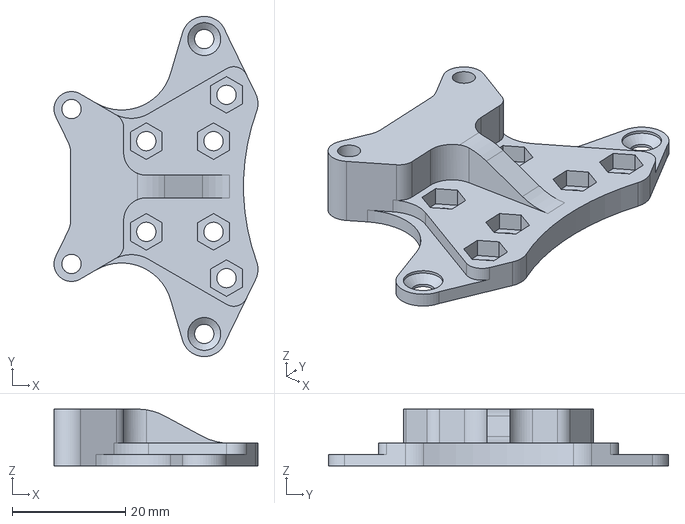
[picture p236: CAD file, 2025-01-20]
Печать/Raspredelitel`__zagrushka_Raspred.stp
36.0 x 60.0 x 10.00 mm
