JamahaW/VART-Project/Печать/Privod_Shkiva__natyazhitel`.stp

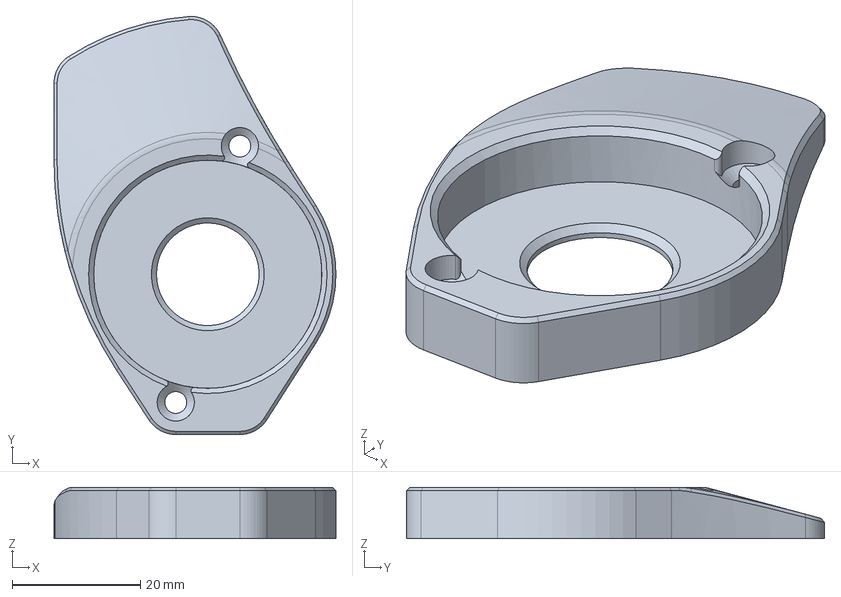
[picture p237: CAD file, 2025-01-20]
Печать/Privod_Shkiva__natyazhitel`.stp
44.0 x 65.2 x 8.00 mm
