JamahaW/VART-Project/Печать/Raspredelitel`__kryshka_Raspred.stp

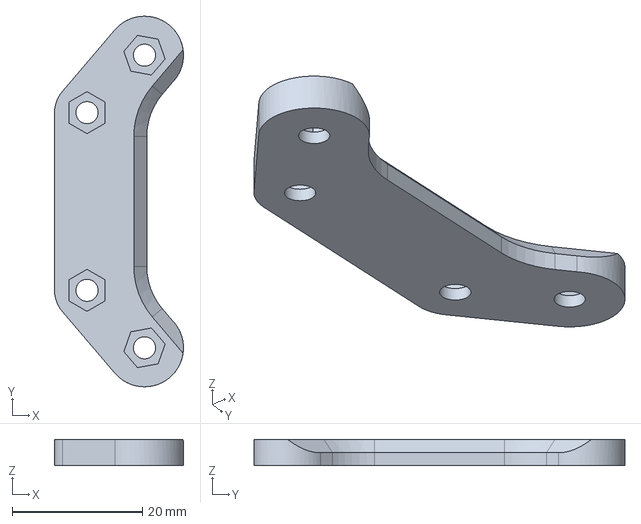
[picture p238: CAD file, 2025-01-20]
Печать/Raspredelitel`__kryshka_Raspred.stp
19.8 x 57.0 x 4.00 mm
