JamahaW/VART-Project/Печать/Privod_Shkiva__rasshiritel`_Ugolka.stp

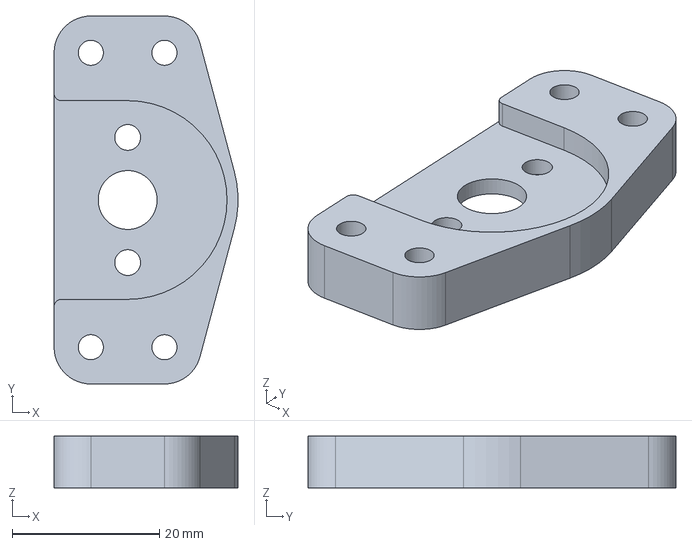
[picture p239: CAD file, 2025-01-20]
Печать/Privod_Shkiva__rasshiritel`_Ugolka.stp
25.0 x 50.0 x 7.00 mm
