JamahaW/VART-Project/Печать/Mk3__kryshka.stp

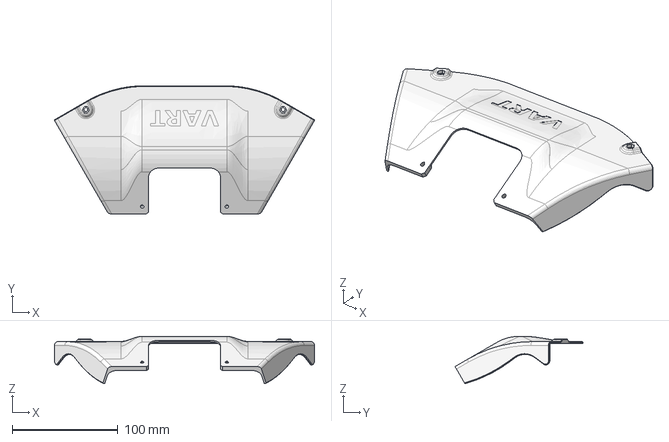
[picture p240: CAD file, 2025-01-20]
Печать/Mk3__kryshka.stp
245.6 x 120.9 x 44.7 mm
