JamahaW/VART-Project/Печать/Mekhanizm_Pechati_Markernyy__kreplenie_Servo.stp

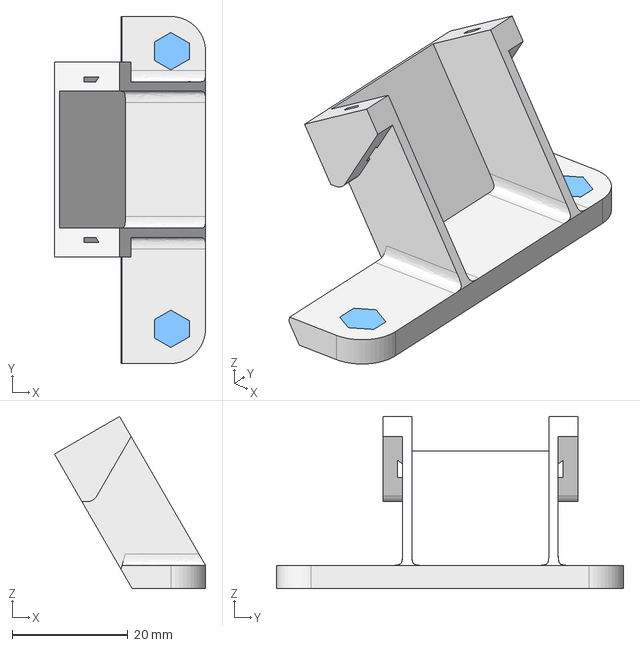
[picture p241: CAD file, 2025-01-20]
Печать/Mekhanizm_Pechati_Markernyy__kreplenie_Servo.stp
26.1 x 60.0 x 29.7 mm
