JamahaW/VART-Project/Печать/Osnovnoy_Blok__prizhim_Akb.stp

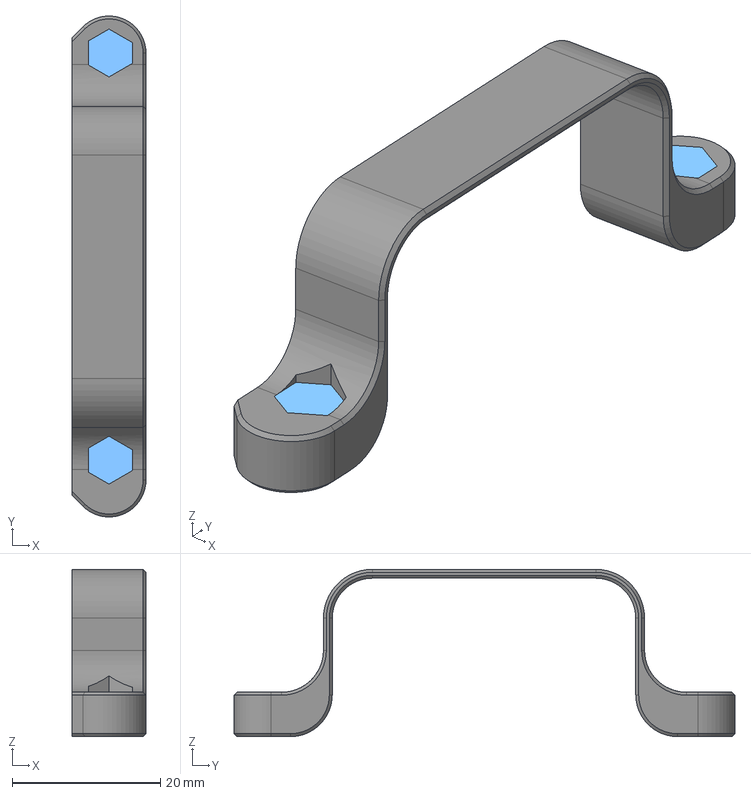
[picture p242: CAD file, 2025-01-20]
Печать/Osnovnoy_Blok__prizhim_Akb.stp
10.0 x 67.7 x 22.6 mm
