JamahaW/VART-Project/Печать/Privod_Shkiva__balka.stp

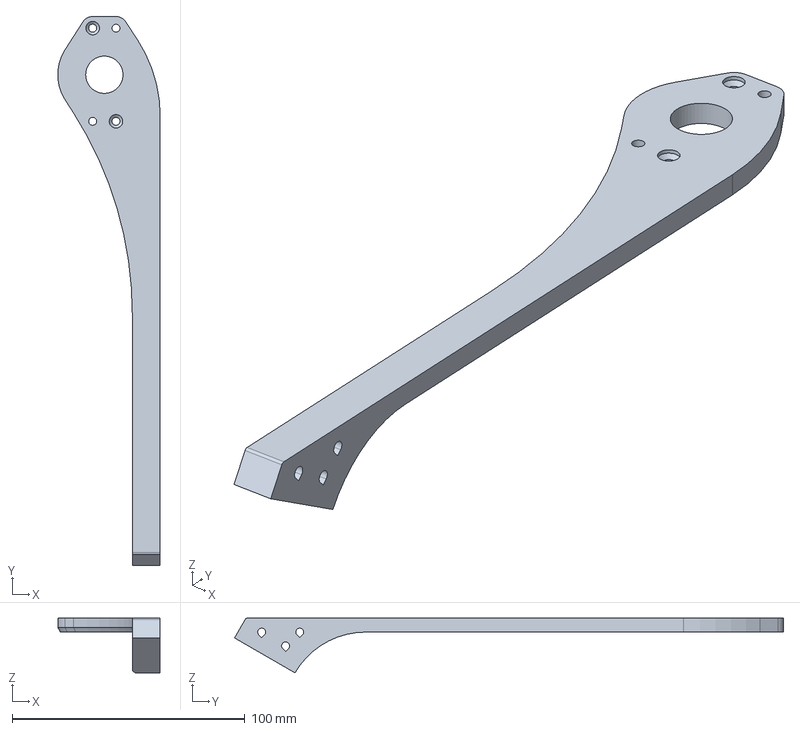
[picture p243: CAD file, 2025-01-20]
Печать/Privod_Shkiva__balka.stp
44.0 x 235.7 x 23.5 mm
