JamahaW/VART-Project/Печать/Panel`_Zadnyaya.kryshka.stp

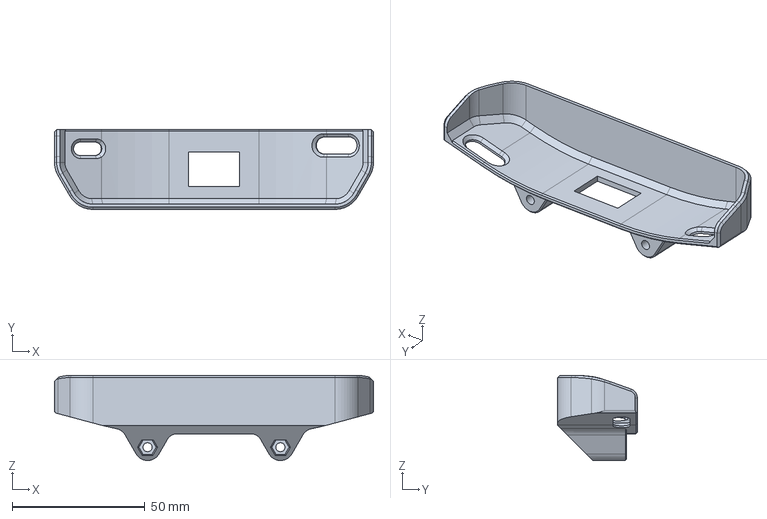
[picture p244: CAD file, 2025-01-20]
Печать/Panel`_Zadnyaya.kryshka.stp
120.0 x 30.0 x 32.0 mm
