JamahaW/VART-Project/Печать/Panel`_Zadnyaya__kryshka_Zadnyaya.stp

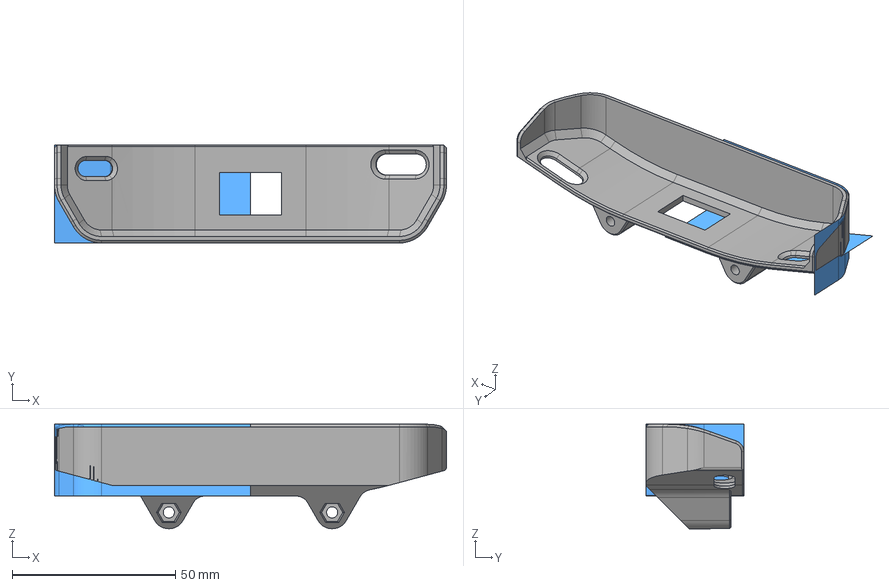
[picture p245: CAD file, 2025-01-20]
Печать/Panel`_Zadnyaya__kryshka_Zadnyaya.stp
120.0 x 30.0 x 32.0 mm
