JamahaW/VART-Project/Печать/Raspredelitel`__osnovanie_Raspereditelya.stp

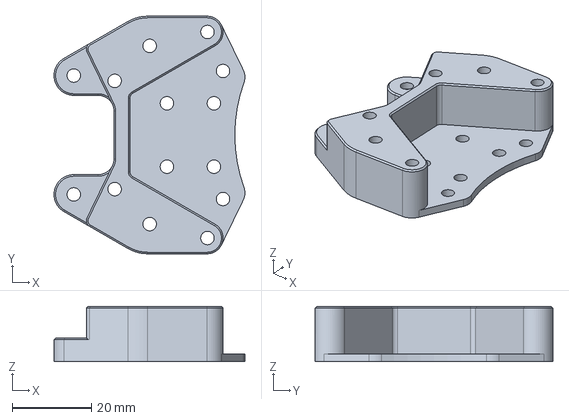
[picture p246: CAD file, 2025-01-20]
Печать/Raspredelitel`__osnovanie_Raspereditelya.stp
48.2 x 60.0 x 14.0 mm
