JamahaW/VART-Project/Изображения/Test_image.png

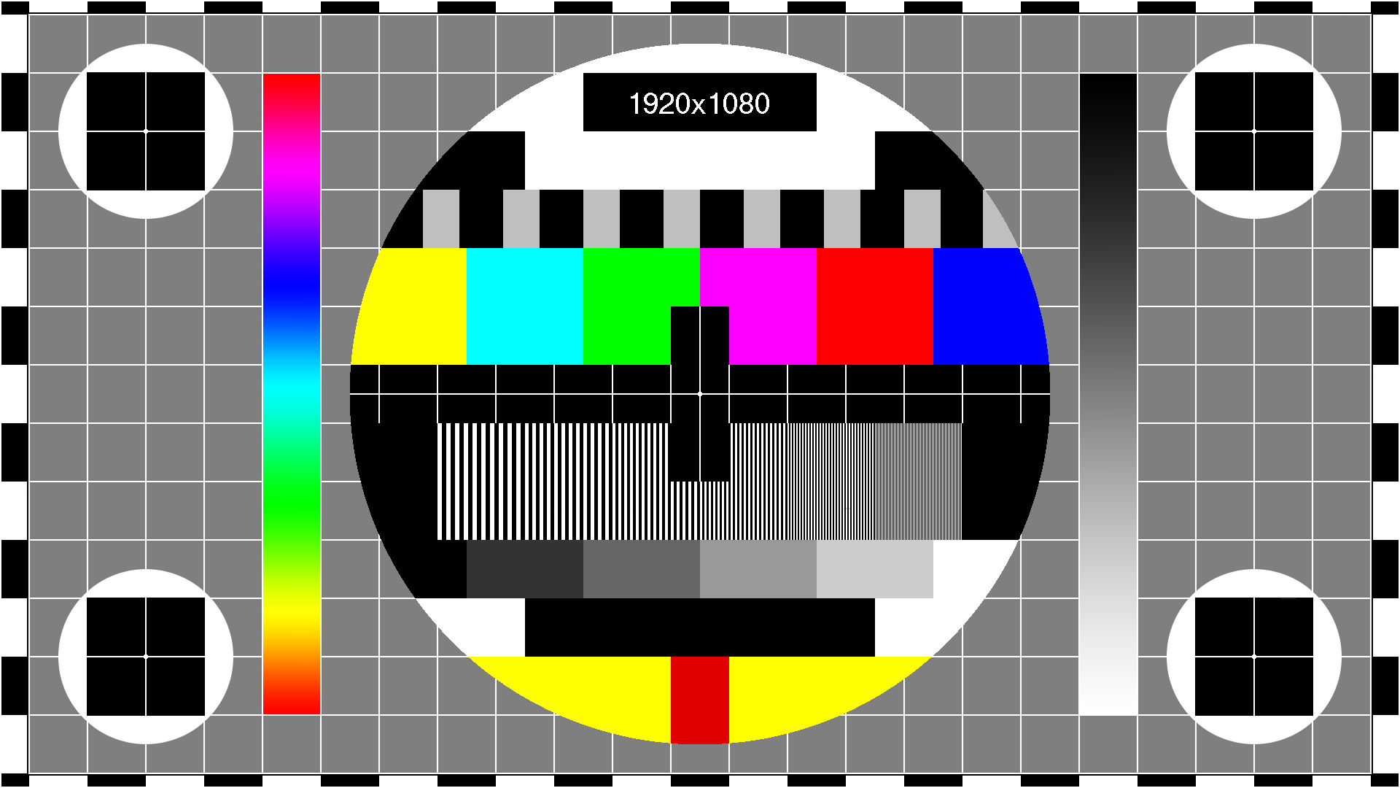
Изображения/Test_image.png
