JamahaW/VART-Project/(commit log)

2024-12-15 Разбиение на модули
2025-01-12 speed regulator sucks
2025-01-12 Регуляторы моторов настроены
2025-01-12 ТЕПЕРЬ регуляторы моторов настроены
2025-01-12 Завершен Рефакторинг регулятора смещения положения
2025-01-12 PositionController.hpp работает отлично
2025-01-12 PositionController.hpp работает отлично 2.0
2025-01-20 pulleys OK
2025-01-26 частичная миграция на UI2
2025-02-09 page ref ok 2. bug: PageSetterButton widget добавляется в конце списка ввиду измененного способа построения страниц. Необходимо создать виртуальный метод для построения страниц, который будет вызыват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
    [MovementServicePage.cpp, PrintingPage.cpp, WorkAreaPage.cpp, main.cpp]
2025-02-09 page ref ok 3. bug: PageSetterButton widget в конце. - Создать ChildPage реализацию
    [MainPage.cpp, MediaPage.cpp, main.cpp]
2025-02-09 mass ui ref fix etc.//
    [MainPage.cpp, MediaPage.cpp, MovementServicePage.cpp, PrintingPage.cpp]
